GeorgeKonovalov/Daedalus-group---Maze-Solver---Team-Skynet/3D_Model/Downloaded files/switch/Renders/Render 1.jpg

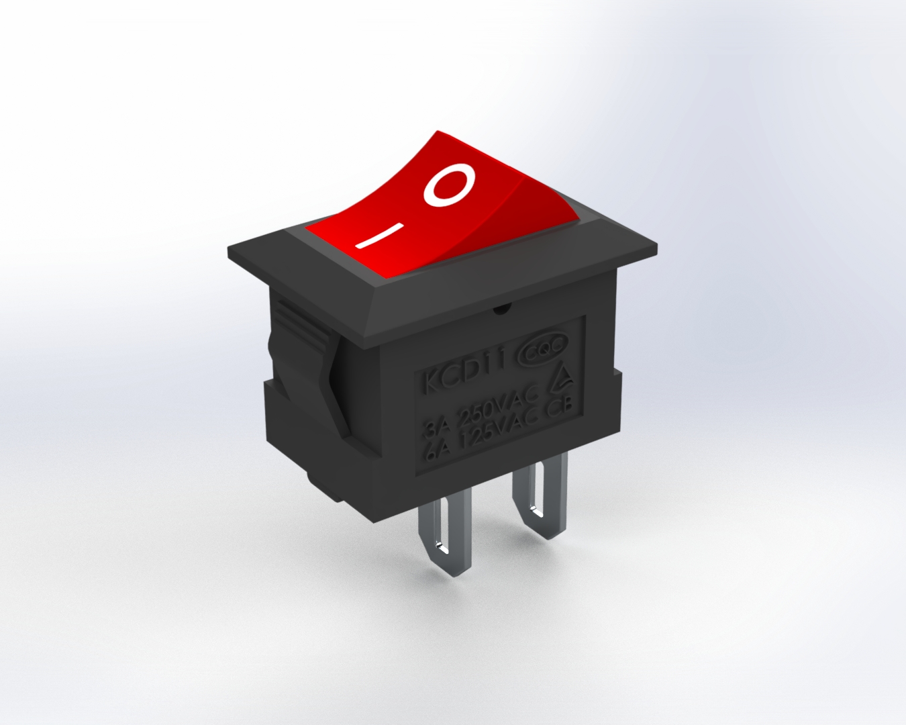
3D_Model/Downloaded files/switch/Renders/Render 1.jpg
