GeorgeKonovalov/Daedalus-group---Maze-Solver---Team-Skynet/3D_Model/Downloaded files/Servo/Renderings/Parallax Servo.PNG

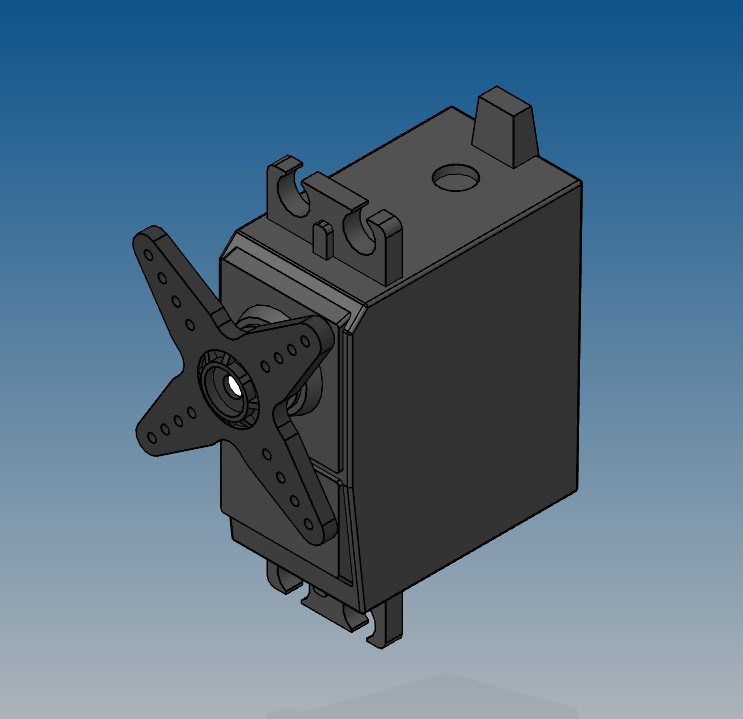
3D_Model/Downloaded files/Servo/Renderings/Parallax Servo.PNG
