GeorgeKonovalov/Daedalus-group---Maze-Solver---Team-Skynet/README.md

# Daedalus-group---Maze-Solver---Team-Skynet
2nd year project maze solver
