GeorgeKonovalov/Daedalus-group---Maze-Solver---Team-Skynet/3D_Model/Blueprint.png

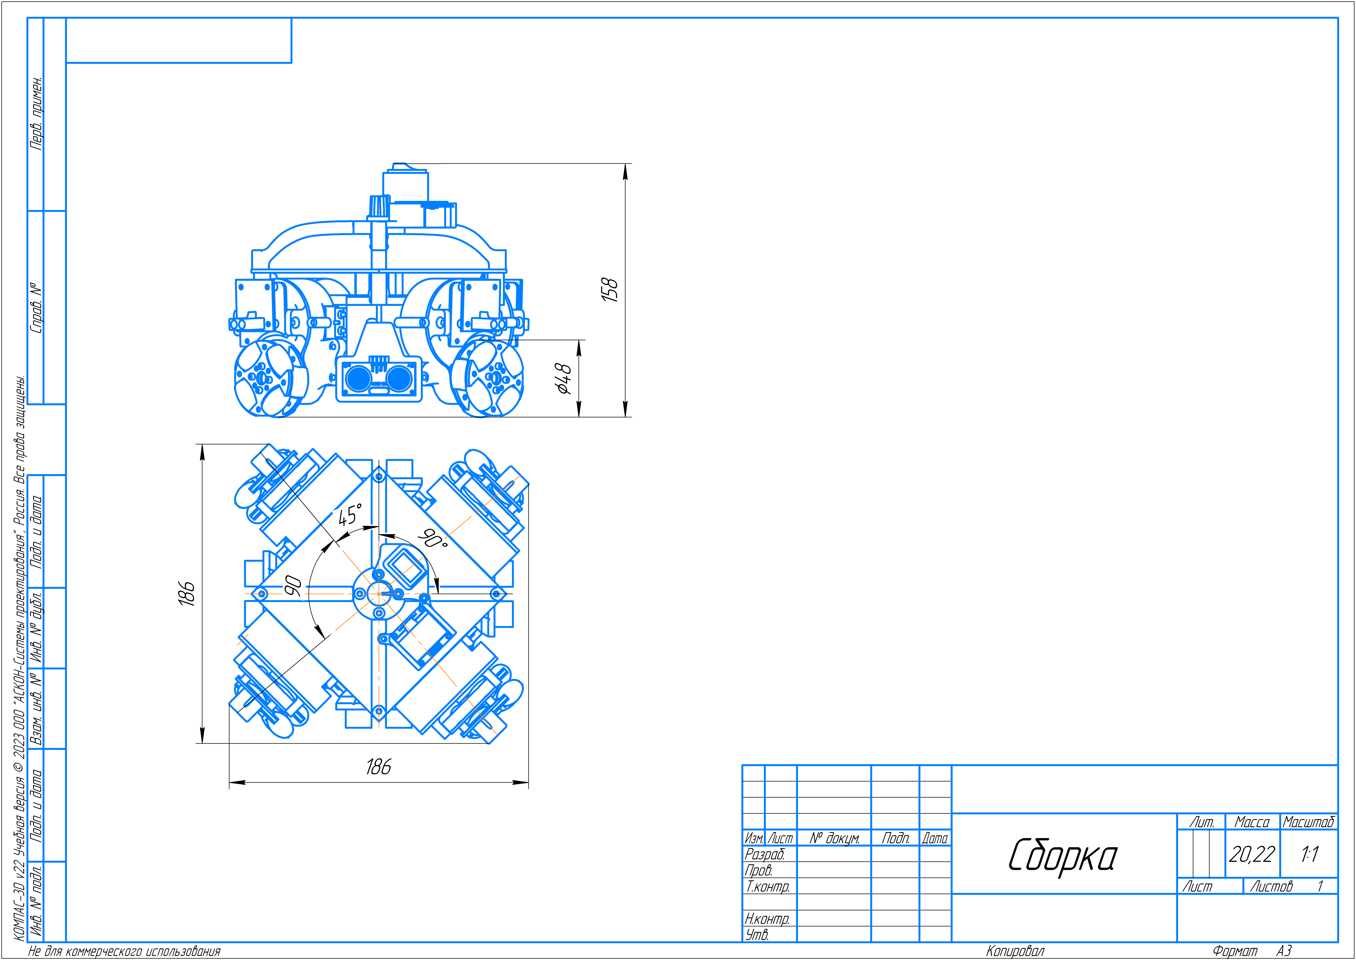
3D_Model/Blueprint.png
