GeorgeKonovalov/Daedalus-group---Maze-Solver---Team-Skynet/3D_Model/Downloaded files/knob/Потенциометр Ручка.JPG

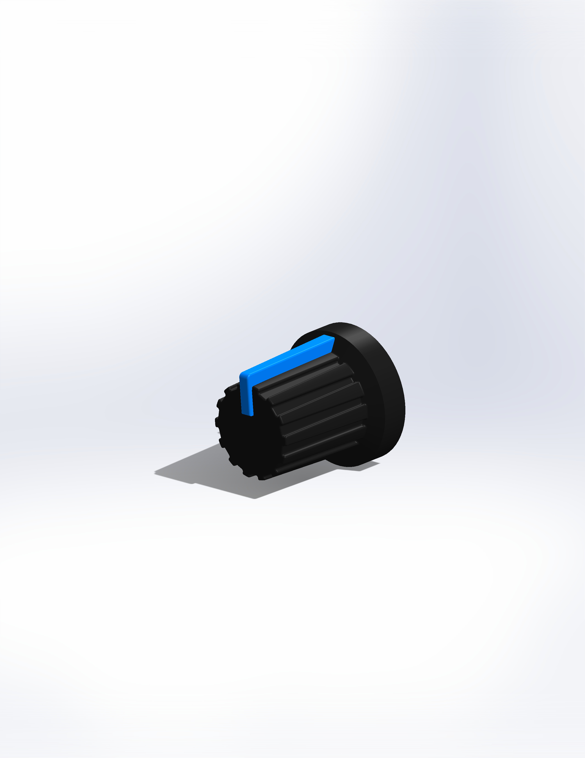
3D_Model/Downloaded files/knob/Потенциометр Ручка.JPG
