GeorgeKonovalov/Daedalus-group---Maze-Solver---Team-Skynet/3D_Model/Downloaded files/Omni/Untitled1.JPG

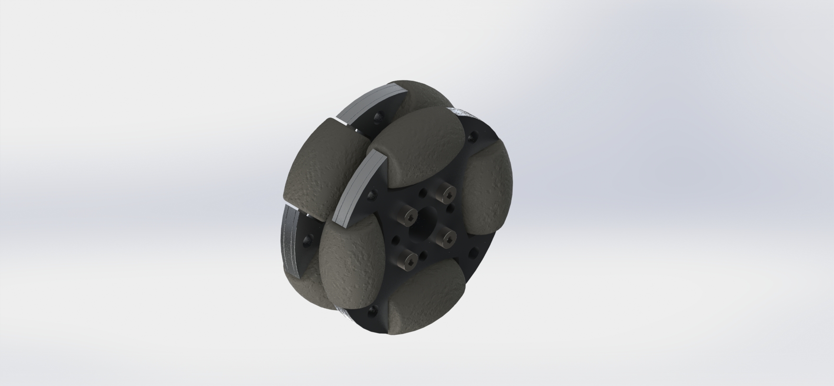
3D_Model/Downloaded files/Omni/Untitled1.JPG
