GeorgeKonovalov/Daedalus-group---Maze-Solver---Team-Skynet/3D_Model/Downloaded files/screws/M3.JPG

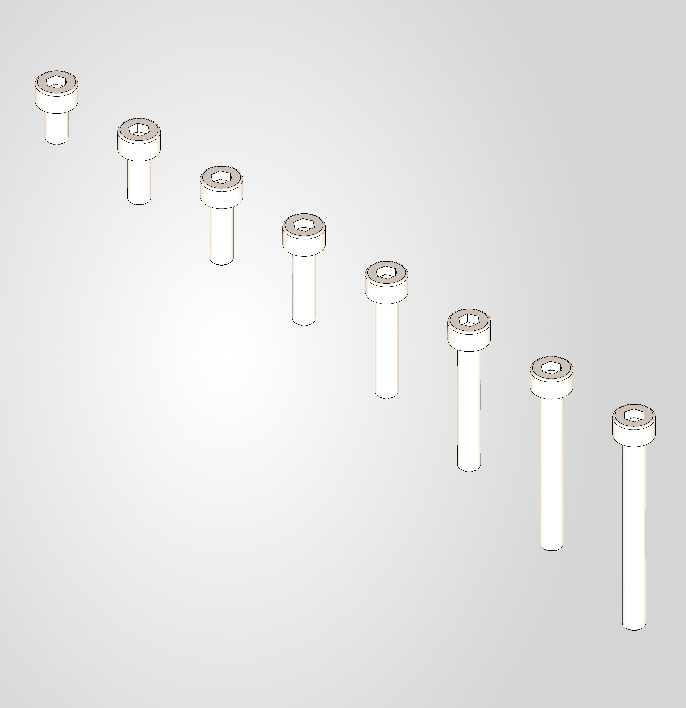
3D_Model/Downloaded files/screws/M3.JPG
