GeorgeKonovalov/Daedalus-group---Maze-Solver---Team-Skynet/3D_Model/Downloaded files/switch/Renders/Render 2.jpg

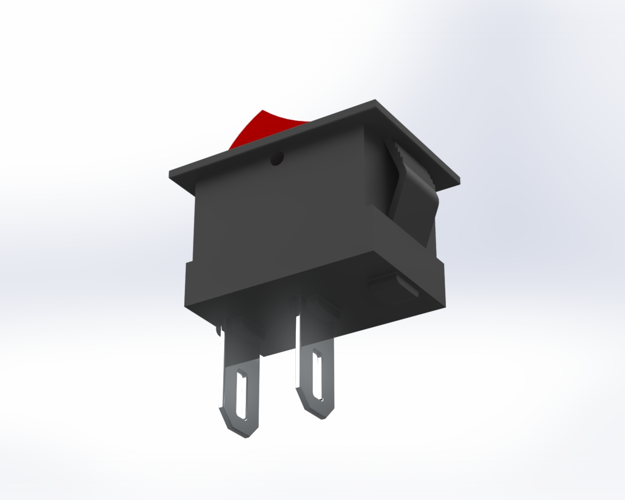
3D_Model/Downloaded files/switch/Renders/Render 2.jpg
