GeorgeKonovalov/Daedalus-group---Maze-Solver---Team-Skynet/Software/event_maze_solver.drawio.png

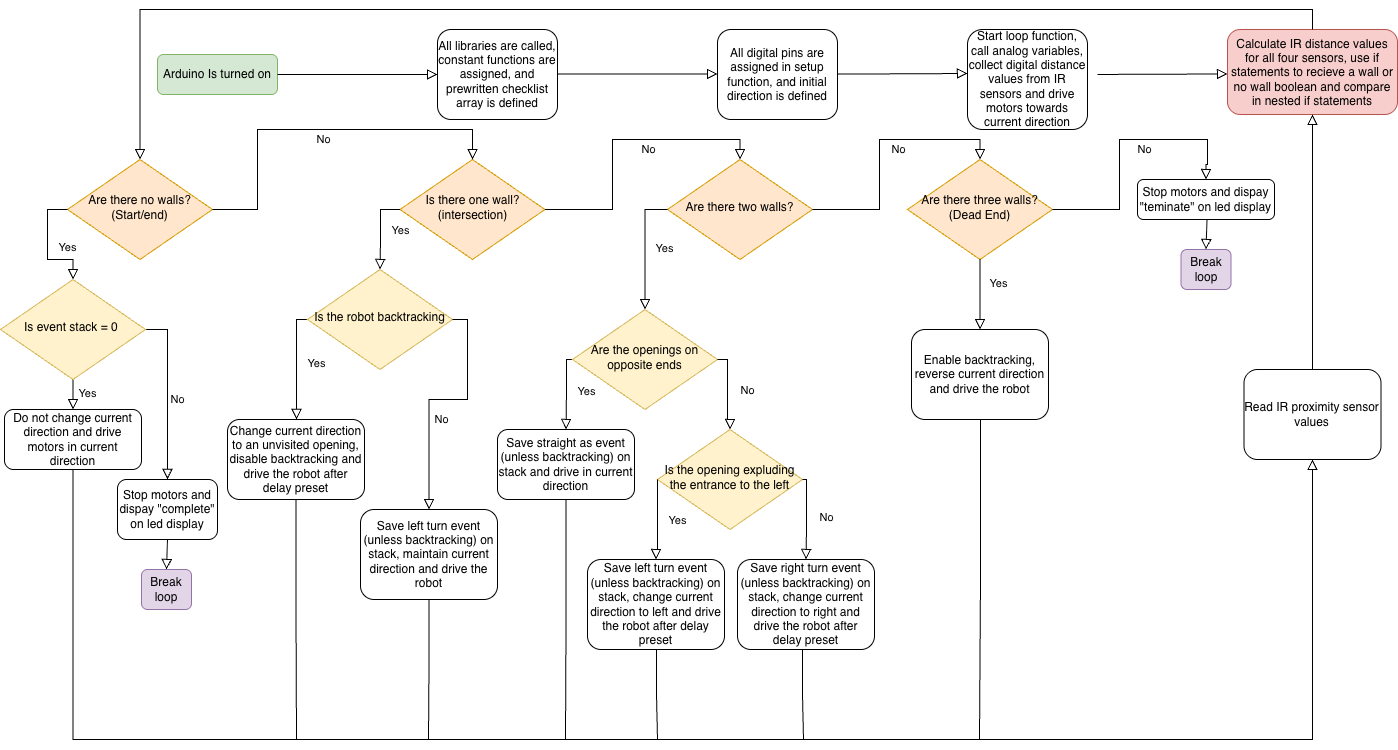
Software/event_maze_solver.drawio.png
