GeorgeKonovalov/Daedalus-group---Maze-Solver---Team-Skynet/Software/TEST Codes/RP2040/test_full/v_71/test_full_v67_deadend_ultra_start_2wall_zero_ramp/png/06_6_event_recognition_overview.png

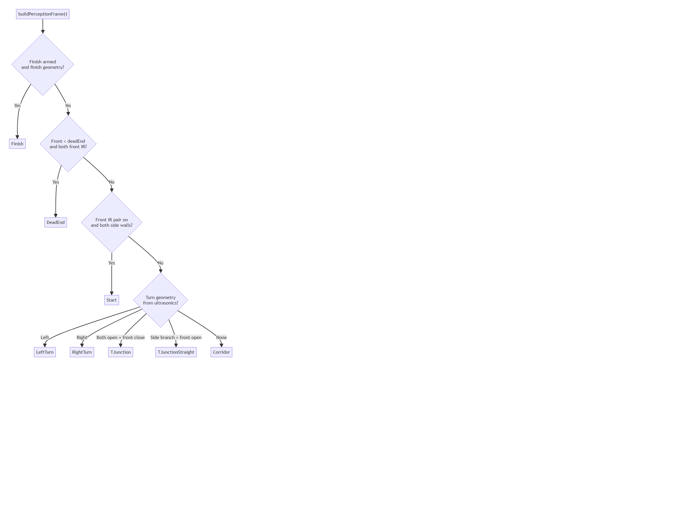
Software/TEST Codes/RP2040/test_full/v_71/test_full_v67_deadend_ultra_start_2wall_zero_ramp/png/06_6_event_recognition_overview.png
