GeorgeKonovalov/Daedalus-group---Maze-Solver---Team-Skynet/Software/TEST Codes/RP2040/test_full/v_71/test_full_v67_deadend_ultra_start_2wall_zero_ramp/png_logic_schemes/10_menu_architecture.png

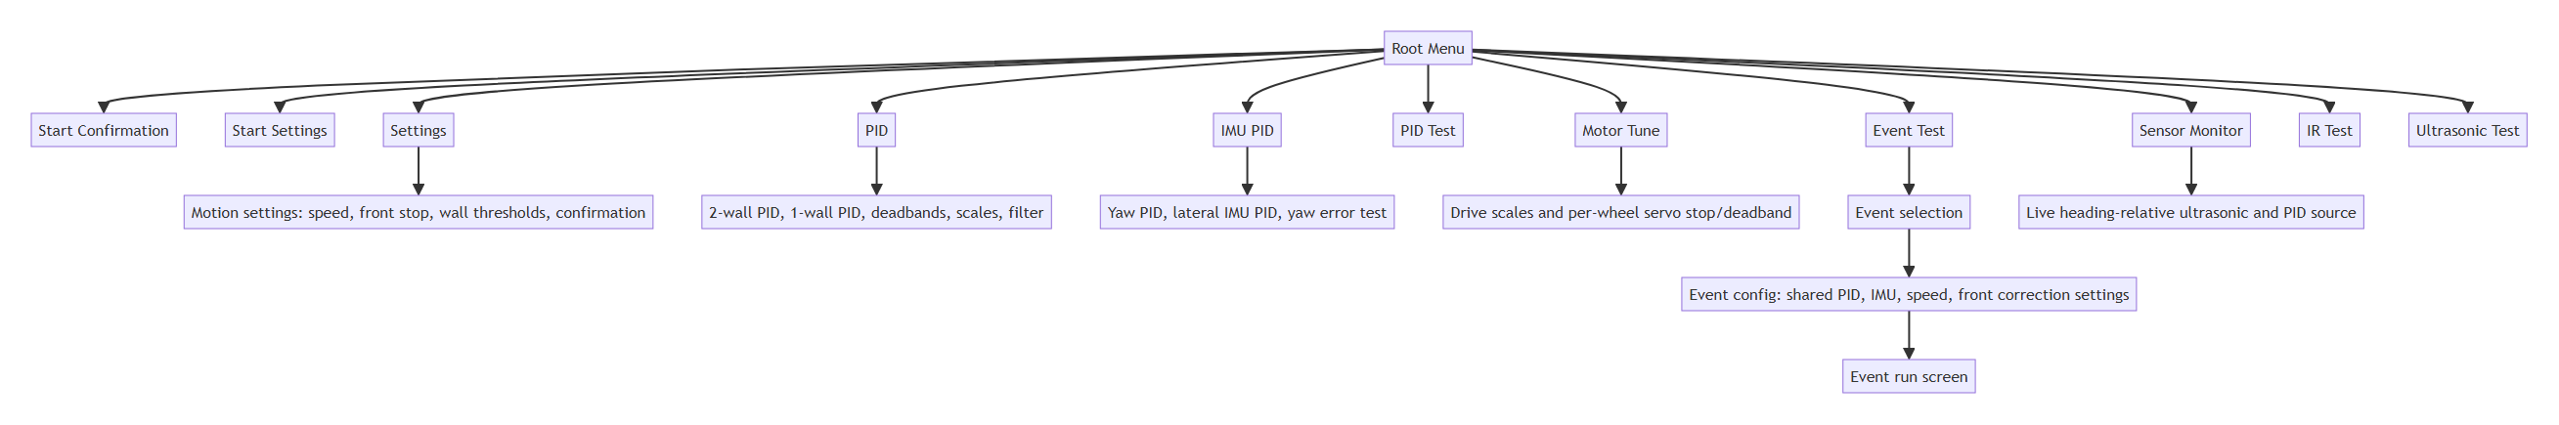
Software/TEST Codes/RP2040/test_full/v_71/test_full_v67_deadend_ultra_start_2wall_zero_ramp/png_logic_schemes/10_menu_architecture.png
