GeorgeKonovalov/Daedalus-group---Maze-Solver---Team-Skynet/3D_Model/Downloaded files/Omni/Roller_TPU_PLA/Assembled_roller_2_parts.stp

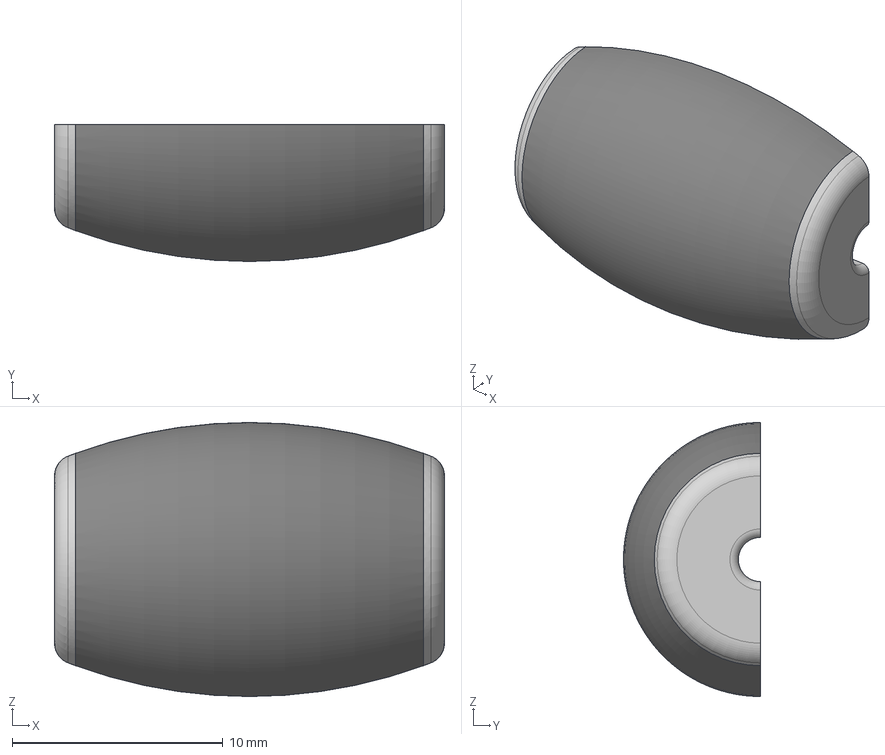
[picture p13: CAD file, 2026-04-03]
3D_Model/Downloaded files/Omni/Roller_TPU_PLA/Assembled_roller_2_parts.stp
18.5 x 6.50 x 13.0 mm
Roller
