GeorgeKonovalov/Daedalus-group---Maze-Solver---Team-Skynet/3D_Model/Downloaded files/Omni/Assembly48mm.STEP

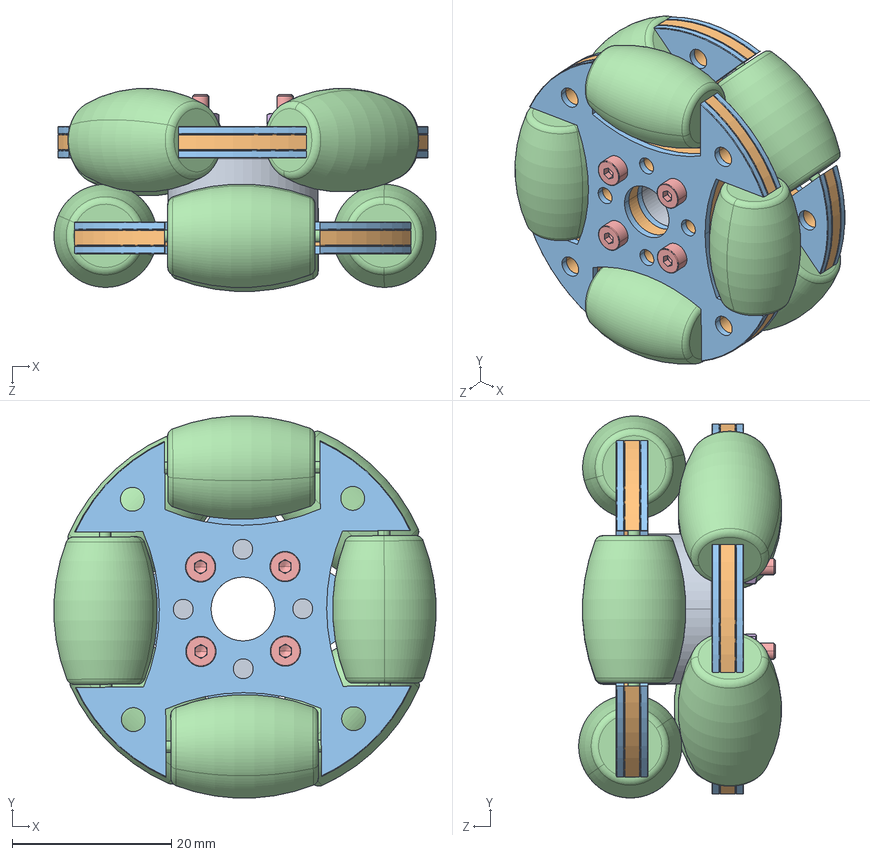
[picture p14: CAD file, 2026-02-12]
3D_Model/Downloaded files/Omni/Assembly48mm.STEP
47.9 x 47.9 x 25.4 mm
lock
Middle_2mm x 2
Middle_1mm x 4
Roller x 8
socket head cap screw_iso_ISO 4762 M2 x 20 - 16N x 4
hex nut style 1 gradeab_iso_ISO - 4032 - M2 - W - N x 4
