GeorgeKonovalov/Daedalus-group---Maze-Solver---Team-Skynet/3D_Model/Downloaded files/Omni/Roller_TPU_PLA/Assembled_roller_2_parts_renewed.stp

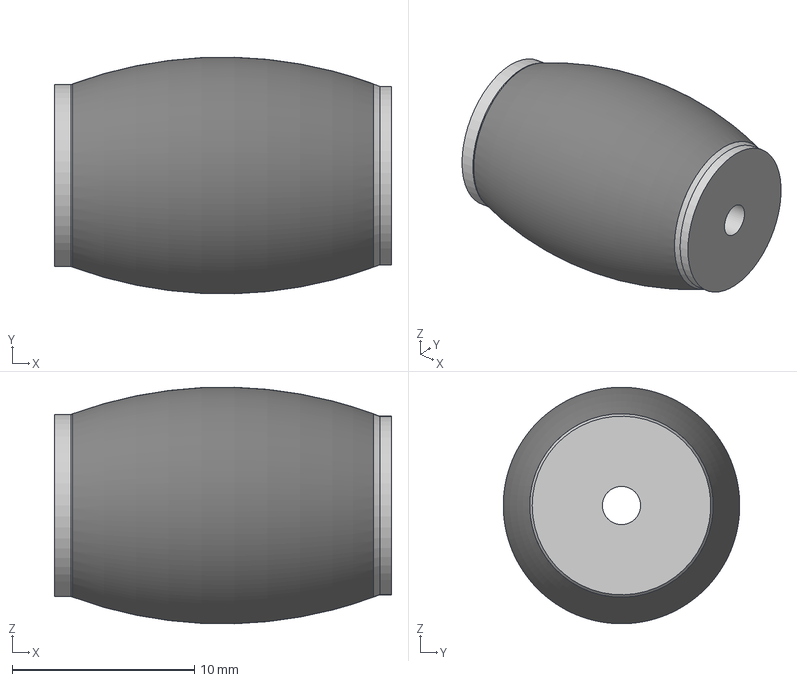
[picture p15: CAD file, 2026-04-03]
3D_Model/Downloaded files/Omni/Roller_TPU_PLA/Assembled_roller_2_parts_renewed.stp
18.5 x 13.0 x 13.0 mm
Roller
