GeorgeKonovalov/Daedalus-group---Maze-Solver---Team-Skynet/3D_Model/Battery/Battery_Cap.stl

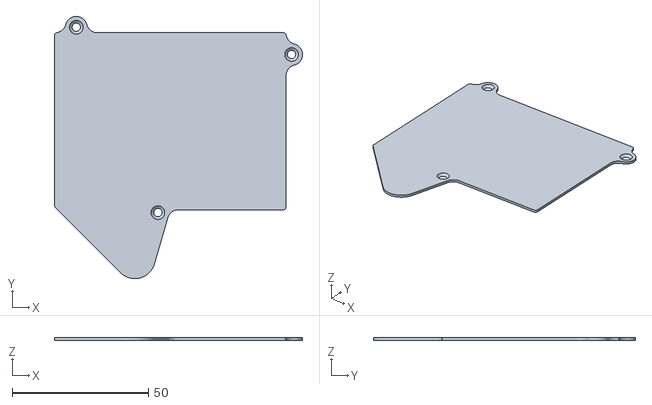
[picture p16: CAD file, 2026-02-12]
3D_Model/Battery/Battery_Cap.stl
91.0 x 96.2 x 1.00
