GeorgeKonovalov/Daedalus-group---Maze-Solver---Team-Skynet/3D_Model/Downloaded files/knob/Потенциометр Ручка.STEP

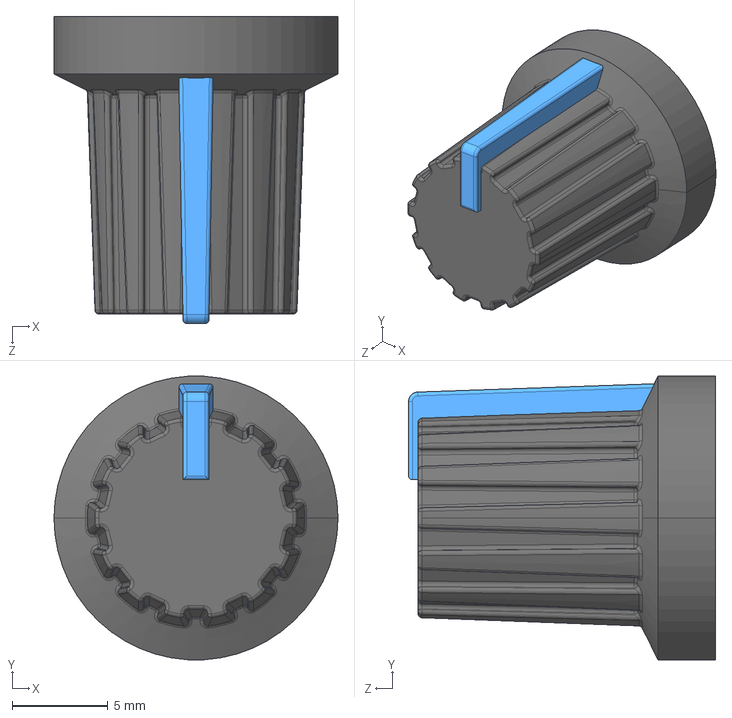
[picture p17: CAD file, 2026-04-20]
3D_Model/Downloaded files/knob/Потенциометр Ручка.STEP
14.8 x 14.8 x 16.0 mm
