GeorgeKonovalov/Daedalus-group---Maze-Solver---Team-Skynet/3D_Model/Downloaded files/Omni/lock.SLDPRT

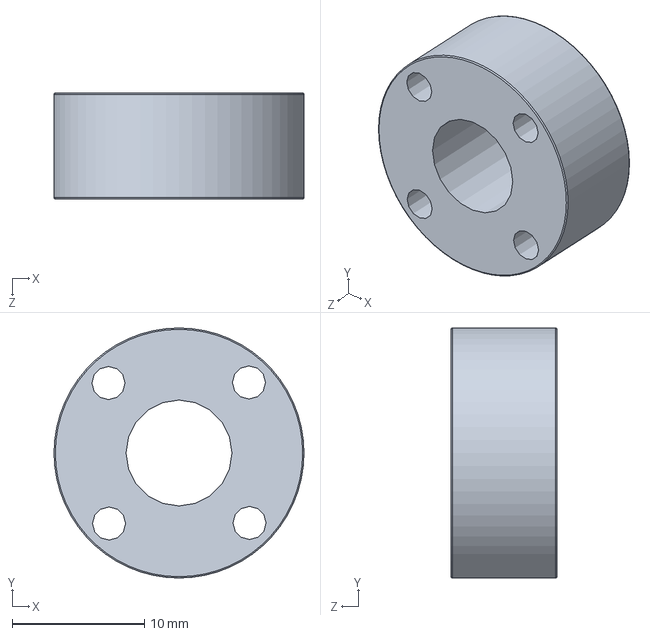
[picture p18: CAD file, 2026-02-12]
3D_Model/Downloaded files/Omni/lock.SLDPRT
18.9 x 18.9 x 8.00 mm
