GeorgeKonovalov/Daedalus-group---Maze-Solver---Team-Skynet/3D_Model/Downloaded files/switch/Power Switch.STEP

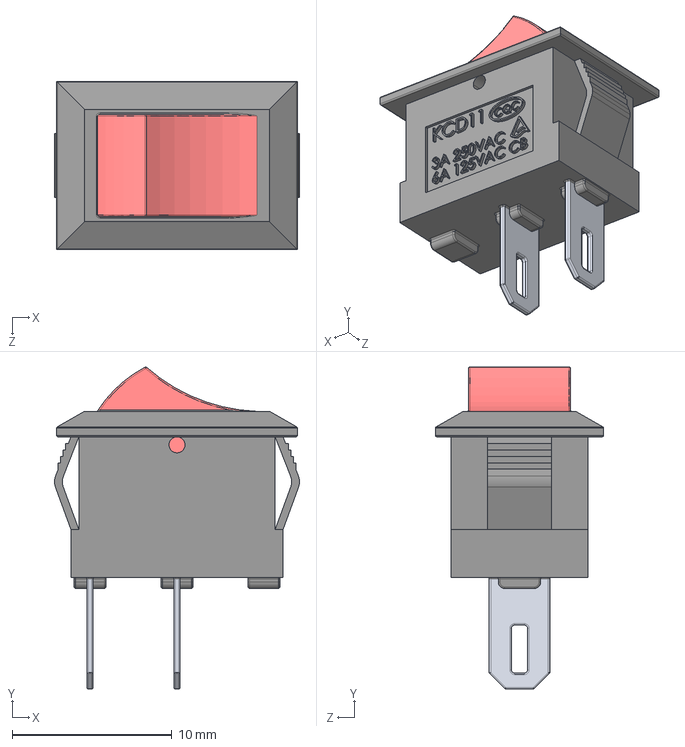
[picture p19: CAD file, 2026-04-20]
3D_Model/Downloaded files/switch/Power Switch.STEP
15.4 x 20.2 x 10.6 mm
