GeorgeKonovalov/Daedalus-group---Maze-Solver---Team-Skynet/3D_Model/Exp.print/H2D_5h11m_Rollers_PLA_TPU.3mf

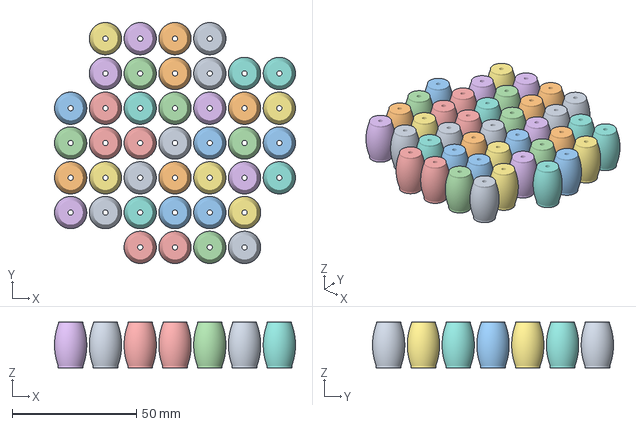
[picture p20: CAD file, 2026-04-03]
3D_Model/Exp.print/H2D_5h11m_Rollers_PLA_TPU.3mf
97.0 x 97.0 x 18.5 mm
Assembled_roller_2_parts_renewed.stp x 41
