GeorgeKonovalov/Daedalus-group---Maze-Solver---Team-Skynet/3D_Model/Shassis_Base/Mecanum_wheel_60mm_model_aprox.stl

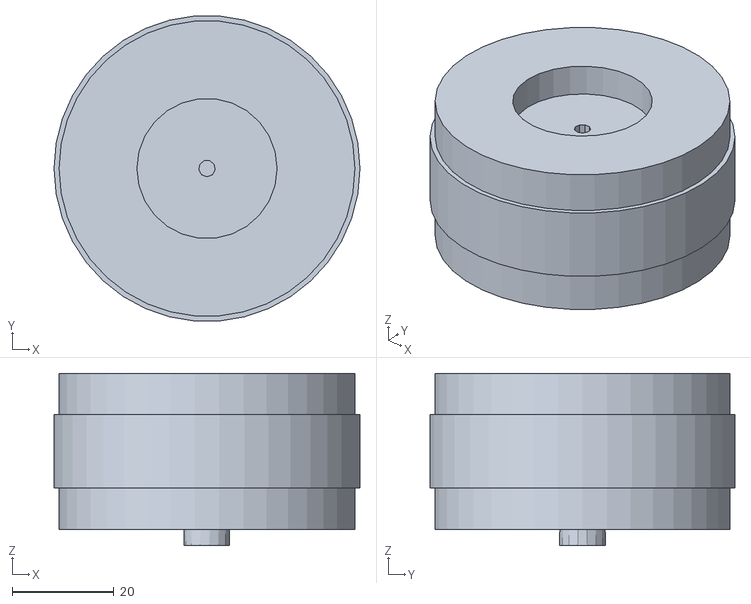
[picture p21: CAD file, 2025-11-28]
3D_Model/Shassis_Base/Mecanum_wheel_60mm_model_aprox.stl
60.0 x 59.8 x 33.8
