GeorgeKonovalov/Daedalus-group---Maze-Solver---Team-Skynet/3D_Model/STL_Prints/01.04.2026/Switch_toggle_Holder.stl

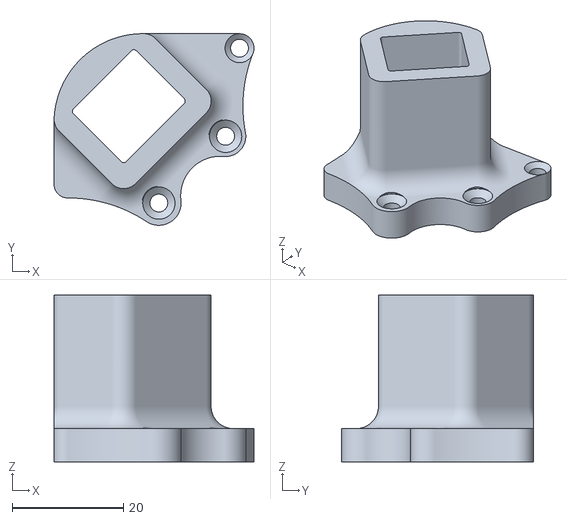
[picture p22: CAD file, 2026-04-06]
3D_Model/STL_Prints/01.04.2026/Switch_toggle_Holder.stl
35.9 x 34.4 x 30.0
