GeorgeKonovalov/Daedalus-group---Maze-Solver---Team-Skynet/3D_Model/STL_Prints/02.02.2026/Lead Gear.stl

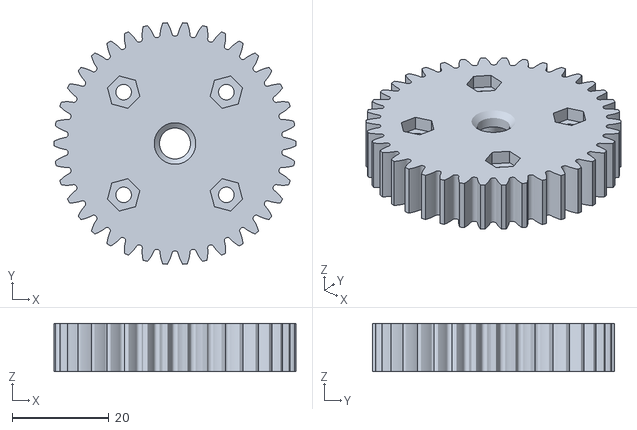
[picture p23: CAD file, 2026-02-12]
3D_Model/STL_Prints/02.02.2026/Lead Gear.stl
50.0 x 49.9 x 10.0
