GeorgeKonovalov/Daedalus-group---Maze-Solver---Team-Skynet/3D_Model/STL_Prints/02.03.2026/Middle_1.85mm.stl

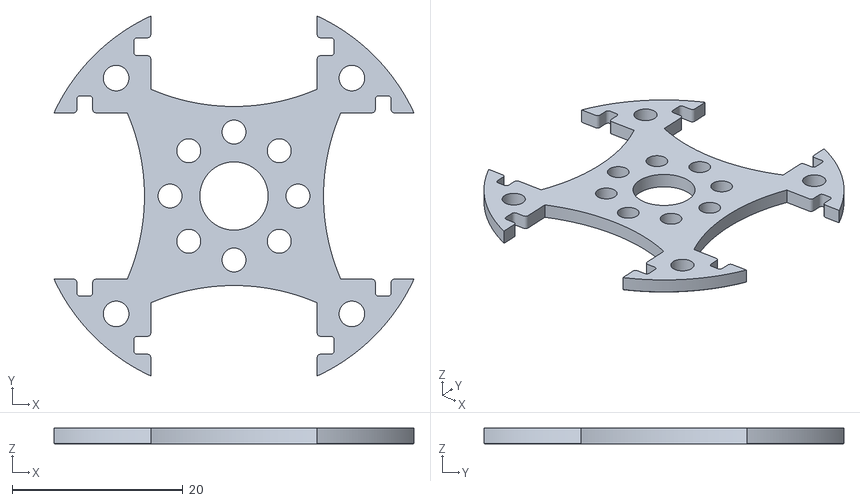
[picture p24: CAD file, 2026-04-03]
3D_Model/STL_Prints/02.03.2026/Middle_1.85mm.stl
42.2 x 42.2 x 1.85
