GeorgeKonovalov/Daedalus-group---Maze-Solver---Team-Skynet/3D_Model/STL_Prints/04.03.2026/49min_IR_PCB_holder.3mf

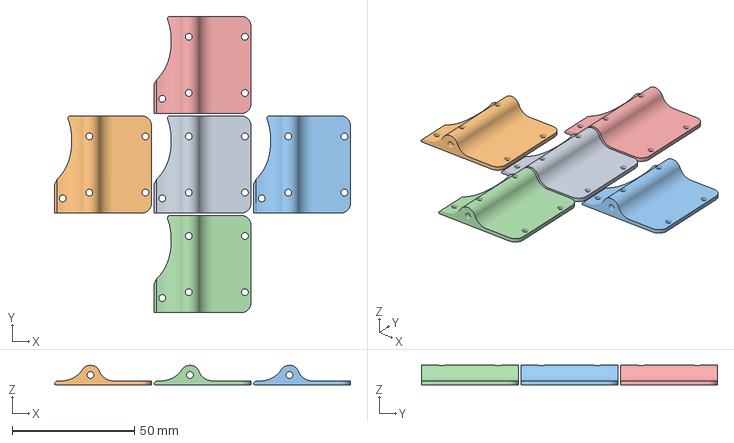
[picture p25: CAD file, 2026-04-03]
3D_Model/STL_Prints/04.03.2026/49min_IR_PCB_holder.3mf
121.2 x 121.4 x 8.00 mm
IR_PCB_holder.stl x 5
