GeorgeKonovalov/Daedalus-group---Maze-Solver---Team-Skynet/3D_Model/STL_Prints/07.02.2026/Middle_1mm.stl

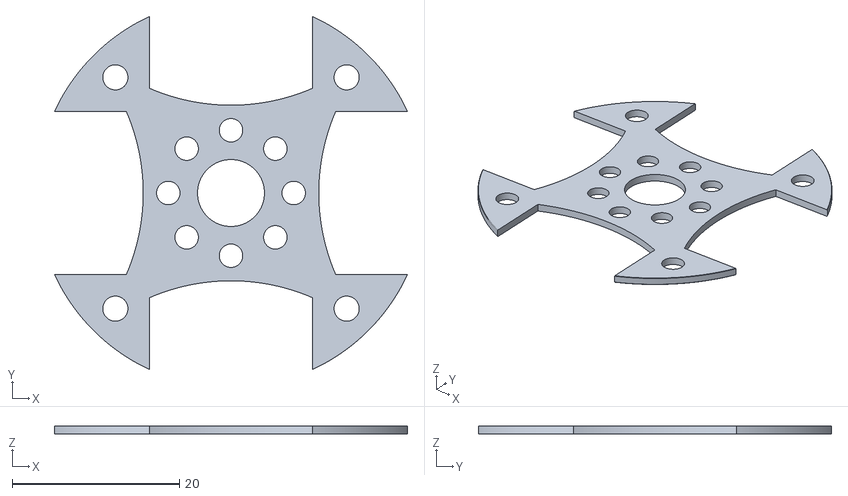
[picture p26: CAD file, 2026-02-12]
3D_Model/STL_Prints/07.02.2026/Middle_1mm.stl
42.2 x 42.2 x 1.00
