GeorgeKonovalov/Daedalus-group---Maze-Solver---Team-Skynet/3D_Model/STL_Prints/12.03.2026/Middle_1.85mm.stl

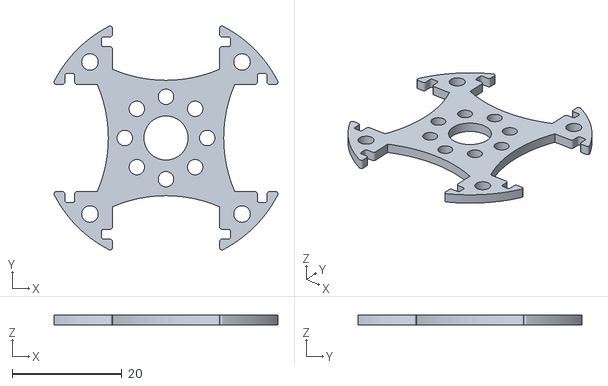
[picture p27: CAD file, 2026-04-03]
3D_Model/STL_Prints/12.03.2026/Middle_1.85mm.stl
40.7 x 40.7 x 1.80
