GeorgeKonovalov/Daedalus-group---Maze-Solver---Team-Skynet/3D_Model/STL_Prints/15.03.2026/Digipot_holder.stl

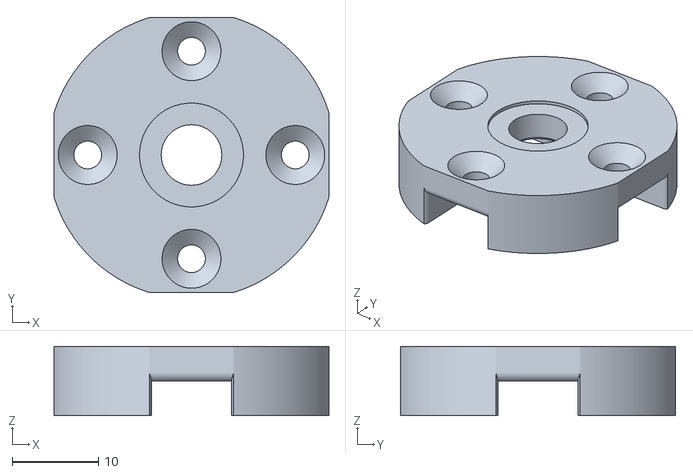
[picture p28: CAD file, 2026-04-03]
3D_Model/STL_Prints/15.03.2026/Digipot_holder.stl
31.8 x 31.8 x 8.00
