GeorgeKonovalov/Daedalus-group---Maze-Solver---Team-Skynet/3D_Model/STL_Prints/25.02.2026/Platform_PCB.stl

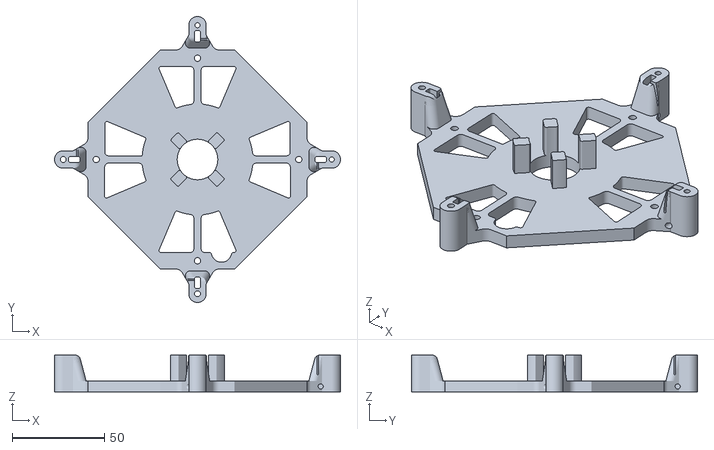
[picture p29: CAD file, 2026-04-03]
3D_Model/STL_Prints/25.02.2026/Platform_PCB.stl
155.2 x 155.2 x 20.0
