GeorgeKonovalov/Daedalus-group---Maze-Solver---Team-Skynet/3D_Model/Downloaded files/switch/elec switch.SLDPRT

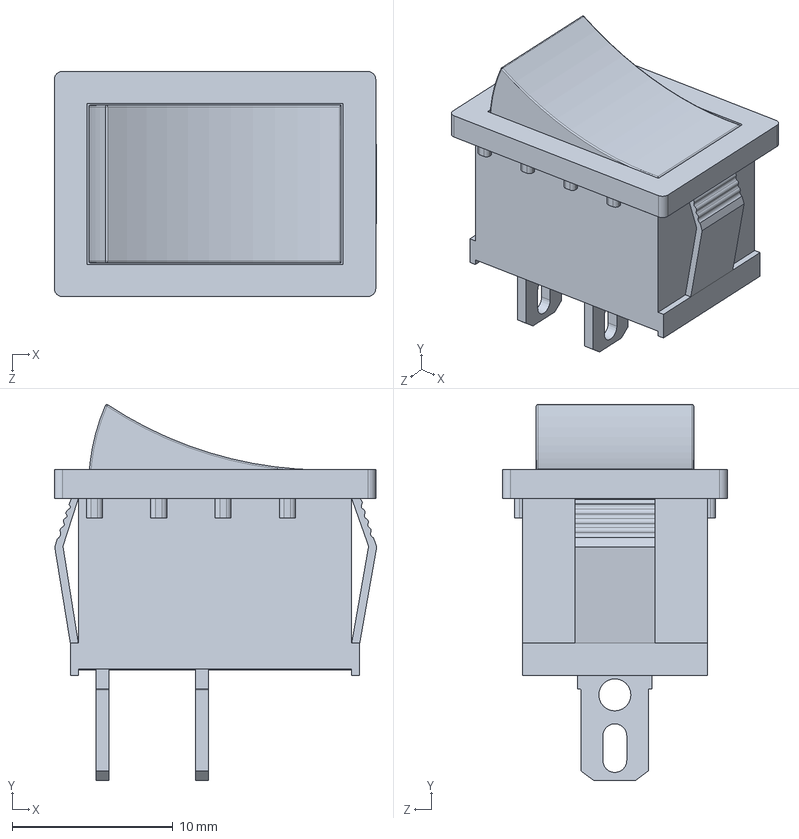
[picture p30: CAD file, 2026-04-20]
3D_Model/Downloaded files/switch/elec switch.SLDPRT
20.1 x 23.4 x 14.0 mm
