GeorgeKonovalov/Daedalus-group---Maze-Solver---Team-Skynet/3D_Model/STL_Prints/02.03.2026/53min_Middle_1.85mm_.3mf

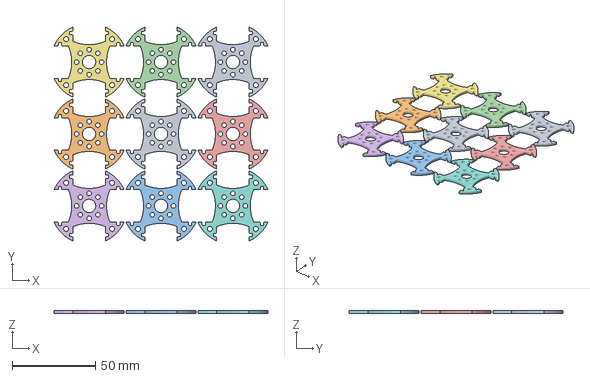
[picture p31: CAD file, 2026-04-03]
3D_Model/STL_Prints/02.03.2026/53min_Middle_1.85mm_.3mf
128.6 x 128.6 x 1.85 mm
Middle_1.85mm.stl x 9
