GeorgeKonovalov/Daedalus-group---Maze-Solver---Team-Skynet/3D_Model/STL_Prints/04.03.2026/IR_PCB_holder.stl

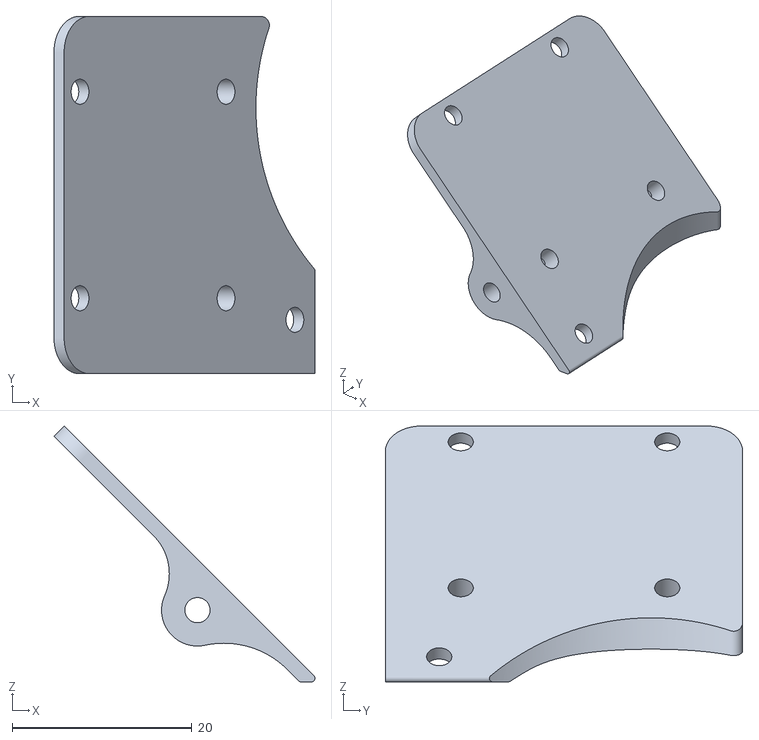
[picture p32: CAD file, 2026-04-03]
3D_Model/STL_Prints/04.03.2026/IR_PCB_holder.stl
29.1 x 39.8 x 28.5
