GeorgeKonovalov/Daedalus-group---Maze-Solver---Team-Skynet/3D_Model/STL_Prints/07.02.2026/Gearbox_Housing_Cap.stl

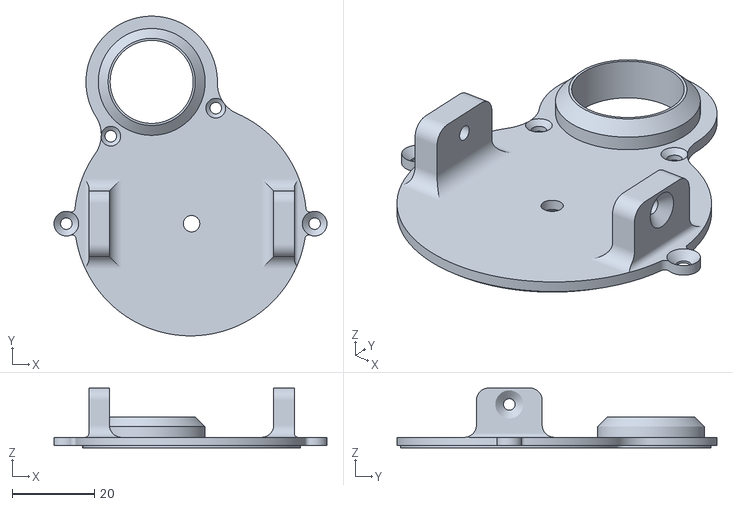
[picture p33: CAD file, 2026-02-12]
3D_Model/STL_Prints/07.02.2026/Gearbox_Housing_Cap.stl
66.5 x 77.8 x 14.6
