GeorgeKonovalov/Daedalus-group---Maze-Solver---Team-Skynet/3D_Model/STL_Prints/12.03.2026/1hour57minutes.3mf

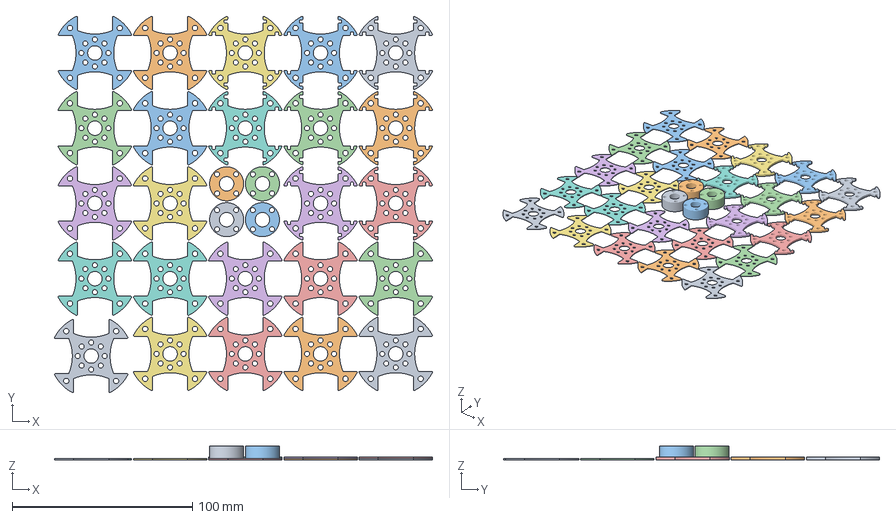
[picture p34: CAD file, 2026-04-03]
3D_Model/STL_Prints/12.03.2026/1hour57minutes.3mf
209.7 x 208.9 x 8.00 mm
Middle_1.80mm_cut.stl x 8
Middle_1mm_cut_45.6.stl x 16
lock.stl x 4
