GeorgeKonovalov/Daedalus-group---Maze-Solver---Team-Skynet/3D_Model/Downloaded files/Omni/Roller.SLDPRT

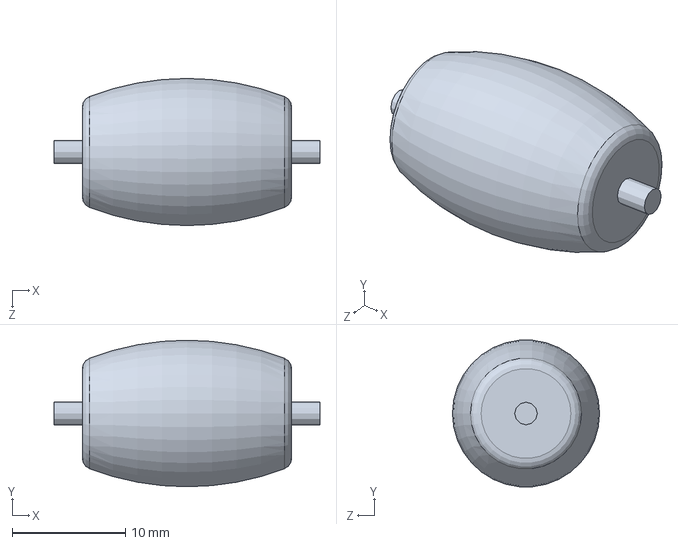
[picture p35: CAD file, 2026-02-12]
3D_Model/Downloaded files/Omni/Roller.SLDPRT
23.5 x 12.9 x 13.0 mm
