GeorgeKonovalov/Daedalus-group---Maze-Solver---Team-Skynet/3D_Model/STL_Prints/02.02.2026/Lead_Gear_Cap.stl

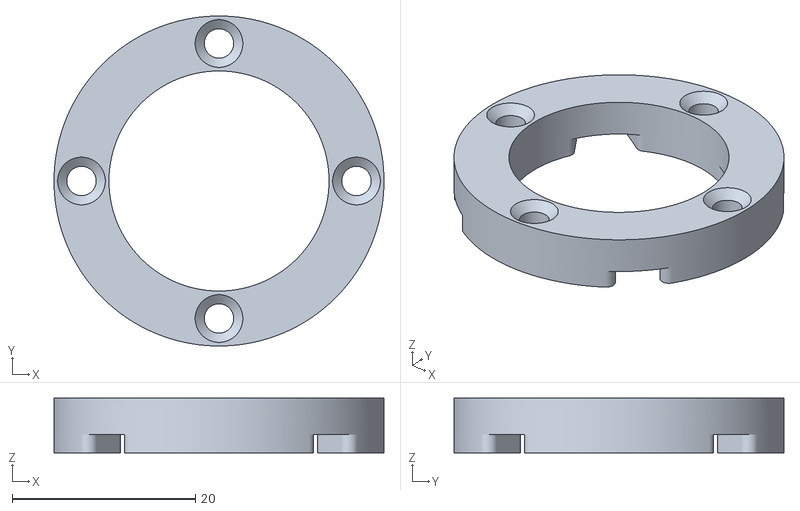
[picture p37: CAD file, 2026-02-12]
3D_Model/STL_Prints/02.02.2026/Lead_Gear_Cap.stl
36.0 x 36.0 x 6.00
