GeorgeKonovalov/Daedalus-group---Maze-Solver---Team-Skynet/3D_Model/STL_Prints/12.03.2026/Middle_1mm_cut_45.6.stl

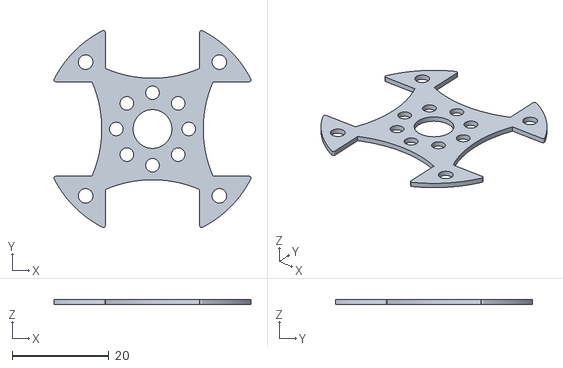
[picture p39: CAD file, 2026-04-03]
3D_Model/STL_Prints/12.03.2026/Middle_1mm_cut_45.6.stl
40.7 x 40.7 x 1.00
