GeorgeKonovalov/Daedalus-group---Maze-Solver---Team-Skynet/3D_Model/Downloaded files/Omni/Middle_2mm.SLDPRT

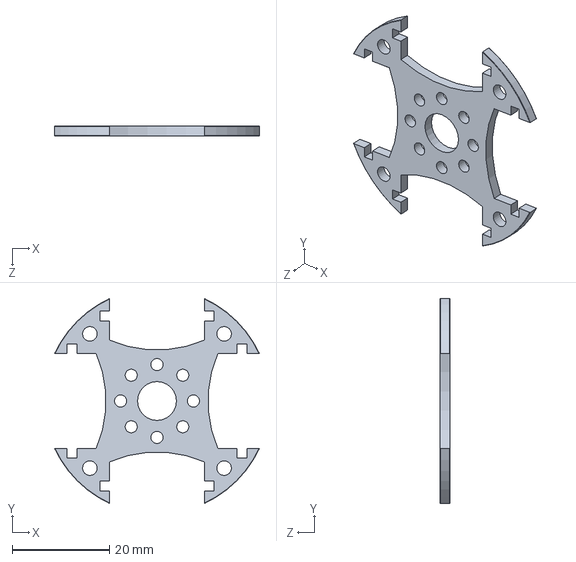
[picture p40: CAD file, 2026-02-12]
3D_Model/Downloaded files/Omni/Middle_2mm.SLDPRT
42.2 x 42.2 x 2.00 mm
