GeorgeKonovalov/Daedalus-group---Maze-Solver---Team-Skynet/3D_Model/STL_Prints/02.02.2026/Roller_2.4.stl

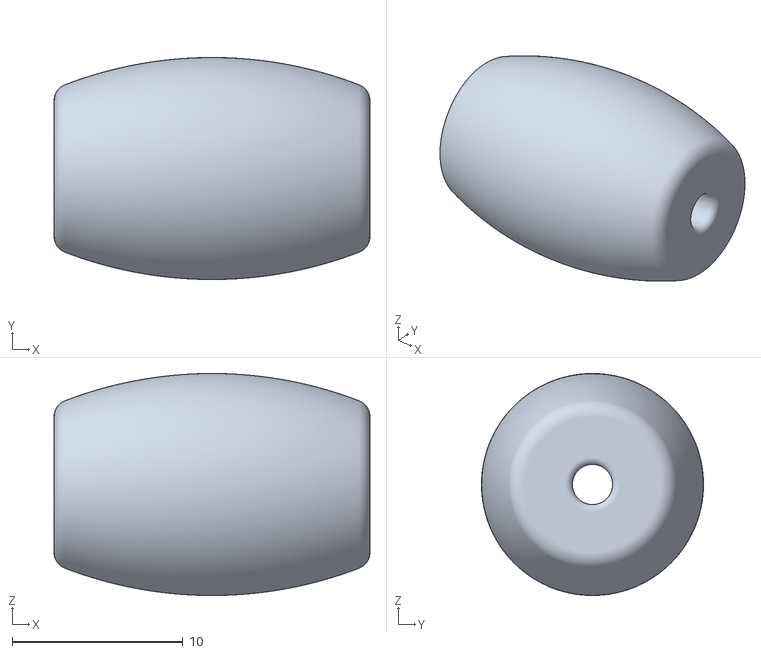
[picture p41: CAD file, 2026-02-12]
3D_Model/STL_Prints/02.02.2026/Roller_2.4.stl
18.5 x 13.0 x 13.0
