GeorgeKonovalov/Daedalus-group---Maze-Solver---Team-Skynet/(list of files, cad)

Other CAD files:
3D_Model/STL_Prints/01.04.2026/25m_PLA.3mf
3D_Model/STL_Prints/02.02.2026/Battery_Cap.stl
3D_Model/Downloaded files/Omni/Middle_1mm.SLDPRT
3D_Model/Battery/Battery.prt
3D_Model/Downloaded files/Omni/Assembly48mm.SLDASM
3D_Model/Downloaded files/Servo/Renderings/Lead_Gear.prt
3D_Model/Downloaded files/Servo/Renderings/Parallax-Servo-ASM_asm.prt
3D_Model/Downloaded files/screws/DIN-912-M3.STEP
3D_Model/Downloaded files/screws/M3-NUTS.STEP
3D_Model/Downloaded files/switch/Power Switch.SLDPRT
3D_Model/Downloaded files/switch/Power Switch.STL
3D_Model/Shassis_Base/Base Wheel.prt
