GeorgeKonovalov/Daedalus-group---Maze-Solver---Team-Skynet/Software/TEST Codes/RP2040/test_full/test_full_v64_execresume/test_full_v64_execresume_parameters.xlsx

Parameter | Current/Default Value | Description | Units | Menu Location | Code Location | Notes
FrontStop | 15 | Hard stop threshold. When front drops below this value, the robot enters the correction stage. | cm | Settings / Event Test Config | RuntimeSettings, RuntimeConfig, updateExecutive(), updateEventTestRun() | v64 keeps the strict front < FrontStop rule, then releases immediately after correction using the confirmed event.
Front Hold Ref | 3.5 | Target front distance used by the front PID while stopped in non-dead-end correction. | cm | Settings / Event Test Config | computeFrontNormalizedError(), computeFrontPidCorrection(), frontNormalizationComplete() | Used only during correction; dead-end normalization still excludes front hold.
WallThreshold | 16 | Side-wall threshold for wall presence and correction-stage ultrasonic dead-end confirmation. | cm | Settings / Event Test Config | classifyCandidateEvent(), choosePidSource(), correctionStageUltrasonicDeadEndDetected() | Correction-stage dead-end requires front, left, and right all below this threshold.
DeadEndThreshold | 20 | Legacy dead-end threshold used together with both front IR sensors. | cm | Settings / Event Test Config | classifyCandidateEvent(), legacyDeadEndStopTriggered() | Legacy dead-end trigger still blocks correction-stage event overrides.
Match N | 2 | Number of matching observations required to confirm a correction-stage event. | count | IR Sensor Test / Event Test Config | updateEventConfirmState() | Used for left, right, T-junction, and correction-stage dead-end confirmation.
Check gap | 0.01 | Delay between confirmation samples. | s | IR Sensor Test / Event Test Config | updateEventConfirmState(), updateCorridorConfirmState() | Lower values confirm faster but reduce noise immunity.
2-wall P | 0.25 | Two-wall PID proportional gain. | normalized | PID / Event Test Config | RuntimeSettings, RuntimeConfig, commitRuntimeConfig(), computePidWithRuntime() | Renewed default kept from the prior stop-confirm update.
2-wall D | 0.02 | Two-wall PID derivative gain. | normalized | PID / Event Test Config | RuntimeSettings, RuntimeConfig, commitRuntimeConfig(), computePidWithRuntime() | Renewed default kept from the prior stop-confirm update.
IMU P | 3.9 | Yaw-hold proportional gain. | normalized | IMU PID Menu / Event Test Config | RuntimeSettings, RuntimeConfig, commitRuntimeConfig(), currentImuRotationCompensation() | Current default preserved in v64.
IMU I | 1.7 | Yaw-hold integral gain. | normalized | IMU PID Menu / Event Test Config | RuntimeSettings, RuntimeConfig, commitRuntimeConfig(), currentImuRotationCompensation() | Current default preserved in v64.
Front PID P | 0.15 | Front-distance proportional gain used during stopped correction. | normalized | Settings / Event Test Config | commitRuntimeConfig(), computeFrontPidCorrection() | Renewed default preserved in v64.
Front PID D | 0.04 | Front-distance derivative gain used during stopped correction. | normalized | Settings / Event Test Config | commitRuntimeConfig(), computeFrontPidCorrection() | Renewed default preserved in v64.
correctionConfirmEnabled | Runtime flag | Allows stopped correction to confirm and override the pending event. | flag | Internal only | ExecutiveState / PreviewState / EventTestState, FrontNormalize flows | False for legacy dead-end stops, true for turn-triggered or plain FrontStop-triggered correction.
postCorrectionReleaseActive | Runtime flag | Short release guard after correction so the newly confirmed event actually takes over before the next stop gate can re-trigger. | flag | Internal only | holdPostCorrectionRelease(), AcquireCorridor in preview/runtime/event-test flows | Added in v64 to stop the correction-complete -> immediate-stop loop.
overallSpeedActual | 0 in FrontNormalize | Live execution speed used by the drive path. | runtime | Internal only | setOverallSpeedActual(), updateOverallSpeedActualForState(), driveBodyFrameLimited() | Correction runs with overallSpeedActual forced to zero.
