GeorgeKonovalov/Daedalus-group---Maze-Solver---Team-Skynet/Software/TEST Codes/RP2040/test_full/test_full_v66_startcorr/test_full_v66_startcorr_parameters.xlsx

Parameter | Current/Default Value | Description | Units | Menu Location | Code Location | Notes
Overall Start | 0.2 | Start-limited live speed used when execution begins and now again after Start correction completes. | normalized | Start Settings / Event Test Config | initializeRuntimeOverallSpeed(), updateExecutive(), updatePreviewExecution(), updateEventTestRun() | In v66 the start ramp does not begin until Start correction has finished; this value is reloaded immediately before ramped release.
Overall Ramp K | 2 | Linear ramp slope that raises overallSpeedActual toward the configured Overall speed. | speed units/s | Start Settings / Event Test Config | updateOverallSpeedActualForState() | v66 keeps the same ramp law but shifts its start point to after the new Start correction stage.
FrontStop | 15 | Hard stop threshold. When front drops below this value, the robot enters the correction stage. | cm | Settings / Event Test Config | RuntimeSettings, RuntimeConfig, updateExecutive(), updateEventTestRun() | Unchanged for normal event handling. The new v66 change is only that Start now corrects before the ramp resumes.
Front Hold Ref | 3.5 | Target front distance used by the front PID while stopped in non-dead-end correction. | cm | Settings / Event Test Config | computeFrontNormalizedError(), computeFrontPidCorrection(), frontNormalizationComplete() | Used by turn-style correction. In v66 Start is excluded from front hold and uses wall/yaw correction only.
WallThreshold | 16 | Side-wall threshold for wall presence and correction-stage ultrasonic dead-end confirmation. | cm | Settings / Event Test Config | classifyCandidateEvent(), choosePidSource(), correctionStageUltrasonicDeadEndDetected() | Still governs wall presence and the correction-stage all-ultrasonic dead-end rule.
DeadEndThreshold | 20 | Legacy dead-end threshold used together with both front IR sensors. | cm | Settings / Event Test Config | classifyCandidateEvent(), legacyDeadEndStopTriggered() | Legacy dead-end handling remains unchanged; v66 only blocks Start correction from being promoted into dead-end.
Match N | 2 | Number of matching observations required to confirm a correction-stage event. | count | IR Sensor Test / Event Test Config | updateEventConfirmState() | Still used for correction-stage confirmation of turn/dead-end events.
Check gap | 0.01 | Delay between confirmation samples. | s | IR Sensor Test / Event Test Config | updateEventConfirmState(), updateCorridorConfirmState() | Lower values confirm faster but reduce noise immunity.
1-wall P | 0.35 | One-wall PID proportional gain. | normalized | PID / Event Test Config | RuntimeSettings, RuntimeConfig, commitRuntimeConfig(), computePidWithRuntime() | Current renewed default preserved.
1-wall D | 0.04 | One-wall PID derivative gain. | normalized | PID / Event Test Config | RuntimeSettings, RuntimeConfig, commitRuntimeConfig(), computePidWithRuntime() | Current renewed default preserved.
2-wall P | 0.25 | Two-wall PID proportional gain. | normalized | PID / Event Test Config | RuntimeSettings, RuntimeConfig, commitRuntimeConfig(), computePidWithRuntime() | Renewed default kept from the prior runtime updates.
2-wall D | 0.02 | Two-wall PID derivative gain. | normalized | PID / Event Test Config | RuntimeSettings, RuntimeConfig, commitRuntimeConfig(), computePidWithRuntime() | Renewed default kept from the prior runtime updates.
IMU P | 3.9 | Yaw-hold proportional gain. | normalized | IMU PID Menu / Event Test Config | RuntimeSettings, RuntimeConfig, commitRuntimeConfig(), currentImuRotationCompensation() | Current default preserved.
IMU I | 1.7 | Yaw-hold integral gain. | normalized | IMU PID Menu / Event Test Config | RuntimeSettings, RuntimeConfig, commitRuntimeConfig(), currentImuRotationCompensation() | Current default preserved.
Front PID P | 0.15 | Front-distance proportional gain used during stopped correction. | normalized | Settings / Event Test Config | commitRuntimeConfig(), computeFrontPidCorrection() | Still used for turn-style correction. Start correction bypasses this in v66.
Front PID D | 0.04 | Front-distance derivative gain used during stopped correction. | normalized | Settings / Event Test Config | commitRuntimeConfig(), computeFrontPidCorrection() | Still used for turn-style correction. Start correction bypasses this in v66.
correctionConfirmEnabled | Runtime flag | Allows stopped correction to confirm and override the pending event. | flag | Internal only | ExecutiveState / PreviewState / EventTestState, FrontNormalize flows | False during Start correction in v66 because Start is already confirmed and only needs settling before release.
postCorrectionReleaseActive | Runtime flag | Release guard that lets the robot depart after correction without being trapped immediately back into FrontStop. | flag | Internal only | holdPostCorrectionRelease(), AcquireCorridor in preview/runtime/event-test flows | Reused in v66 after Start correction so the robot can depart cleanly before normal corridor flow resumes.
overallSpeedActual | 0 in FrontNormalize | Live execution speed used by the drive path. | runtime | Internal only | setOverallSpeedActual(), initializeRuntimeOverallSpeed(), updateOverallSpeedActualForState(), driveBodyFrameLimited() | Forced to 0 during correction. In v66 it is explicitly reset to Overall Start after Start correction, then ramped upward.
