GeorgeKonovalov/Daedalus-group---Maze-Solver---Team-Skynet/Software/TEST Codes/RP2040/test_full/test_full_v68_startrelease/test_full_v68_startrelease_parameters.xlsx

Parameter | Current/Default Value | Description | Units | Menu Location | Code Location | Notes
Overall Start | 0.2 | Start-limited live speed used when execution begins and again after Start correction completes. | normalized | Start Settings / Event Test Config | initializeRuntimeOverallSpeed(), updateExecutive(), updatePreviewExecution(), updateEventTestRun() | Unchanged from v66: the start ramp begins only after Start correction has finished.
Overall Ramp K | 2 | Linear ramp slope that raises overallSpeedActual toward the configured Overall speed. | speed units/s | Start Settings / Event Test Config | updateOverallSpeedActualForState() | Unchanged from v66.
FrontStop | 15 | Hard stop threshold. When front drops below this value, the robot enters the correction stage. | cm | Settings / Event Test Config | RuntimeSettings, RuntimeConfig, updateExecutive(), updateEventTestRun() | Still the stop gate for correction. v67 changes only how dead-end can override after that stop.
Front Hold Ref | 3.5 | Target front distance used by the front PID while stopped in non-dead-end correction. | cm | Settings / Event Test Config | computeFrontNormalizedError(), computeFrontPidCorrection(), frontNormalizationComplete() | Turn-style correction still uses this. Dead-end correction still excludes front hold.
WallThreshold | 16 | Side-wall threshold for wall presence and for the new post-correction ultrasonic-only dead-end override. | cm | Settings / Event Test Config | classifyCandidateEvent(), choosePidSource(), correctionStageUltrasonicDeadEndDetected(), postCorrectionDeadEndTriggered() | After correction, dead-end override now requires front, left, and right ultrasonics all below this threshold.
DeadEndThreshold | 20 | Legacy dead-end threshold used together with both front IR sensors while driving. | cm | Settings / Event Test Config | classifyCandidateEvent(), legacyDeadEndStopTriggered() | Still used only for the original dead-end trigger before correction begins; it no longer hijacks other events while already stopped.
Match N | 2 | Number of matching observations required to confirm correction-stage turn events. | count | IR Sensor Test / Event Test Config | updateEventConfirmState() | Still applies to left/right/T-junction confirmation. In v67 it no longer applies to dead-end takeover after correction.
Check gap | 0.01 | Delay between confirmation samples. | s | IR Sensor Test / Event Test Config | updateEventConfirmState(), updateCorridorConfirmState() | Still affects correction-stage turn confirmation timing.
1-wall P | 0.35 | One-wall PID proportional gain. | normalized | PID / Event Test Config | RuntimeSettings, RuntimeConfig, commitRuntimeConfig(), computePidWithRuntime() | Current renewed default preserved.
1-wall D | 0.04 | One-wall PID derivative gain. | normalized | PID / Event Test Config | RuntimeSettings, RuntimeConfig, commitRuntimeConfig(), computePidWithRuntime() | Current renewed default preserved.
2-wall P | 0.25 | Two-wall PID proportional gain. | normalized | PID / Event Test Config | RuntimeSettings, RuntimeConfig, commitRuntimeConfig(), computePidWithRuntime() | Renewed default preserved.
2-wall D | 0.02 | Two-wall PID derivative gain. | normalized | PID / Event Test Config | RuntimeSettings, RuntimeConfig, commitRuntimeConfig(), computePidWithRuntime() | Renewed default preserved.
IMU P | 3.9 | Yaw-hold proportional gain. | normalized | IMU PID Menu / Event Test Config | RuntimeSettings, RuntimeConfig, commitRuntimeConfig(), currentImuRotationCompensation() | Current default preserved.
IMU I | 1.7 | Yaw-hold integral gain. | normalized | IMU PID Menu / Event Test Config | RuntimeSettings, RuntimeConfig, commitRuntimeConfig(), currentImuRotationCompensation() | Current default preserved.
Front PID P | 0.15 | Front-distance proportional gain used during stopped correction. | normalized | Settings / Event Test Config | commitRuntimeConfig(), computeFrontPidCorrection() | Still used for turn-style correction.
Front PID D | 0.04 | Front-distance derivative gain used during stopped correction. | normalized | Settings / Event Test Config | commitRuntimeConfig(), computeFrontPidCorrection() | Still used for turn-style correction.
correctionConfirmEnabled | Runtime flag | Allows stopped correction to confirm and override pending turn events. | flag | Internal only | ExecutiveState / PreviewState / EventTestState, FrontNormalize flows | In v67 this flag still covers turn confirmation, but dead-end no longer passes through this correction-time confirmation path.
postCorrectionDeadEndTriggered | Internal helper | Post-correction dead-end override helper using only front, left, and right ultrasonics. | helper | Internal only | postCorrectionDeadEndTriggered(), updateExecutive(), updatePreviewExecution(), updateEventTestRun() | New in v67. Rear ultrasonic is ignored. Start and already-latched dead-end are excluded from this override path.
overallSpeedActual | 0 in FrontNormalize | Live execution speed used by the drive path. | runtime | Internal only | setOverallSpeedActual(), initializeRuntimeOverallSpeed(), updateOverallSpeedActualForState(), driveBodyFrameLimited() | Still forced to 0 during correction.
