GeorgeKonovalov/Daedalus-group---Maze-Solver---Team-Skynet/Software/TEST Codes/RP2040/test_full/v_71/test_full_v67_deadend_ultra_start_2wall_zero_ramp/test_full_v67_deadend_ultra_start_2wall_zero_ramp_menu_parameters.xlsx

Parameter | Default | Units | Type | PrimaryMenu | AlsoIn | BackingField | Description | UsedIn | Notes
Route mode | Sequence | - | cycle | Start Settings | Start Confirmation / planner displays | workingSettings.routeMode | Selects the global attempt strategy: Sequence, Right, Left, or Selection. | planNextAttempt(), currentRouteMode(), beginExecution() | Sequence mode uses stored attempt history to choose later runs.
Start heading | North | - | cycle | Start Settings | Preview/Start displays | workingSettings.startHeadingIndex | Initial logical heading used for runtime, preview, and PID test startup. | beginExecution(), startPreviewExecution(), PID test heading seed | Rotates the whole heading-relative sensor/control frame.
Overall start | 0.2 | normalized | numeric | Start Settings | Event Test Config (Start case) | workingSettings.overallStart_x100 | Initial overall speed used while Start is active or immediately after Start correction. | initializeRuntimeOverallSpeed(), updateOverallSpeedActualForState() | Works together with Overall ramp.
Overall ramp | 0.5 | x/s | numeric | Start Settings | Event Test Config (Start case) | workingSettings.overallRampK_x100 | Rate at which overallSpeedActual rises toward Overall speed. | updateOverallSpeedActualForState() | Stored in x100, so 50 means 0.50 units/s.
IMU enable | ON | - | toggle | Settings | IMU PID Menu / Event Test Config | workingSettings.imuEnabled | Global enable for all IMU-based compensation and tests. | imuUsageEnabled(), currentImuRotationCompensation(), currentImuLateralCompensation() | If OFF, yaw and lateral IMU outputs are explicitly forced to zero.
Overall speed | 0.8 | normalized | numeric | Settings | Motor Tune / Event Test Config | workingSettings.overallSpeedScale_x100 | Configured ceiling for base travel speed scaling. | driveBodyFrameLimited(), setOverallSpeedActual() | Corrections stay comparatively strong while base travel is scaled.
Left-turn ramp enable | ON | - | toggle | Settings | Event Test Config (LeftTurn/Random) | workingSettings.leftTurnRampEnabled | Enables ramped release after a left-turn stop event. | prepareOverallSpeedAfterStopEvent() | If OFF, overall speed snaps back to target after the stop.
Right-turn ramp enable | ON | - | toggle | Settings | Event Test Config (RightTurn/Random) | workingSettings.rightTurnRampEnabled | Enables ramped release after a right-turn stop event. | prepareOverallSpeedAfterStopEvent() | Same mechanism as left-turn ramp.
T-junction ramp enable | ON | - | toggle | Settings | Event Test Config (TJunction/Random) | workingSettings.tJunctionRampEnabled | Enables ramped release after a T-junction stop event. | prepareOverallSpeedAfterStopEvent() | Applies after heading choice and correction.
Dead-end ramp enable | ON | - | toggle | Settings | Event Test Config (DeadEnd/Random) | workingSettings.deadEndRampEnabled | Enables ramped release after a dead-end reverse/release event. | prepareOverallSpeedAfterStopEvent() | Dead-end uses a different handling path than turns.
Front stop | 15 | cm | numeric | Settings | Event Test Config | workingSettings.frontStopDistance_x100 | Front distance that triggers the stop/correction stage. | updateExecutive(), updatePreviewExecution(), updateEventTestRun() | One of the most important navigation thresholds.
Front hold reference | 3.5 | cm | numeric | Settings | Event Test Config | workingSettings.frontHoldReference_x100 | Desired front distance during stopped front-normalization before heading swap. | computeFrontNormalizedError(), frontNormalizationComplete() | Used for turn-style correction, not every event type.
Front PID P | 0.15 | normalized | numeric | Settings | Event Test Config | workingSettings.frontPidP_x1000 | Proportional gain of the front-distance hold controller. | computeFrontPidCorrection() | Higher values tighten the front hold but can oscillate.
Front PID I | 0 | normalized | numeric | Settings | Event Test Config | workingSettings.frontPidI_x1000 | Integral gain of the front-distance hold controller. | computeFrontPidCorrection() | Zero by default.
Front PID D | 0.04 | normalized | numeric | Settings | Event Test Config | workingSettings.frontPidD_x1000 | Derivative gain of the front-distance hold controller. | computeFrontPidCorrection() | Used to damp approach-to-wall settling.
Turn yaw tolerance | 3 | deg | numeric | Settings | Event Test Config | workingSettings.turnYawTolerance_x100 | Allowed yaw error before heading swap / stop correction is considered complete. | yawNormalizationComplete(), frontNormalizationComplete() | Works together with IMU deadband/tolerance logic.
Wall threshold | 16 | cm | numeric | Settings | Event Test Config | workingSettings.corridorWallThreshold_x100 | Threshold used to decide whether a side wall exists. | classifyCandidateEvent(), choosePidSource(), dead-end override helpers | Affects event recognition and PID source selection.
Turn detect distance | 26 | cm | numeric | Settings | Event Test Config | workingSettings.turnDetectDistance_x100 | Maximum front distance that still counts as a turn-type close-front condition. | classifyCandidateEvent() | Separates turn geometry from straight-open corridor.
Dead-end distance | 20 | cm | numeric | Settings | Event Test Config / IR Sensor Test | workingSettings.deadEndDistance_x100 | Legacy front-distance threshold for dead-end recognition while driving. | classifyCandidateEvent(), legacyDeadEndStopTriggered() | Works together with both front IR sensors in the legacy dead-end path.
Finish distance | 30 | cm | numeric | Settings | Event Test Config / IR Sensor Test | workingSettings.finishDistance_x100 | Minimum front distance required for finish recognition. | classifyCandidateEvent(), tryHandleRuntimeFinish() | Finish also depends on IR/open-side geometry.
Check gap | 0.01 | s | numeric | Settings | Event Test Config / IR Sensor Test | workingSettings.sensingInterval_x100 | Delay between repeated event-confirmation samples. | updateEventConfirmState(), updateCorridorConfirmState() | Smaller values confirm faster but reduce noise immunity.
Ultrasonic average k | 3 | samples | numeric | Settings | Displayed in sensor screens | workingSettings.ultrasonicAvgCount | Number of UART ultrasonic readings averaged into the perception frame. | commitRuntimeConfig(), buildPerceptionFrame() | Changing it resets the averaging buffers.
Match N | 2 | count | numeric | Settings | Event Test Config / IR Sensor Test | workingSettings.eventConfirmCount | How many matching detections are required to confirm an event. | updateEventConfirmState() | A key noise-vs-reactivity tuning knob.
Wall PID enable | ON | - | toggle | PID Menu | Event Test Config | workingSettings.wallPidEnabled | Global enable for wall-following correction. | wallPidUsageEnabled(), computeWallCorrection() | If OFF, wall PID output is zero even when walls are present.
1-wall symmetry | ON | - | toggle | PID Menu | Event Test Config | workingSettings.pid1WallSymmetryEnabled | Chooses whether left and right one-wall cases share one PID or use a separate right-wall PID. | computeWallCorrection(), PID menu layout | When OFF, extra 1WR fields appear.
2-wall P | 0.25 | normalized | numeric | PID Menu | Event Test Config | workingSettings.p_x1000 | Proportional gain for 2-wall centering control. | computePidWithRuntime() | This version uses a scaled 2-wall error, not a raw distance difference.
2-wall I | 0 | normalized | numeric | PID Menu | Event Test Config | workingSettings.i_x1000 | Integral gain for 2-wall control. | computePidWithRuntime() | Zero by default.
2-wall D | 0.02 | normalized | numeric | PID Menu | Event Test Config | workingSettings.d_x1000 | Derivative gain for 2-wall control. | computePidWithRuntime() | Filtered by D alpha.
Curve b | 1 | - | numeric | PID Menu | Event Test Config | workingSettings.curveB_x100 | Shapes small errors before they are fed into PID. | shapeSignedError(), shapedMagnitude() | Values above 1 soften small corrections.
1-wall target distance | 3.5 | cm | numeric | PID Menu | Event Test Config | workingSettings.pidWallDistance_x100 | Fallback target distance for one-wall following. | computeOneWallScaledError() | Can be superseded by remembered wall references during runtime.
1-wall P | 0.35 | normalized | numeric | PID Menu | Event Test Config | workingSettings.pid1WallP_x1000 | Proportional gain for symmetric 1-wall mode. | computeWallCorrection() | Applies to left and right when symmetry is ON.
1-wall I | 0 | normalized | numeric | PID Menu | Event Test Config | workingSettings.pid1WallI_x1000 | Integral gain for symmetric 1-wall mode. | computeWallCorrection() | Zero by default.
1-wall D | 0.04 | normalized | numeric | PID Menu | Event Test Config | workingSettings.pid1WallD_x1000 | Derivative gain for symmetric 1-wall mode. | computeWallCorrection() | Used for damping one-wall steering.
1-wall right P | 0.35 | normalized | numeric | PID Menu | Event Test Config | workingSettings.pid1WallRightP_x1000 | Proportional gain for right-wall-only mode when symmetry is OFF. | computeWallCorrection() | Hidden unless 1-wall symmetry is OFF.
1-wall right I | 0 | normalized | numeric | PID Menu | Event Test Config | workingSettings.pid1WallRightI_x1000 | Integral gain for right-wall-only mode when symmetry is OFF. | computeWallCorrection() | Hidden unless 1-wall symmetry is OFF.
1-wall right D | 0.04 | normalized | numeric | PID Menu | Event Test Config | workingSettings.pid1WallRightD_x1000 | Derivative gain for right-wall-only mode when symmetry is OFF. | computeWallCorrection() | Hidden unless 1-wall symmetry is OFF.
1-wall deadband | 0.6 | cm | numeric | PID Menu | Event Test Config | workingSettings.pidDeadband1W_x100 | Deadband for one-wall distance error. | computeWallCorrection() | Helps suppress noise when following a single wall.
2-wall full error | 8 | cm | numeric | PID Menu | Event Test Config | workingSettings.pidTwoWallFullError_x100 | Side-distance mismatch that maps to full 2-wall correction. | computeTwoWallScaledError() | Central to the scaled 2-wall PID design of this variant.
2-wall deadband | 0.05 | normalized | numeric | PID Menu | Event Test Config | workingSettings.pidDeadband2W_x1000 | Deadband on the scaled 2-wall error signal. | computeWallCorrection() | Stored in x1000.
D filter alpha | 0.2 | - | numeric | PID Menu | Event Test Config | workingSettings.pidDFilterAlpha_x1000 | Low-pass smoothing applied to PID derivative estimates. | computePidWithRuntime(), computeFrontPidCorrection() | Higher alpha follows raw derivative more strongly.
Left output scale | 1 | - | numeric | PID Menu | Event Test Config | workingSettings.pidLeftScale_x100 | Extra scale applied to negative correction output. | computePidWithRuntime() | Used for drivetrain asymmetry compensation.
Right output scale | 1 | - | numeric | PID Menu | Event Test Config | workingSettings.pidRightScale_x100 | Extra scale applied to positive correction output. | computePidWithRuntime() | Used for drivetrain asymmetry compensation.
IMU P | 3.9 | normalized | numeric | IMU PID Menu | Event Test Config | workingSettings.imuP_x10000 | Yaw-hold proportional gain. | applyImuCompensation() | Much larger numerically because yaw error is normalized internally.
IMU I | 1.7 | normalized | numeric | IMU PID Menu | Event Test Config | workingSettings.imuI_x10000 | Yaw-hold integral gain. | applyImuCompensation() | Provides drift rejection.
IMU D | 0 | normalized | numeric | IMU PID Menu | Event Test Config | workingSettings.imuD_x10000 | Yaw-hold derivative gain. | applyImuCompensation() | Zero in this variant.
IMU lateral P | 0.25 | normalized | numeric | IMU PID Menu | Event Test Config | workingSettings.imuLatP_x10000 | Proportional gain for no-wall lateral compensation. | currentImuLateralCompensation() | Only relevant when no side walls are present.
IMU lateral I | 0 | normalized | numeric | IMU PID Menu | Event Test Config | workingSettings.imuLatI_x10000 | Integral gain for no-wall lateral compensation. | currentImuLateralCompensation() | Zero by default.
IMU lateral D | 0.1 | normalized | numeric | IMU PID Menu | Event Test Config | workingSettings.imuLatD_x10000 | Derivative gain for no-wall lateral compensation. | currentImuLateralCompensation() | Damps sideways drift.
IMU lateral LPF alpha | 0.12 | - | numeric | IMU PID Menu | Event Test Config | workingSettings.imuLatFilterAlpha_x100 | Filter alpha for the lateral acceleration signal. | currentImuLateralCompensation() | Lower values smooth more strongly.
IMU threshold | 1 | deg | numeric | IMU PID Menu | Event Test Config | workingSettings.imuAngleThreshold_x100 | Extra yaw threshold added above sensor-derived deadband. | applyImuCompensation() | Controls when yaw-hold starts acting.
IMU yaw test error | 3 | deg | numeric | IMU PID Menu | Event Test Config | workingSettings.imuPidTestYawError_x100 | Acceptance window for the isolated IMU PID yaw test. | IMU PID test screen / logic | Used by the dedicated menu test, not by all runtime states.
IMU sign | -1 | - | toggle | IMU PID Menu | Event Test Config | workingSettings.imuSign_x100 | Flips the rotational correction direction. | commitRuntimeConfig(), applyImuCompensation() | Critical if IMU correction spins the wrong way.
Travel speed | 0.35 | normalized | numeric | Motor Tune | Displayed in run/test screens | workingSettings.baseSpeed_x100 | Nominal forward travel speed in corridor drive. | followSmart(), drawMotorTuneScreen() | Used in Corridor state.
Approach speed | 0.28 | normalized | numeric | Motor Tune | Displayed in run/test screens | workingSettings.approachSpeed_x100 | Reduced forward speed used near events and stop gates. | followSmart(), ApproachWall/Acquire states | Used during cautious approach and re-acquire.
Left drive scale | 1 | - | numeric | Motor Tune | Drive mixer | workingSettings.leftDriveScale_x100 | Calibration scale for FL/RR diagonal drive pair. | driveBodyFrameLimited() | Affects both translation and rotation on that diagonal.
Right drive scale | 1 | - | numeric | Motor Tune | Drive mixer | workingSettings.rightDriveScale_x100 | Calibration scale for FR/RL diagonal drive pair. | driveBodyFrameLimited() | Affects both translation and rotation on that diagonal.
FL stop | 90.629 | deg | numeric | Motor Tune | Servo output layer | workingSettings.servoStopFL_x1000 | Neutral center for front-left continuous-rotation servo. | servoStopAngleForWheel(), writeWheelCommand() | Used to suppress wheel creep.
FR stop | 90.9 | deg | numeric | Motor Tune | Servo output layer | workingSettings.servoStopFR_x1000 | Neutral center for front-right servo. | servoStopAngleForWheel(), writeWheelCommand() | Fine neutral tuning.
RR stop | 89.8 | deg | numeric | Motor Tune | Servo output layer | workingSettings.servoStopRR_x1000 | Neutral center for rear-right servo. | servoStopAngleForWheel(), writeWheelCommand() | Fine neutral tuning.
RL stop | 90 | deg | numeric | Motor Tune | Servo output layer | workingSettings.servoStopRL_x1000 | Neutral center for rear-left servo. | servoStopAngleForWheel(), writeWheelCommand() | Fine neutral tuning.
FL deadband | 0 | command | numeric | Motor Tune | Servo output layer | workingSettings.servoDeadbandFL_x100 | Near-zero command zone forced to front-left neutral. | servoDeadbandForWheel(), writeWheelCommand() | Stored as normalized command x100.
FR deadband | 0 | command | numeric | Motor Tune | Servo output layer | workingSettings.servoDeadbandFR_x100 | Near-zero command zone forced to front-right neutral. | servoDeadbandForWheel(), writeWheelCommand() | Prevents drift around zero.
RR deadband | 0 | command | numeric | Motor Tune | Servo output layer | workingSettings.servoDeadbandRR_x100 | Near-zero command zone forced to rear-right neutral. | servoDeadbandForWheel(), writeWheelCommand() | Prevents drift around zero.
RL deadband | 0 | command | numeric | Motor Tune | Servo output layer | workingSettings.servoDeadbandRL_x100 | Near-zero command zone forced to rear-left neutral. | servoDeadbandForWheel(), writeWheelCommand() | Prevents drift around zero.
Event-test heading | North | - | cycle | Event Test Config | Local to selected test case | currentEventTestConfig().headingIndex | Heading used by the selected event-test case. | currentEventTestHeading(), startEventTestRun() | This is not a global runtime setting.
Event-test T-junction turn choice | Left | - | cycle | Event Test Config (TJunction only) | Local to selected test case | currentEventTestConfig().turnChoice | Manual branch choice for the T-junction event test. | currentEventTestConfiguredTurn(), updateEventTestRun() | Only shown for the TJunction test case.
