GeorgeKonovalov/Daedalus-group---Maze-Solver---Team-Skynet/Software/TEST Codes/RP2040/test_full/test_full_v9/test_full_v9_notes.txt

test_full_v9

Base:
- Visual refinement branch derived from v8.

Updated INO:
- test_full_v9.ino

Main changes in this version:
- Restored the Ultrasonic Test screen to the older layout style with Front, Right, Back, Left, FB, and LR display rows.
- Kept the newer averaged ultrasonic processing and interpreted PID input from v8 under the hood.

Notes:
- v9 mainly changes the ultrasonic test presentation while preserving the newer sensor-processing path.

Files:
- test_full_v9.ino
- test_full_v9_notes.txt
