GeorgeKonovalov/Daedalus-group---Maze-Solver---Team-Skynet/Electronics/Schematic/Maze Solver Finalisation.kicad_pcb

## KiCad design Electronics/Schematic/Maze Solver Finalisation.kicad_pcb (2026-04-03)

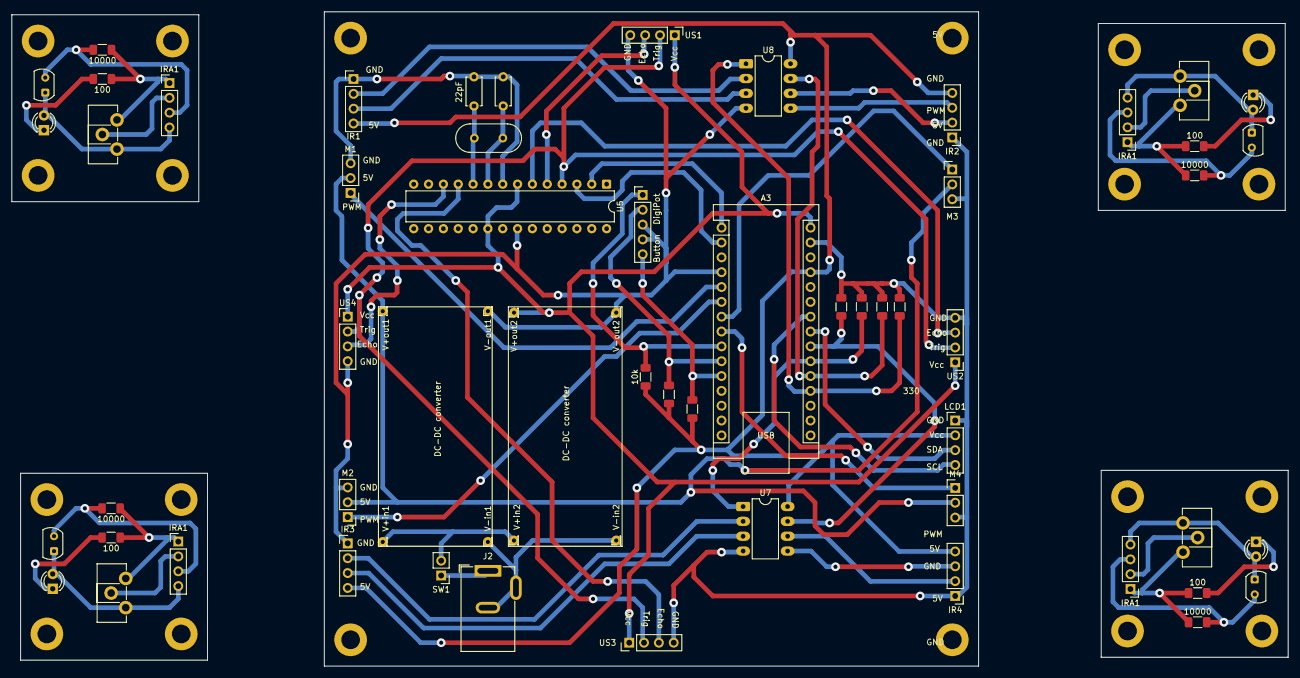
[picture p57: board Maze Solver Finalisation.kicad_pcb from above]

Board: 2 copper layers, 218.5 x 112.0 mm, 62 parts (0 on the bottom side), 42 nets.

Parts:
A3: Arduino_Nano_RP2040_Connect; Arduino_Nano
C1, C2: 22pF; C_Disc_D4.7mm_W2.5mm_P5.00mm
D1, D1#2, D1#3, D1#4: D_Photo; Osram_SFH225
D2, D2#2, D2#3, D2#4: IR204A; LED_D3.0mm_IRBlack
DigiPot: PinHeader_1x05_P2.54mm_Vertical
IR1, IR2, IR3, IR4: Conn_01x04_Pin; PinHeader_1x04_P2.54mm_Vertical
IRA1, IRA1#2, IRA1#3, IRA1#4: Conn_01x04_Pin; PinHeader_1x04_P2.54mm_Vertical
J2: Power Supply; BarrelJack_GCT_DCJ200-10-A_Horizontal
LCD1: Conn_01x04_Pin; PinHeader_1x04_P2.54mm_Vertical
M1, M2, M3, M4: Motor_Servo; PinHeader_1x03_P2.54mm_Vertical
R2, R2#2, R2#3, R2#4: 10000; R_1206_3216Metric_Pad1.30x1.75mm_HandSolder
R3, R3#2, R3#3, R3#4: 100; R_1206_3216Metric_Pad1.30x1.75mm_HandSolder
R7, R8, R9: 10k; R_1206_3216Metric_Pad1.30x1.75mm_HandSolder
R12, R13, R25, R26: 330; R_1206_3216Metric_Pad1.30x1.75mm_HandSolder
RV1, RV1#2, RV1#3, RV1#4: R_Potentiometer; Potentiometer_ACP_CA9-H2,5_Horizontal
SW1: SW_SPST; PinHeader_1x02_P2.54mm_Vertical
U5: ATmega328P-P; DIP-28_W7.62mm
U7, U8: LM358; DIP-8_W7.62mm_LongPads
US1, US2, US3, US4: Conn_01x04_Pin; PinHeader_1x04_P2.54mm_Vertical
V+in1, V+in2: Conn_01x01_Pin; PinHeader_1x01_P1.00mm_Vertical
V+out1, V+out2: Conn_01x01_Pin; PinHeader_1x01_P1.00mm_Vertical
V-in1, V-in2: Conn_01x01_Pin; PinHeader_1x01_P1.00mm_Vertical
V-out1, V-out2: Conn_01x01_Pin; PinHeader_1x01_P1.00mm_Vertical
Y1: Crystal; Crystal_HC49-4H_Vertical

Connections:
+5V: A3.30 (VIN), U5.7 (VCC), U5.20 (AVCC), US1.1, US2.1, US3.1, US4.1, V+out2.1
GND: A3.4 (GND), A3.29 (GND), C1.2, C2.1, DigiPot.3, DigiPot.4, IR1.1, IR2.1, IR3.1, IR4.1, LCD1.1, M1.3 (-), M2.3 (-), M3.3 (-), M4.3 (-), R12.2, R13.2, R25.2, R26.2, U5.8 (GND), U5.22 (GND), U7.4 (V-), U8.4 (V-), US1.4, US2.4, US3.4, US4.4, V-out1.1, V-out2.1
unnamed: A3.19 (A0), R26.1, U8.1
unnamed: A3.20 (A1), R25.1, U8.7
unnamed: A3.21 (A2), R12.1, U7.1
unnamed: A3.22 (A3), R13.1, U7.7
unnamed: A3.2 (D0/RX), U5.3 (PD1)
unnamed: A3.1 (D1/TX), U5.2 (PD0)
unnamed: A3.5 (D2), M1.1 (PWM)
unnamed: A3.6 (D3), M2.1 (PWM)
unnamed: A3.7 (D4), M3.1 (PWM)
unnamed: A3.8 (D5), M4.1 (PWM)
unnamed: A3.9 (D6), DigiPot.1, R9.1
unnamed: A3.10 (D7), DigiPot.2, R8.1
unnamed: A3.11 (D8), DigiPot.5, R7.1
unnamed: A3.24 (SCL/A5), LCD1.4
unnamed: A3.23 (SDA/A4), LCD1.3
unnamed: A3.27 (VUSB/5V), IR1.4, IR2.4, IR3.4, IR4.4, LCD1.2, R7.2, R8.2, R9.2, U7.8 (V+), U8.8 (V+)
unnamed: D1.2 (A), D1#2.2 (A), D1#3.2 (A), D1#4.2 (A), IRA1.3, IRA1#2.3, IRA1#3.3, IRA1#4.3, R2.1, R2#2.1, R2#3.1, R2#4.1
unnamed: D1.1 (K), D1#2.1 (K), D1#3.1 (K), D1#4.1 (K), D2.2 (A), D2#2.2 (A), D2#3.2 (A), D2#4.2 (A), IRA1.4, IRA1#2.4, IRA1#3.4, IRA1#4.4, RV1.1, RV1#2.1, RV1#3.1, RV1#4.1
unnamed: D2.1 (K), D2#2.1 (K), D2#3.1 (K), D2#4.1 (K), R3.1, R3#2.1, R3#3.1, R3#4.1
unnamed: IR1.2, U8.2 (-)
unnamed: IR1.3, U8.3 (+)
unnamed: IR2.2, U8.6 (-)
unnamed: IR2.3, U8.5 (+)
unnamed: IR3.2, U7.2 (-)
unnamed: IR3.3, U7.3 (+)
unnamed: IR4.2, U7.6 (-)
unnamed: IR4.3, U7.5 (+)
unnamed: IRA1.1, IRA1#2.1, IRA1#3.1, IRA1#4.1, R2.2, R2#2.2, R2#3.2, R2#4.2, R3.2, R3#2.2, R3#3.2, R3#4.2, RV1.3, RV1#2.3, RV1#3.3, RV1#4.3
unnamed: IRA1.2, IRA1#2.2, IRA1#3.2, IRA1#4.2, RV1.2, RV1#2.2, RV1#3.2, RV1#4.2
unnamed: M1.2 (+), M2.2 (+), M3.2 (+), M4.2 (+), V+out1.1
unnamed: J2.1, SW1.1 (A)
unnamed: SW1.2 (B), V+in1.1, V+in2.1
unnamed: U5.4 (PD2), US1.2, US2.2, US3.2, US4.2
unnamed: U5.5 (PD3), US1.3
unnamed: U5.6 (PD4), US2.3
unnamed: U5.11 (PD5), US3.3
unnamed: U5.12 (PD6), US4.3
unnamed: C1.1, U5.9 (XTAL1/PB6), Y1.2
unnamed: C2.2, U5.10 (XTAL2/PB7), Y1.1
unnamed: J2.2, J2.3, V-in1.1, V-in2.1
