GeorgeKonovalov/Daedalus-group---Maze-Solver---Team-Skynet/Electronics/Schematic/Maze solver.kicad_pcb

## KiCad design Electronics/Schematic/Maze solver.kicad_pcb (2025-12-08)

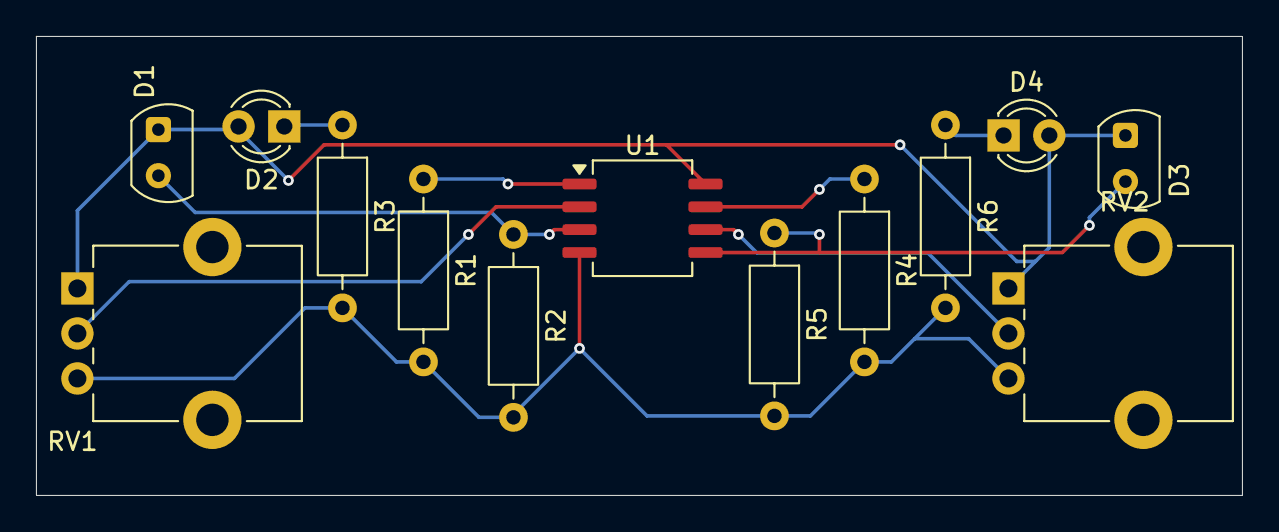
[picture p58: board Electronics/Schematic/Maze solver.kicad_pcb from above]

Board: 2 copper layers, 67.0 x 25.5 mm, 13 parts (0 on the bottom side), 10 nets.

Parts:
D1, D3: D_Photo; Osram_SFH225
D2, D4: IR204A; LED_D3.0mm_IRBlack
R1, R4: 330; R_Axial_DIN0207_L6.3mm_D2.5mm_P10.16mm_Horizontal
R2, R5: 10000; R_Axial_DIN0207_L6.3mm_D2.5mm_P10.16mm_Horizontal
R3, R6: 100; R_Axial_DIN0207_L6.3mm_D2.5mm_P10.16mm_Horizontal
RV1, RV2: R_Potentiometer; Potentiometer_Alpha_RD901F-40-00D_Single_Vertical_CircularH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
U1: LM358; SOIC-8_5.3x6.2mm_P1.27mm

Connections:
+5V: D1.1 (K), D2.2 (A), D3.1 (K), D4.2 (A), RV1.1, RV2.1, U1.8 (V+)
GND: R1.2, R2.2, R3.2, R4.2, R5.2, R6.2, RV1.3, RV2.3, U1.4 (V-)
unnamed: D1.2 (A), R2.1, U1.3 (+)
unnamed: D2.1 (K), R3.1
unnamed: D3.2 (A), R5.1, U1.5 (+)
unnamed: D4.1 (K), R6.1
unnamed: RV1.2, U1.2 (-)
unnamed: RV2.2, U1.6 (-)
Vout 1: R1.1, U1.1
Vout 2: R4.1, U1.7
