GeorgeKonovalov/Daedalus-group---Maze-Solver---Team-Skynet/Electronics/PCB/Maze solver.kicad_pcb

## KiCad design Electronics/PCB/Maze solver.kicad_pcb (2026-02-12)

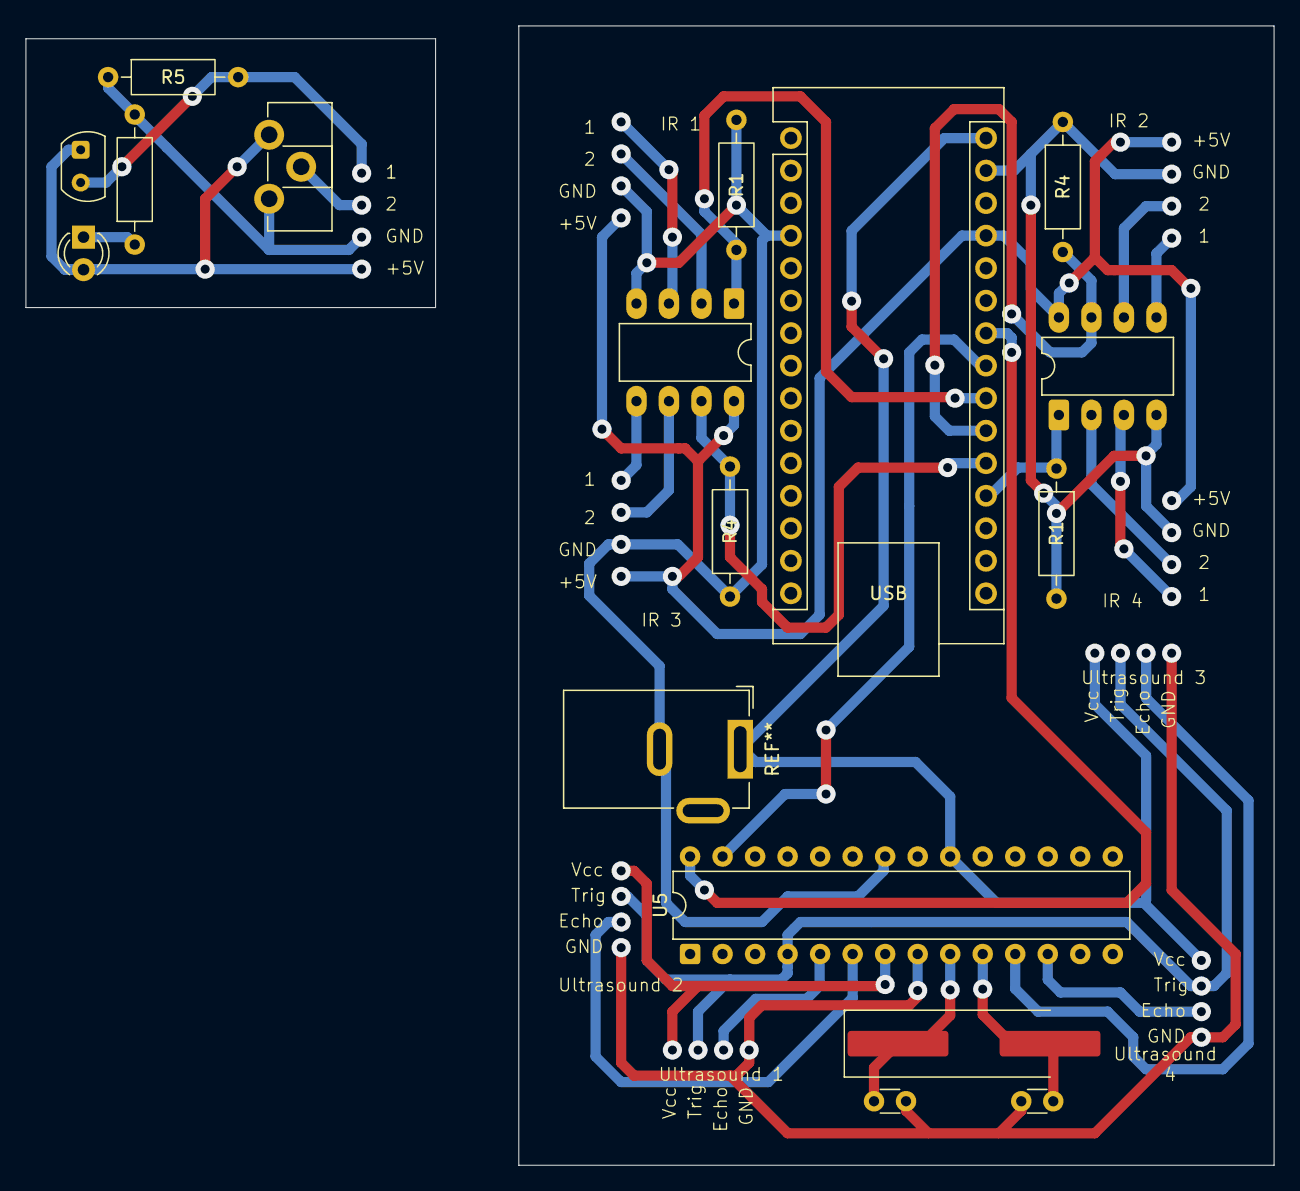
[picture p59: board Electronics/PCB/Maze solver.kicad_pcb from above]

Board: 2 copper layers, 97.5 x 89.0 mm, 12 parts (0 on the bottom side), 8 nets.

Parts:
A1: Arduino_Nano_RP2040_Connect; Arduino_Nano
D3: D_Photo; Osram_SFH225
D4: IR204A; LED_D3.0mm_IRBlack
R1, R1#2, R4, R4#2: 330; R_Axial_DIN0207_L6.3mm_D2.5mm_P10.16mm_Horizontal
R5: 10000; R_Axial_DIN0207_L6.3mm_D2.5mm_P10.16mm_Horizontal
R6: 100; R_Axial_DIN0207_L6.3mm_D2.5mm_P10.16mm_Horizontal
U1, U1#2: LM358; DIP-8_W7.62mm_LongPads
U5: ATmega328P-P; DIP-28_W7.62mm

Connections:
GND: R1.2, R4.2, U1.4 (V-)
IR 1: A1.22 (A3), R1#2.1, U1#2.1
IR 2: A1.20 (A1), R4.1, R4#2.1, U1.7, U1#2.7
IR 4: A1.21 (A2), R1.1, U1.1
Ultrasound 1 GND: A1.4 (GND), A1.29 (GND), R1#2.2, R4#2.2, U1#2.4 (V-), U5.8 (GND), U5.22 (GND)
Ultrasound 1 Vcc: A1.27 (VUSB/5V), U1#2.8 (V+), U5.7 (VCC), U5.20 (AVCC)
i2C Clock: A1.24 (SCL/A5), U5.28 (PC5)
i2C Data: A1.23 (SDA/A4), U5.27 (PC4)
