GeorgeKonovalov/Daedalus-group---Maze-Solver---Team-Skynet/Software/TEST Codes/RP2040/test_full/v_71/test_full_v67_deadend_ultra_start_2wall_zero_ramp/test_full_v67_deadend_ultra_start_2wall_zero_ramp.ino

#include <Arduino.h>
#include <Wire.h>
#include <U8g2lib.h>
#include <Servo.h>
#include <Arduino_LSM6DSOX.h>
#include <math.h>
#include <stdio.h>
#include <string.h>

// ======================================================
// Hardware
// ======================================================
constexpr uint8_t ENC_A_PIN   = 7;
constexpr uint8_t ENC_B_PIN   = 6;
constexpr uint8_t ENC_BTN_PIN = 8;

constexpr uint8_t PIN_FL = 5;
constexpr uint8_t PIN_FR = 3;
constexpr uint8_t PIN_RR = 9;
constexpr uint8_t PIN_RL = 4;

constexpr uint8_t PIN_IR_FL = 16;
constexpr uint8_t PIN_IR_FR = 17;
constexpr uint8_t PIN_IR_RL = 14;
constexpr uint8_t PIN_IR_RR = 15;

constexpr int STOP_FL = 90;
constexpr int STOP_FR = 90;
constexpr int STOP_RR = 90;
constexpr int STOP_RL = 90;

constexpr int RANGE_FL = 90;
constexpr int RANGE_FR = 90;
constexpr int RANGE_RR = 90;
constexpr int RANGE_RL = 90;

constexpr int INV_FL =  1;
constexpr int INV_FR = -1;
constexpr int INV_RR = -1;
constexpr int INV_RL =  1;

constexpr uint8_t OLED_ADDR = 0x3C; //i2c address of the oled display
U8G2_SSD1306_128X64_NONAME_F_HW_I2C u8g2(U8G2_R0, U8X8_PIN_NONE); // OLED structure

// ======================================================
// Timing and limits
// ======================================================
constexpr uint32_t BUTTON_DEBOUNCE_MS = 15;
constexpr uint32_t BUTTON_LONGPRESS_MS = 700;
constexpr uint32_t ULTRASONIC_STALE_MS = 200;
constexpr uint8_t ULTRASONIC_AVG_COUNT_MAX = 5;
constexpr uint8_t EVENT_CONFIRM_SAMPLES = 3;
constexpr uint8_t CORRIDOR_CONFIRM_SAMPLES = 3;
constexpr uint32_t UI_REFRESH_INTERVAL_MS = 40;
constexpr int32_t ENCODER_EDGES_PER_MENU_STEP = 2;
constexpr float SENSOR_MAX_VALID_CM = 60.0f;
constexpr float PID_INTERPRET_LIMIT_CM = 0.6f;
constexpr float PID_INTEGRAL_LIMIT = 40.0f;
constexpr float PID_SOURCE_HYSTERESIS_CM = 0.75f;
constexpr float IMU_PID_INTEGRAL_LIMIT = 120.0f;
constexpr uint16_t IMU_REFERENCE_SAMPLES = 64;
constexpr uint16_t IMU_REFERENCE_SAMPLE_DELAY_MS = 5;
constexpr float IMU_GYRO_ZERO_RATE_LEVEL_DPS = 1.0f;   // LSM6DSOX G_TyOff
constexpr float IMU_GYRO_RMS_NOISE_DPS = 0.075f;       // LSM6DSOX RnRMS
constexpr float IMU_GYRO_SENS_TOL = 0.01f;             // LSM6DSOX G_So%
constexpr float IMU_ACCEL_ZERO_G_OFFSET_G = 0.020f;    // LSM6DSOX LA_TyOff
constexpr float IMU_ACCEL_RMS_NOISE_G = 0.0018f;       // LSM6DSOX RMS @ +/-2 g
constexpr float IMU_REFERENCE_MIN_Z_G = 0.25f;
constexpr float IMU_CAPTURE_MAX_GYRO_DPS = 2.5f;       // Reject reference capture while the robot is still rotating.
constexpr float IMU_CAPTURE_MAX_NORM_ERR_G = 0.15f;    // Reject reference capture if the board is being shaken.
constexpr float IMU_GYRO_SOFT_ZONE_DPS = 0.35f;        // Low-rate smoothing zone to avoid stick-slip yaw integration.
constexpr float IMU_ERROR_FULL_SCALE_DEG = 45.0f;      // IMU PID works on normalized yaw error instead of raw degrees.
constexpr float IMU_OUTPUT_SLEW_PER_S = 3.0f;          // Limit yaw-hold output steps so the chassis does not snap.
constexpr float IMU_REANCHOR_HOLD_S = 0.35f;           // Briefly pause compensation after a fresh reference capture.
constexpr uint32_t IMU_SAMPLE_TIMEOUT_MS = 80;
constexpr uint8_t IMU_SAMPLE_POLL_DELAY_MS = 1;
constexpr float IMU_BODY_AXIS_C45 = 0.70710678f;       // IMU board is mounted at 45 deg to the robot body axes.

// ======================================================
// Settings storage (fixed-point menu values)
// ======================================================
struct RuntimeSettings {
  uint8_t wallPidEnabled = 1;
  uint8_t pid1WallSymmetryEnabled = 1;
  int pidDeadband1W_x100 = 60;
  int p_x1000 = 250;
  int i_x1000 = 00;     //   
  int d_x1000 = 20;     //   
  int pid1WallP_x1000 = 450;
  int pid1WallI_x1000 = 0;
  int pid1WallD_x1000 = 40;
  int pid1WallRightP_x1000 = 450;
  int pid1WallRightI_x1000 = 0;
  int pid1WallRightD_x1000 = 40;
  // Global IMU usage switch. 1 = allowed everywhere, 0 = disabled everywhere.
  uint8_t imuEnabled = 1;
  int imuSign_x100 = -100;
  int imuP_x10000 = 39000;
  int imuI_x10000 = 17000;
  int imuD_x10000 = 0;
  int imuLatP_x10000 = 2500;
  int imuLatI_x10000 = 0;
  int imuLatD_x10000 = 1000;
  int imuLatFilterAlpha_x100 = 12;
  int imuAngleThreshold_x100 = 100;
  int imuPidTestYawError_x100 = 300;
  int curveB_x100 = 100;
  int pidTwoWallFullError_x100 = 800;
  int pidDeadband2W_x1000 = 37;
  int pidDFilterAlpha_x1000 = 200;
  int pidWallDistance_x100 = 350;
  int pidLeftScale_x100 = 100;
  int pidRightScale_x100 = 100;
  int overallSpeedScale_x100 = 80;
  int overallStart_x100 = 30;
  int overallRampK_x100 = 30;
  uint8_t leftTurnRampEnabled = 1;
  uint8_t rightTurnRampEnabled = 1;
  uint8_t tJunctionRampEnabled = 1;
  uint8_t deadEndRampEnabled = 1;
  int baseSpeed_x100 = 35;
  int approachSpeed_x100 = 28;
  int leftDriveScale_x100 = 100;
  int rightDriveScale_x100 = 100;
  int servoStopFL_x1000 = 90045;
  int servoStopFR_x1000 = 89530;
  int servoStopRR_x1000 = 89800;
  int servoStopRL_x1000 = 90000;
  int servoDeadbandFL_x100 = 0;
  int servoDeadbandFR_x100 = 0;
  int servoDeadbandRR_x100 = 0;
  int servoDeadbandRL_x100 = 0;

  int frontStopDistance_x100 = 1500;
  int frontHoldReference_x100 = 350;
  int frontPidP_x1000 = 100;
  int frontPidI_x1000 = 0;
  int frontPidD_x1000 = 40;
  int turnYawTolerance_x100 = 300;
  int corridorWallThreshold_x100 = 1600;
  int turnDetectDistance_x100 = 2600;
  int deadEndDistance_x100 = 2000;
  int finishDistance_x100 = 3000;
  int sensingInterval_x100 = 1;
  int eventConfirmCount = 1;
  int ultrasonicAvgCount = 2;
  int waitBeforeTurn_x100 = 500;

  uint8_t routeMode = 1;
  uint8_t startHeadingIndex = 0;
};

struct RuntimeConfig {
  bool wallPidEnabled = true;
  bool pid1WallSymmetric = true;
  float pidDeadband1WCm = 0.6f;
  float p = 0.25f;
  float i = 0.0f;
  float d = 0.02f;
  float pid1WallP = 0.35f;
  float pid1WallI = 0.0f;
  float pid1WallD = 0.04f;
  float pid1WallRightP = 0.35f;
  float pid1WallRightI = 0.0f;
  float pid1WallRightD = 0.04f;
  bool imuEnabled = false;
  float imuSign = 1.0f;
  float imuP = 3.9f;
  float imuI = 1.7f;
  float imuD = 0.0f;
  float imuLatP = 0.18f;
  float imuLatI = 0.0f;
  float imuLatD = 0.03f;
  float imuLatFilterAlpha = 0.12f;
  float imuAngleThresholdDeg = 1.0f;
  float imuPidTestYawErrorDeg = 3.0f;
  float curveB = 1.0f;
  float pidTwoWallFullErrorCm = 8.0f;
  float pidDeadband2W = 0.05f;
  float pidDFilterAlpha = 0.2f;
  float pidWallDistanceCm = 6.0f;
  float pidLeftScale = 1.0f;
  float pidRightScale = 1.0f;
  float overallSpeedScale = 1.0f;
  float overallStart = 0.20f;
  float overallRampK = 2.0f;
  bool leftTurnRampEnabled = true;
  bool rightTurnRampEnabled = true;
  bool tJunctionRampEnabled = true;
  bool deadEndRampEnabled = true;
  float baseSpeed = 0.35f;
  float approachSpeed = 0.28f;
  float leftDriveScale = 1.0f;
  float rightDriveScale = 1.0f;
  float servoStopFL = 90.050f;
  float servoStopFR = 89.800f;
  float servoStopRR = 89.800f;
  float servoStopRL = 90.000f;
  float servoDeadbandFL = 0.0f;
  float servoDeadbandFR = 0.0f;
  float servoDeadbandRR = 0.0f;
  float servoDeadbandRL = 0.0f;

  float frontStopDistanceCm = 15.0f;
  float frontHoldReferenceCm = 3.5f;
  float frontPidP = 0.15f;
  float frontPidI = 0.0f;
  float frontPidD = 0.04f;
  float turnYawToleranceDeg = 3.0f;
  float corridorWallThresholdCm = 6.0f;
  float turnDetectDistanceCm = 26.0f;
  float deadEndDistanceCm = 16.0f;
  float finishDistanceCm = 30.0f;
  float sensingIntervalS = 0.10f;
  uint8_t eventConfirmCount = 3;
  uint8_t ultrasonicAvgCount = 5;
  float waitBeforeTurnS = 5.0f;
};

RuntimeSettings activeSettings;
RuntimeSettings workingSettings;
RuntimeConfig gCfg;

// ======================================================
// High-level architecture types
// ======================================================
enum class Heading : uint8_t {
  North,
  East,
  South,
  West
};

enum class RouteMode : uint8_t {
  Sequence = 1,
  Right = 2,
  Left = 3,
  Selection = 4
};

enum class EventType : uint8_t {
  Idle,
  Start,
  Corridor,
  LeftTurn,
  RightTurn,
  TJunction,
  TJunctionStraight,
  DeadEnd,
  Finish,
  SensorWait,
  SafetyStop
};

enum class NavState : uint8_t {
  Idle,
  StartSeek,
  Corridor,
  ApproachWall,
  FrontNormalize,
  AcquireCorridor,
  SafetyStop,
  Finished
};

enum class PidSource : uint8_t {
  None,
  LeftWall,
  RightWall,
  TwoWall
};

enum class Screen : uint8_t {
  Root,
  StartSettings,
  Settings,
  PID,
  IMUPIDMenu,
  PIDTest,
  IMUPIDTest,
  MotorTune,
  EventTestMenu,
  EventTestConfig,
  EventTestRun,
  IMUTest,
  IMUYawTest,
  MazeTestRun,
  IRSensorTest,
  UltrasonicSensorTest,
  MotionSettings,
  DetectionSettings,
  SensorMonitor,
  TwinMonitor,
  DigitEditor,
  StartConfirm,
  RunScreen
};

enum class PidTestMode : uint8_t {
  TwoWall,
  OneWallLeft,
  OneWallRight,
  NoWall
};

enum class ButtonEvent : uint8_t {
  None,
  ShortPress,
  LongPress
};

struct ButtonState {
  bool stableLevel = HIGH;
  bool lastRawLevel = HIGH;
  uint32_t lastDebounceMs = 0;
  uint32_t pressedAtMs = 0;
  bool longPressReported = false;
};

struct RelativeIrState {
  bool frontLeft = false;
  bool frontRight = false;
  bool rearLeft = false;
  bool rearRight = false;
};

struct PerceptionFrame {
  bool ultrasonicValid = false;
  uint32_t ultrasonicSampleId = 0;
  uint8_t stableIrMask = 0;
  RelativeIrState ir;
  float north = 0.0f;
  float east = 0.0f;
  float south = 0.0f;
  float west = 0.0f;
  float northRaw = 0.0f;
  float eastRaw = 0.0f;
  float southRaw = 0.0f;
  float westRaw = 0.0f;
  float front = 0.0f;
  float left = 0.0f;
  float right = 0.0f;
  float back = 0.0f;
  float frontRaw = 0.0f;
  float leftRaw = 0.0f;
  float rightRaw = 0.0f;
  float backRaw = 0.0f;
  EventType candidate = EventType::SensorWait;
  bool corridorSignature = false;
  PidSource pidSource = PidSource::None;
};

struct EventConfirmState {
  bool active = false;
  EventType candidate = EventType::Idle;
  uint8_t matches = 0;
  uint32_t nextCheckMs = 0;
  uint32_t lastSampleId = 0;
};

struct CorridorConfirmState {
  bool active = false;
  uint8_t matches = 0;
  uint32_t nextCheckMs = 0;
  uint32_t lastSampleId = 0;
};

enum class TurnChoice : uint8_t {
  Left,
  Right
};

enum class EventTestCase : uint8_t {
  Corridor,
  TJunction,
  DeadEnd,
  Start,
  Finish,
  LeftTurn,
  RightTurn,
  TJunctionStraight,
  Random,
  Back
};

enum class EventConfigField : uint8_t {
  Heading,
  TurnChoice,
  OverallSpeed,
  OverallStart,
  OverallRampK,
  LeftTurnRamp,
  RightTurnRamp,
  TJunctionRamp,
  DeadEndRamp,
  FrontStop,
  FrontHoldRef,
  FrontPidP,
  FrontPidI,
  FrontPidD,
  TurnYawTol,
  WallThreshold,
  TurnDetect,
  DeadEnd,
  Finish,
  TurnWait,
  CheckGap,
  MatchCount,
  WallToggle,
  OneWallSymmetry,
  WallP,
  WallI,
  WallD,
  CurveB,
  OneWallTarget,
  OneWallP,
  OneWallI,
  OneWallD,
  OneWallRightP,
  OneWallRightI,
  OneWallRightD,
  OneWallDeadband,
  TwoWallFullScale,
  TwoWallDeadband,
  DFilterAlpha,
  LeftOutput,
  RightOutput,
  ImuToggle,
  ImuP,
  ImuI,
  ImuD,
  ImuLatP,
  ImuLatI,
  ImuLatD,
  ImuLatFilterAlpha,
  ImuThreshold,
  ImuTestYawError,
  ImuSign,
  Run,
  Back
};

constexpr int EVENT_CONFIG_FIELD_COUNT = (int)EventConfigField::Back + 1;
constexpr size_t EVENT_CONFIG_TEXT_SIZE = 32;

struct EventTestConfig {
  uint8_t headingIndex = 0;
  TurnChoice turnChoice = TurnChoice::Left;
};

struct PidRuntime {
  float previousError = 0.0f;
  float integral = 0.0f;
  float derivativeFiltered = 0.0f;
  uint32_t previousMs = 0;
};

struct WallReferenceState {
  // These remembered side-wall distances make the 1-wall PID inherit the
  // last real corridor geometry instead of snapping back to a fixed menu target.
  bool leftValid = false;
  bool rightValid = false;
  float leftCm = 0.0f;
  float rightCm = 0.0f;
};

struct ImuLateralRuntime {
  float filteredLateralBodyG = 0.0f;
  float previousError = 0.0f;
  float integral = 0.0f;
  uint32_t previousMs = 0;
};

struct ImuReference {
  bool valid = false;
  float yawDeg = 0.0f;
  float xAxisX = 1.0f;
  float xAxisY = 0.0f;
  float yAxisX = 0.0f;
  float yAxisY = 1.0f;
  float avgAx = 0.0f;
  float avgAy = 0.0f;
  float avgAz = 1.0f;
  float planarTolG = 0.0f;
  float angleTolDeg = 0.0f;
  uint32_t capturedMs = 0;
};

struct ImuState {
  bool available = false;
  bool referenceValid = false;
  float ax = 0.0f;
  float ay = 0.0f;
  float az = 0.0f;
  float gx = 0.0f;
  float gy = 0.0f;
  float gz = 0.0f;
  float gyroBiasZDps = 0.0f;
  float yawDeg = 0.0f;
  float yawRateDps = 0.0f;
  float sampleDtS = 0.01f;
  float currentXAxisX = 1.0f;
  float currentXAxisY = 0.0f;
  float yawErrorDeg = 0.0f;
  float measurementAngleTolDeg = 0.0f;
  float combinedDeadbandDeg = 0.0f;
  float lastCompensationCmd = 0.0f;
  uint32_t lastSampleMs = 0;
  uint32_t compensationHoldUntilMs = 0;
  ImuReference reference;
};

using ImuPidRuntime = PidRuntime;

struct AttemptRecord {
  bool valid = false;
  bool hadDeadEnd = false;
  uint32_t durationMs = 0;
  RouteMode chosenMode = RouteMode::Selection;
};

struct PlannerState {
  uint32_t attemptCounter = 0;
  uint32_t lastAttemptDurationMs = 0;
  uint32_t totalDurationMs = 0;
  uint8_t sequenceSlot = 0;
  bool sequenceCycleComplete = false;
  RouteMode currentAttemptRecordMode = RouteMode::Right;
  RouteMode currentAttemptExecutionMode = RouteMode::Right;
  bool currentAttemptHadDeadEnd = false;
  AttemptRecord rightAttempt;
  AttemptRecord leftAttempt;
  AttemptRecord selectionAttempt;
};

struct ExecutiveState {
  bool running = false;
  NavState state = NavState::Idle;
  Heading heading = Heading::North;
  Heading pendingHeading = Heading::North;
  // True only when the post-stop compensation phase is allowed to re-confirm
  // and override the pending event. Legacy dead-end stops keep this false so
  // they only align and then reverse direction.
  bool correctionConfirmEnabled = true;
  bool postCorrectionReleaseActive = false;
  bool finishArmed = false;
  bool tJunctionRaised = false;
  bool deadEndRaised = false;
  EventType displayEvent = EventType::Idle;
  EventType latchedEvent = EventType::Idle;
  uint32_t runStartedMs = 0;
  uint32_t phaseStartedMs = 0;
  EventConfirmState eventConfirm;
  CorridorConfirmState corridorConfirm;
};

struct EventTestState {
  bool active = false;
  NavState state = NavState::Idle;
  Heading heading = Heading::North;
  Heading pendingHeading = Heading::North;
  bool correctionConfirmEnabled = true;
  bool postCorrectionReleaseActive = false;
  bool finishArmed = false;
  bool tJunctionRaised = false;
  bool deadEndRaised = false;
  EventType displayEvent = EventType::Idle;
  EventType latchedEvent = EventType::Idle;
  EventConfirmState eventConfirm;
  CorridorConfirmState corridorConfirm;
  uint32_t startedMs = 0;
  uint32_t phaseStartedMs = 0;
};

struct PreviewState {
  bool active = false;
  NavState state = NavState::Idle;
  Heading heading = Heading::North;
  Heading pendingHeading = Heading::North;
  bool correctionConfirmEnabled = true;
  bool postCorrectionReleaseActive = false;
  bool finishArmed = false;
  bool tJunctionRaised = false;
  bool deadEndRaised = false;
  EventType displayEvent = EventType::Idle;
  EventType latchedEvent = EventType::Idle;
  uint32_t startedMs = 0;
  uint32_t phaseStartedMs = 0;
  EventConfirmState eventConfirm;
  CorridorConfirmState corridorConfirm;
};

struct FinishInterruptState {
  bool pending = false;
  uint32_t stopMs = 0;
};

enum class TuneMotion : uint8_t {
  Stop,
  North,
  East,
  South,
  West
};

enum class WheelId : uint8_t {
  FL,
  FR,
  RR,
  RL
};

struct DigitEditor {
  bool active = false;
  bool digitUnlocked = false;
  uint8_t selectedDigit = 0;
  uint8_t integerDigits = 2;
  uint8_t decimals = 2;
  uint8_t digitCount = 4;
  int tempValue = 0;
  int* targetValue = nullptr;
  int minValue = 0;
  int maxValue = 9999;
  const char* label = "";
  const char* unit = "";
  const char* description1 = "";
  const char* description2 = "";
  Screen returnScreen = Screen::Root;
};

// ======================================================
// Global runtime state
// ======================================================
Servo servoFL;
Servo servoFR;
Servo servoRR;
Servo servoRL;

volatile int32_t gEncoderRawDelta = 0;

ButtonState gButton;
DigitEditor gDigitEditor;
PlannerState gPlanner;
ExecutiveState gExecutive;
EventTestState gEventTestRun;
PreviewState gPreviewRun;
FinishInterruptState gFinishInterrupt;
PidRuntime gPid;
PidRuntime gPid1WallSym;
PidRuntime gPid1WallLeft;
PidRuntime gPid1WallRight;
PidRuntime gFrontPid;
WallReferenceState gWallRef;
ImuPidRuntime gImuPid;
ImuLateralRuntime gImuLatPid;
ImuState gImu;
PidSource gActivePidSource = PidSource::None;
bool gImuPidTestArmed = false;
float gOverallSpeedActual = 1.0f;
uint32_t gOverallSpeedUpdateMs = 0;

Screen gCurrentScreen = Screen::Root;
Screen gPreviousScreen = Screen::Root;

int gRootIndex = 0;
int gStartSettingsIndex = 0;
int gSettingsIndex = 0;
int gPidIndex = 0;
int gImuPidMenuIndex = 0;
int gMotorTuneIndex = 0;
int gMotionSettingsIndex = 0;
int gDetectionSettingsIndex = 0;
int gEventTestIndex = 0;
int gEventTestConfigIndex = 0;
int gIrSensorIndex = 0;
int32_t gEncoderStepCarry = 0;

Heading gPreviewHeading = Heading::North;

EventTestCase gSelectedEventTest = EventTestCase::Corridor;
EventTestConfig gEventTestConfigs[10];
Heading gPidTestHeading = Heading::North;
PidTestMode gPidTestMode = PidTestMode::TwoWall;
TuneMotion gTuneMotion = TuneMotion::Stop;

int gIrFL = LOW;
int gIrFR = LOW;
int gIrRL = LOW;
int gIrRR = LOW;
uint8_t gRawIrMask = 0;
uint8_t gStableIrMask = 0;

float gDistN = 0.0f;
float gDistE = 0.0f;
float gDistS = 0.0f;
float gDistW = 0.0f;
float gAvgN = 0.0f;
float gAvgE = 0.0f;
float gAvgS = 0.0f;
float gAvgW = 0.0f;
float gBufN[ULTRASONIC_AVG_COUNT_MAX] = {0};
float gBufE[ULTRASONIC_AVG_COUNT_MAX] = {0};
float gBufS[ULTRASONIC_AVG_COUNT_MAX] = {0};
float gBufW[ULTRASONIC_AVG_COUNT_MAX] = {0};
uint8_t gBufIndex = 0;
uint8_t gBufCount = 0;
uint32_t gLastUltrasonicMs = 0;
uint32_t gUltrasonicSampleId = 0;
bool gUltrasonicValid = false;

char gUartLine[96];
uint8_t gUartPos = 0;
uint32_t gLastUiDrawMs = 0;
Screen gLastDrawnScreen = Screen::RunScreen;

// ======================================================
// Forward declarations
// ======================================================
void onEncoderEdge();

void commitRuntimeConfig();
void resetPid();
void resetDrivePidControl();
void resetImuPid();
void resetImuLateralPid();
void resetFrontPid();
bool imuHardwareReady();
bool imuUsageEnabled();
void clearImuReference();
void holdImuCompensation(float seconds);
bool imuCaptureSampleLooksStill(float ax, float ay, float az, float gx, float gy, float gz);

float fixedToFloat2(int value);
float fixedToFloat3(int value);
float fixedToFloat4(int value);
int clampInt(int value, int minValue, int maxValue);
float clampFloat(float value, float minValue, float maxValue);
float clampUnit(float value);
uint32_t secondsToMs(float seconds);
uint8_t wrap4(int value);
uint8_t buildIrMaskFromPins();
bool isIrTriggered(int value);
bool ultrasonicFresh();
bool parseDistancesLine(const char* line, float& d1, float& d2, float& d3, float& d4);
void pushUltrasonicAverages(float north, float east, float south, float west);
void readIRSensors();
void initImu();
void updateImu();
bool captureImuReference();
void updateImuDerivedState();
float imuReferenceAngleToleranceDeg(float captureDurationS);
float imuPlanarAngleToleranceDeg(uint16_t sampleCount, float avgAz);
float imuMeasurementAngleToleranceDeg(float angleErrorDeg, float dt);
float imuGyroRateFloorDps();
float signedAngleBetweenDeg(float ax, float ay, float bx, float by);
void yawAxisForAngle(float yawDeg, float& xOut, float& yOut);
float applyImuCompensation(ImuPidRuntime& runtime);
float currentImuLateralCompensation(float forwardSpeed);
float currentImuRotationCompensation(ImuPidRuntime& runtime);
void refreshSensors();

Heading headingFromIndex(uint8_t index);
uint8_t headingToIndex(Heading heading);
Heading turnLeftOf(Heading heading);
Heading turnRightOf(Heading heading);
Heading oppositeOf(Heading heading);
float distanceForHeading(Heading heading);

RelativeIrState relativeIrForHeading(uint8_t mask, Heading heading);
PerceptionFrame buildPerceptionFrame(Heading heading);
PerceptionFrame buildPerceptionFrame(Heading heading, bool finishArmed);
PerceptionFrame buildPerceptionFrame(Heading heading, bool finishArmed, bool tJunctionStraightArmed);
EventType classifyCandidateEvent(const PerceptionFrame& frame, bool finishArmed);
EventType classifyCandidateEvent(const PerceptionFrame& frame, bool finishArmed, bool tJunctionStraightArmed);
bool corridorSignatureForFrame(const PerceptionFrame& frame);
bool startSignatureForFrame(const PerceptionFrame& frame);
PidSource choosePidSource(const PerceptionFrame& frame);

RouteMode currentRouteMode();
RouteMode effectiveRouteMode();
Heading chooseHeadingForEvent(const PerceptionFrame& frame, EventType eventType, Heading currentHeading);
static bool planNextAttempt(RouteMode& executionMode, RouteMode& recordMode, const char*& errorText);
static const char* routeModeShortString(RouteMode mode);

bool updateEventConfirmation(const PerceptionFrame& frame, EventType& confirmedEvent);
bool updateCorridorConfirmation(const PerceptionFrame& frame);
void resetEventConfirmation();
void resetCorridorConfirmation();
static bool updateEventConfirmState(EventConfirmState& state, EventType candidate, EventType& confirmedEvent);
static bool applyCompensationEventOverride(const PerceptionFrame& frame,
                                           EventType confirmedEvent,
                                           Heading currentHeading,
                                           EventType& latchedEvent,
                                           Heading& pendingHeading,
                                           bool& finishArmed,
                                           bool& tJunctionRaised,
                                           bool& deadEndRaised,
                                           bool preferConfiguredTJunction,
                                           TurnChoice configuredTurn,
                                           bool& leaveNormalize,
                                           bool& finishNow);
static bool legacyDeadEndStopTriggered(const PerceptionFrame& frame);
static bool correctionStageUltrasonicDeadEndDetected(const PerceptionFrame& frame);
static bool postCorrectionDeadEndTriggered(const PerceptionFrame& frame, EventType currentEvent);
static EventType correctionStageCandidate(const PerceptionFrame& frame, bool allowDeadEndConfirm);
static EventType postCorrectionTurnCandidate(const PerceptionFrame& frame);

bool wallPidUsageEnabled();
float shapedMagnitude(float magnitude, float interpretLimit);
float shapeSignedError(float error, float interpretLimit);
float shapeSignedError(float error);
void resetPidRuntime(PidRuntime& runtime);
float computePid(float error, PidSource source);
float computePidWithRuntime(PidRuntime& runtime, float error, PidSource source,
                            float pGain, float iGain, float dGain);
float computeWallError(const PerceptionFrame& frame, PidSource source);
float computeWallCorrection(const PerceptionFrame& frame, PidSource source);
void resetWallReference();
void updateWallReference(const PerceptionFrame& frame);
PidSource stabilizedPidSource(const PerceptionFrame& frame, PidSource previousSource);
float servoStopAngleForWheel(WheelId wheel);
float servoDeadbandForWheel(WheelId wheel);
int servoRangeForWheel(WheelId wheel);
int servoInvertForWheel(WheelId wheel);
void writeServoCommand(Servo& servo, float stopAngle, int rangeAngle, int invert, float cmd);
void writeWheelCommand(WheelId wheel, Servo& servo, float cmd);
void stopAll();
void driveRobotFrame(float lateralCmd, float forwardCmd, float rotationCmd, Heading heading);
void driveRobotFrameAdvanced(float lateralCmd, float baseForwardCmd, float forwardCompCmd, float rotationCmd, Heading heading);
void followSmart(Heading heading, float forwardSpeed);
void followSmartForced(Heading heading, float forwardSpeed, PidSource forcedSource);
static void setOverallSpeedActual(float speed);
static void syncOverallSpeedActualToTarget();
static void initializeRuntimeOverallSpeed(bool startLimited);
static void updateOverallSpeedActualForState(NavState state);
static bool holdPostCorrectionRelease(bool& releaseActive, const PerceptionFrame& frame);
static bool frontNormalizationComplete(const PerceptionFrame& frame, EventType eventType);
static void runFrontNormalization(Heading heading, const PerceptionFrame& frame, EventType eventType);

void beginExecution();
void finishExecution();
void updateExecutive();
static void requestFinishInterrupt();
static bool serviceFinishInterrupt();
static void finishExecutionAt(uint32_t stopMs);
static bool eventTestStartsWithFinishArmed(EventTestCase testCase);
static bool eventTestStartsWithTJunctionStraightArmed(EventTestCase testCase);

ButtonEvent readButtonEvent(bool allowInput);
void openDigitEditor(const char* label, const char* unit, int* target, int minValue, int maxValue,
                     const char* desc1, const char* desc2, Screen returnScreen,
                     uint8_t integerDigits = 2, uint8_t decimals = 2);
void closeDigitEditor(bool commitValue);
void handleDigitEditorInput(int encoderDelta, ButtonEvent buttonEvent);
void handleIdleUiInput(int encoderDelta, ButtonEvent buttonEvent);
void handleRootInput(int encoderDelta, ButtonEvent buttonEvent);
void handleStartSettingsInput(int encoderDelta, ButtonEvent buttonEvent);
void handleSettingsInput(int encoderDelta, ButtonEvent buttonEvent);
void handlePidInput(int encoderDelta, ButtonEvent buttonEvent);
void handleImuPidMenuInput(int encoderDelta, ButtonEvent buttonEvent);
void handlePidTestInput(int encoderDelta, ButtonEvent buttonEvent);
void handleImuPidTestInput(ButtonEvent buttonEvent);
void handleMotorTuneInput(int encoderDelta, ButtonEvent buttonEvent);
void handleEventTestMenuInput(int encoderDelta, ButtonEvent buttonEvent);
void handleEventTestConfigInput(int encoderDelta, ButtonEvent buttonEvent);
void handleEventTestRunInput(ButtonEvent buttonEvent);
void handleImuTestInput(ButtonEvent buttonEvent);
void handleImuYawTestInput(ButtonEvent buttonEvent);
void handleIRSensorTestInput(int encoderDelta, ButtonEvent buttonEvent);
void handleUltrasonicSensorTestInput(ButtonEvent buttonEvent);
void handleMazeTestRunInput(int encoderDelta, ButtonEvent buttonEvent);
void handleStartConfirmInput(ButtonEvent buttonEvent);

void startEventTestRun();
void stopEventTestRun();
void updateEventTestRun();
EventTestConfig& currentEventTestConfig();
Heading currentEventTestHeading();
Heading currentEventTestConfiguredTurn();
const char* eventTestCaseToString(EventTestCase testCase);
EventType selectedEventTestTarget();
PidSource pidSourceForTestMode(PidTestMode mode);
const char* pidTestModeToString(PidTestMode mode);
void updatePidTestDrive();

const char* headingToString(Heading heading);
const char* routeModeToString(RouteMode mode);
const char* eventToString(EventType eventType);
const char* navStateToString(NavState state);
const char* pidSourceToString(PidSource source);
const char* sequenceStepToString();
const char* turnChoiceToString(TurnChoice choice);
void formatCompactValue(char* buffer, size_t size, int value, uint8_t decimals);
void formatPaddedValue(char* buffer, size_t size, int value, uint8_t integerDigits, uint8_t decimals);
void formatDuration(char* buffer, size_t size, uint32_t durationMs);
void formatShortDuration(char* buffer, size_t size, uint32_t durationMs);
void formatPlannerAttemptLine(char* buffer, size_t size, const char* label, const AttemptRecord& record);
static bool eventConfigFieldRelevant(EventTestCase testCase, EventConfigField field);
static int currentEventConfigItemCount();
static EventConfigField currentEventConfigFieldAt(int selectedIndex);
static int normalizeEventTestConfigIndex(int requestedIndex);
static const char* eventConfigDesc1(EventConfigField field);
static const char* eventConfigDesc2(EventConfigField field);
static void eventConfigFieldText(EventConfigField field, char* buffer, size_t size);

void drawHeader(const char* title);
void drawMenuItem(int y, bool selected, const char* text);
void drawScrollableItemList(const char* const* items, int itemCount, int selectedIndex, int startY);
void drawRootScreen();
void drawStartSettingsScreen();
void drawSettingsScreen();
void drawPIDScreen();
void drawImuPidMenuScreen();
void drawPIDTestScreen();
void drawIMUPIDTestScreen();
void drawMotorTuneScreen();
void drawEventTestMenuScreen();
void drawEventTestConfigScreen();
void drawEventTestRunScreen();
void drawIMUTestScreen();
void drawIMUYawTestScreen();
void drawIRSensorTestScreen();
void drawUltrasonicSensorTestScreen();
void drawMazeTestRunScreen();
void drawDigitEditorScreen();
void drawStartConfirmScreen();
void drawRunScreen();
void drawUI();
void startPreviewExecution();
void updatePreviewExecution();

// ======================================================
// Implementation sections
// ======================================================
// Helpers
constexpr float PID_WALL_ERROR_DEADBAND_CM = 0.6f;
constexpr float PID_1WALL_FULL_ERROR_CM = 8.0f;
constexpr float FRONT_HOLD_FULL_ERROR_CM = 4.0f;
constexpr float FRONT_HOLD_ACCEPTANCE_CM = 0.3f;

float applyErrorDeadband(float error, float deadband) {
  if (fabsf(error) <= deadband) return 0.0f;
  if (error > 0.0f) return error - deadband;
  return error + deadband;
}

float computeTwoWallScaledError(float leftCm, float rightCm) {
  float fullErrorCm = max(gCfg.pidTwoWallFullErrorCm, 0.01f);
  float scaled = (rightCm - leftCm) / fullErrorCm;
  return clampFloat(scaled, -1.0f, 1.0f);
}

/*
  One-wall sign convention
  ------------------------
  Positive lateral correction always means "move to the robot's right".

  Therefore:
  - Left wall  too close  -> positive error  -> shift right
  - Left wall  too far    -> negative error  -> shift left
  - Right wall too close  -> negative error  -> shift left
  - Right wall too far    -> positive error  -> shift right

  This keeps the left-wall and right-wall controllers explicitly mirrored.
*/
float computeOneWallScaledError(float distanceCm, bool leftWall) {
  float targetCm = gCfg.pidWallDistanceCm;
  float errorCm = 0.0f;
  if (leftWall) {
    errorCm = targetCm - distanceCm;
  } else {
    errorCm = distanceCm - targetCm;
  }
  return clampFloat(errorCm / PID_1WALL_FULL_ERROR_CM, -1.0f, 1.0f);
}

float fixedToFloat2(int value) {
  return value / 100.0f;
}

float fixedToFloat3(int value) {
  return value / 1000.0f;
}

float fixedToFloat4(int value) {
  return value / 10000.0f;
}

int clampInt(int value, int minValue, int maxValue) {
  if (value < minValue) return minValue;
  if (value > maxValue) return maxValue;
  return value;
}

float clampFloat(float value, float minValue, float maxValue) {
  if (value < minValue) return minValue;
  if (value > maxValue) return maxValue;
  return value;
}

float clampUnit(float value) {
  return clampFloat(value, -1.0f, 1.0f);
}

uint32_t secondsToMs(float seconds) {
  if (seconds <= 0.0f) return 0;
  return (uint32_t)lroundf(seconds * 1000.0f);
}

uint8_t wrap4(int value) {
  while (value < 0) value += 4;
  while (value > 3) value -= 4;
  return (uint8_t)value;
}

static float wrapAngleDeg(float angleDeg) {
  while (angleDeg > 180.0f) angleDeg -= 360.0f;
  while (angleDeg < -180.0f) angleDeg += 360.0f;
  return angleDeg;
}

float signedAngleBetweenDeg(float ax, float ay, float bx, float by) {
  float dot = clampFloat(ax * bx + ay * by, -1.0f, 1.0f);
  float det = ax * by - ay * bx;
  return atan2f(det, dot) * 180.0f / PI;
}

void yawAxisForAngle(float yawDeg, float& xOut, float& yOut) {
  float yawRad = yawDeg * DEG_TO_RAD;
  xOut = cosf(yawRad);
  yOut = sinf(yawRad);
}

float imuGyroRateFloorDps() {
  return sqrtf(IMU_GYRO_ZERO_RATE_LEVEL_DPS * IMU_GYRO_ZERO_RATE_LEVEL_DPS +
               IMU_GYRO_RMS_NOISE_DPS * IMU_GYRO_RMS_NOISE_DPS);
}

float imuReferenceAngleToleranceDeg(float captureDurationS) {
  float noiseTerm = IMU_GYRO_RMS_NOISE_DPS / sqrtf((float)max((int)IMU_REFERENCE_SAMPLES, 1));
  float rateTolDps = sqrtf(IMU_GYRO_ZERO_RATE_LEVEL_DPS * IMU_GYRO_ZERO_RATE_LEVEL_DPS +
                           noiseTerm * noiseTerm);
  return rateTolDps * max(captureDurationS, 0.0f);
}

float imuPlanarAngleToleranceDeg(uint16_t sampleCount, float avgAz) {
  float samples = max((int)sampleCount, 1);
  float noiseTerm = IMU_ACCEL_RMS_NOISE_G / sqrtf((float)samples);
  float planarTolG = sqrtf(2.0f * (IMU_ACCEL_ZERO_G_OFFSET_G * IMU_ACCEL_ZERO_G_OFFSET_G +
                                   noiseTerm * noiseTerm));
  float zReference = max(fabsf(avgAz), IMU_REFERENCE_MIN_Z_G);
  return atan2f(planarTolG, zReference) * 180.0f / PI;
}

float imuMeasurementAngleToleranceDeg(float angleErrorDeg, float dt) {
  float rateAngleTolDeg = imuGyroRateFloorDps() * max(dt, 0.0f);
  float scaleAngleTolDeg = fabsf(angleErrorDeg) * IMU_GYRO_SENS_TOL;
  return sqrtf(rateAngleTolDeg * rateAngleTolDeg +
               scaleAngleTolDeg * scaleAngleTolDeg);
}

void commitRuntimeConfig() {
  uint8_t previousAvgCount = gCfg.ultrasonicAvgCount;
  activeSettings = workingSettings;

  gCfg.wallPidEnabled = (activeSettings.wallPidEnabled != 0);
  gCfg.pid1WallSymmetric = (activeSettings.pid1WallSymmetryEnabled != 0);
  gCfg.p = fixedToFloat3(activeSettings.p_x1000);
  gCfg.i = fixedToFloat3(activeSettings.i_x1000);
  gCfg.d = fixedToFloat3(activeSettings.d_x1000);
  gCfg.pid1WallP = fixedToFloat3(activeSettings.pid1WallP_x1000);
  gCfg.pid1WallI = fixedToFloat3(activeSettings.pid1WallI_x1000);
  gCfg.pid1WallD = fixedToFloat3(activeSettings.pid1WallD_x1000);
  gCfg.pid1WallRightP = fixedToFloat3(activeSettings.pid1WallRightP_x1000);
  gCfg.pid1WallRightI = fixedToFloat3(activeSettings.pid1WallRightI_x1000);
  gCfg.pid1WallRightD = fixedToFloat3(activeSettings.pid1WallRightD_x1000);
  gCfg.imuEnabled = (activeSettings.imuEnabled != 0);
  gCfg.imuSign = (activeSettings.imuSign_x100 < 0) ? -1.0f : 1.0f;
  gCfg.imuP = fixedToFloat4(activeSettings.imuP_x10000);
  gCfg.imuI = fixedToFloat4(activeSettings.imuI_x10000);
  gCfg.imuD = fixedToFloat4(activeSettings.imuD_x10000);
  gCfg.imuLatP = fixedToFloat4(activeSettings.imuLatP_x10000);
  gCfg.imuLatI = fixedToFloat4(activeSettings.imuLatI_x10000);
  gCfg.imuLatD = fixedToFloat4(activeSettings.imuLatD_x10000);
  gCfg.imuLatFilterAlpha = clampFloat(fixedToFloat2(activeSettings.imuLatFilterAlpha_x100), 0.01f, 1.0f);
  gCfg.imuAngleThresholdDeg = fixedToFloat2(activeSettings.imuAngleThreshold_x100);
  gCfg.imuPidTestYawErrorDeg = fixedToFloat2(activeSettings.imuPidTestYawError_x100);
  gCfg.curveB = clampFloat(fixedToFloat2(activeSettings.curveB_x100), 0.10f, 20.0f);
  gCfg.pidTwoWallFullErrorCm = max(fixedToFloat2(activeSettings.pidTwoWallFullError_x100), 0.01f);
  gCfg.pidDeadband2W = clampFloat(fixedToFloat3(activeSettings.pidDeadband2W_x1000), 0.0f, 1.0f);
  gCfg.pidDFilterAlpha = clampFloat(fixedToFloat3(activeSettings.pidDFilterAlpha_x1000), 0.01f, 1.0f);
  gCfg.pidWallDistanceCm = fixedToFloat2(activeSettings.pidWallDistance_x100);
  gCfg.pidLeftScale = fixedToFloat2(activeSettings.pidLeftScale_x100);
  gCfg.pidRightScale = fixedToFloat2(activeSettings.pidRightScale_x100);
  gCfg.overallSpeedScale = clampFloat(fixedToFloat2(activeSettings.overallSpeedScale_x100), 0.0f, 1.0f);
  gCfg.overallStart = clampFloat(fixedToFloat2(activeSettings.overallStart_x100), 0.0f, 1.0f);
  gCfg.overallRampK = clampFloat(fixedToFloat2(activeSettings.overallRampK_x100), 0.0f, 20.0f);
  gCfg.leftTurnRampEnabled = (activeSettings.leftTurnRampEnabled != 0);
  gCfg.rightTurnRampEnabled = (activeSettings.rightTurnRampEnabled != 0);
  gCfg.tJunctionRampEnabled = (activeSettings.tJunctionRampEnabled != 0);
  gCfg.deadEndRampEnabled = (activeSettings.deadEndRampEnabled != 0);
  gCfg.baseSpeed = clampFloat(fixedToFloat2(activeSettings.baseSpeed_x100), 0.0f, 1.0f);
  gCfg.approachSpeed = clampFloat(fixedToFloat2(activeSettings.approachSpeed_x100), 0.0f, 1.0f);
  gCfg.leftDriveScale = clampFloat(fixedToFloat2(activeSettings.leftDriveScale_x100), 0.10f, 3.0f);
  gCfg.rightDriveScale = clampFloat(fixedToFloat2(activeSettings.rightDriveScale_x100), 0.10f, 3.0f);
  gCfg.servoStopFL = clampFloat(fixedToFloat3(activeSettings.servoStopFL_x1000), 0.0f, 180.0f);
  gCfg.servoStopFR = clampFloat(fixedToFloat3(activeSettings.servoStopFR_x1000), 0.0f, 180.0f);
  gCfg.servoStopRR = clampFloat(fixedToFloat3(activeSettings.servoStopRR_x1000), 0.0f, 180.0f);
  gCfg.servoStopRL = clampFloat(fixedToFloat3(activeSettings.servoStopRL_x1000), 0.0f, 180.0f);
  gCfg.servoDeadbandFL = clampFloat(fixedToFloat2(activeSettings.servoDeadbandFL_x100), 0.0f, 1.0f);
  gCfg.servoDeadbandFR = clampFloat(fixedToFloat2(activeSettings.servoDeadbandFR_x100), 0.0f, 1.0f);
  gCfg.servoDeadbandRR = clampFloat(fixedToFloat2(activeSettings.servoDeadbandRR_x100), 0.0f, 1.0f);
  gCfg.servoDeadbandRL = clampFloat(fixedToFloat2(activeSettings.servoDeadbandRL_x100), 0.0f, 1.0f);
  gCfg.pidDeadband1WCm = fixedToFloat2(activeSettings.pidDeadband1W_x100);

  gCfg.frontStopDistanceCm = fixedToFloat2(activeSettings.frontStopDistance_x100);
  gCfg.frontHoldReferenceCm = fixedToFloat2(activeSettings.frontHoldReference_x100);
  gCfg.frontPidP = fixedToFloat3(activeSettings.frontPidP_x1000);
  gCfg.frontPidI = fixedToFloat3(activeSettings.frontPidI_x1000);
  gCfg.frontPidD = fixedToFloat3(activeSettings.frontPidD_x1000);
  gCfg.turnYawToleranceDeg = fixedToFloat2(activeSettings.turnYawTolerance_x100);
  gCfg.corridorWallThresholdCm = fixedToFloat2(activeSettings.corridorWallThreshold_x100);
  gCfg.turnDetectDistanceCm = fixedToFloat2(activeSettings.turnDetectDistance_x100);
  gCfg.deadEndDistanceCm = fixedToFloat2(activeSettings.deadEndDistance_x100);
  gCfg.finishDistanceCm = fixedToFloat2(activeSettings.finishDistance_x100);
  gCfg.sensingIntervalS = clampFloat(fixedToFloat2(activeSettings.sensingInterval_x100), 0.01f, 10.0f);
  gCfg.eventConfirmCount = (uint8_t)clampInt(activeSettings.eventConfirmCount, 1, 9);
  gCfg.ultrasonicAvgCount = (uint8_t)clampInt(activeSettings.ultrasonicAvgCount, 1, ULTRASONIC_AVG_COUNT_MAX);
  gCfg.waitBeforeTurnS = clampFloat(fixedToFloat2(activeSettings.waitBeforeTurn_x100), 0.0f, 30.0f);

  if (gCfg.ultrasonicAvgCount != previousAvgCount) {
    gBufCount = 0;
    gBufIndex = 0;
    gAvgN = 0.0f;
    gAvgE = 0.0f;
    gAvgS = 0.0f;
    gAvgW = 0.0f;
  }

  // Turning IMU usage off must immediately remove its influence everywhere.
  if (!gCfg.imuEnabled) {
    clearImuReference();
    resetImuPid();
    resetImuLateralPid();
    gImuPidTestArmed = false;
  }

  if (!gExecutive.running && !gEventTestRun.active && !gPreviewRun.active) {
    gOverallSpeedActual = gCfg.overallSpeedScale;
    gOverallSpeedUpdateMs = millis();
  }
}

void resetPidRuntime(PidRuntime& runtime) {
  runtime.previousError = 0.0f;
  runtime.integral = 0.0f;
  runtime.derivativeFiltered = 0.0f;
  runtime.previousMs = millis();
}

void resetPid() {
  resetPidRuntime(gPid);
}

void resetAllWallPidRuntimes() {
  resetPidRuntime(gPid);
  resetPidRuntime(gPid1WallSym);
  resetPidRuntime(gPid1WallLeft);
  resetPidRuntime(gPid1WallRight);
}

void resetDrivePidControl() {
  // A wall-source change means the PID error now has a different physical meaning,
  // so both controller memory and the held source selection need a clean reset.
  resetAllWallPidRuntimes();
  resetImuLateralPid();
  gActivePidSource = PidSource::None;
}

void resetWallReference() {
  gWallRef.leftValid = false;
  gWallRef.rightValid = false;
  gWallRef.leftCm = 0.0f;
  gWallRef.rightCm = 0.0f;
}

void updateWallReference(const PerceptionFrame& frame) {
  // Smoothly remember the last reliable side-wall distance so a 2-wall -> 1-wall
  // transition does not suddenly jump to a fixed target from the menu.
  constexpr float memoryBlend = 0.25f;

  if (!frame.ultrasonicValid) return;

  if (frame.left <= gCfg.corridorWallThresholdCm) {
    if (!gWallRef.leftValid) {
      gWallRef.leftCm = frame.left;
      gWallRef.leftValid = true;
    } else {
      gWallRef.leftCm = (1.0f - memoryBlend) * gWallRef.leftCm + memoryBlend * frame.left;
    }
  }

  if (frame.right <= gCfg.corridorWallThresholdCm) {
    if (!gWallRef.rightValid) {
      gWallRef.rightCm = frame.right;
      gWallRef.rightValid = true;
    } else {
      gWallRef.rightCm = (1.0f - memoryBlend) * gWallRef.rightCm + memoryBlend * frame.right;
    }
  }
}

static bool wallStillPresent(float distanceCm, bool wasPresent) {
  float thresholdCm = wasPresent
                        ? (gCfg.corridorWallThresholdCm + PID_SOURCE_HYSTERESIS_CM)
                        : gCfg.corridorWallThresholdCm;
  return distanceCm <= thresholdCm;
}

PidSource stabilizedPidSource(const PerceptionFrame& frame, PidSource previousSource) {
  if (!frame.ultrasonicValid) {
    return PidSource::None;
  }

  bool previousLeftWall =
    previousSource == PidSource::LeftWall || previousSource == PidSource::TwoWall;
  bool previousRightWall =
    previousSource == PidSource::RightWall || previousSource == PidSource::TwoWall;

  bool leftWall = wallStillPresent(frame.left, previousLeftWall);
  bool rightWall = wallStillPresent(frame.right, previousRightWall);

  if (leftWall && rightWall) return PidSource::TwoWall;
  if (leftWall) return PidSource::LeftWall;
  if (rightWall) return PidSource::RightWall;
  return PidSource::None;
}

bool wallPidUsageEnabled() {
  return gCfg.wallPidEnabled;
}

void resetImuPid() {
  gImuPid.previousError = 0.0f;
  gImuPid.integral = 0.0f;
  gImuPid.previousMs = millis();
  gImu.lastCompensationCmd = 0.0f;
}

void resetImuLateralPid() {
  gImuLatPid.filteredLateralBodyG = 0.0f;
  gImuLatPid.previousError = 0.0f;
  gImuLatPid.integral = 0.0f;
  gImuLatPid.previousMs = millis();
}

void resetFrontPid() {
  resetPidRuntime(gFrontPid);
}

bool imuHardwareReady() {
  return gImu.available;
}

bool imuUsageEnabled() {
  return gCfg.imuEnabled && imuHardwareReady();
}

void clearImuReference() {
  gImu.reference.valid = false;
  gImu.referenceValid = false;
  gImu.yawErrorDeg = 0.0f;
  gImu.measurementAngleTolDeg = 0.0f;
  gImu.combinedDeadbandDeg = 0.0f;
  gImu.lastCompensationCmd = 0.0f;
  gImu.compensationHoldUntilMs = 0;
}

void holdImuCompensation(float seconds) {
  // A short hold keeps the controller from fighting a heading that we just changed on purpose.
  uint32_t holdUntilMs = millis() + secondsToMs(seconds);
  if (holdUntilMs > gImu.compensationHoldUntilMs) {
    gImu.compensationHoldUntilMs = holdUntilMs;
  }
  resetImuPid();
}

bool imuCaptureSampleLooksStill(float ax, float ay, float az, float gx, float gy, float gz) {
  // Reference capture is only trusted while the rover is stationary enough that gyro bias is meaningful.
  float accelNormG = sqrtf(ax * ax + ay * ay + az * az);
  float gyroNormDps = sqrtf(gx * gx + gy * gy + gz * gz);
  return fabsf(accelNormG - 1.0f) <= IMU_CAPTURE_MAX_NORM_ERR_G &&
         gyroNormDps <= IMU_CAPTURE_MAX_GYRO_DPS;
}

Heading headingFromIndex(uint8_t index) {
  static const Heading headings[4] = {
    Heading::North, Heading::East, Heading::South, Heading::West
  };
  return headings[index & 0x03];
}

uint8_t headingToIndex(Heading heading) {
  switch (heading) {
    case Heading::North: return 0;
    case Heading::East:  return 1;
    case Heading::South: return 2;
    case Heading::West:  return 3;
    default:             return 0;
  }
}

Heading turnLeftOf(Heading heading) {
  return headingFromIndex(wrap4((int)headingToIndex(heading) - 1));
}

Heading turnRightOf(Heading heading) {
  return headingFromIndex(wrap4((int)headingToIndex(heading) + 1));
}

Heading oppositeOf(Heading heading) {
  return headingFromIndex(wrap4((int)headingToIndex(heading) + 2));
}

float distanceForHeading(Heading heading) {
  float ultrasonicByIndex[4] = {
    (gBufCount > 0) ? gAvgN : gDistN,
    (gBufCount > 0) ? gAvgE : gDistE,
    (gBufCount > 0) ? gAvgS : gDistS,
    (gBufCount > 0) ? gAvgW : gDistW
  };
  return ultrasonicByIndex[headingToIndex(heading)];
}

const char* headingToString(Heading heading) {
  switch (heading) {
    case Heading::North: return "N";
    case Heading::East:  return "E";
    case Heading::South: return "S";
    case Heading::West:  return "W";
    default:             return "?";
  }
}

const char* routeModeToString(RouteMode mode) {
  switch (mode) {
    case RouteMode::Sequence:  return "Sequence";
    case RouteMode::Right:     return "Right";
    case RouteMode::Left:      return "Left";
    case RouteMode::Selection: return "Selection";
    default:                   return "?";
  }
}

const char* eventToString(EventType eventType) {
  switch (eventType) {
    case EventType::Idle:             return "Idle";
    case EventType::Start:            return "Start";
    case EventType::Corridor:         return "Corridor";
    case EventType::LeftTurn:         return "Left Turn";
    case EventType::RightTurn:        return "Right Turn";
    case EventType::TJunction:        return "T-Junction";
    case EventType::TJunctionStraight: return "T-Straight";
    case EventType::DeadEnd:          return "Dead-End";
    case EventType::Finish:           return "Finish";
    case EventType::SensorWait:       return "Sensor Wait";
    case EventType::SafetyStop:       return "Safety Stop";
    default:                          return "?";
  }
}

const char* navStateToString(NavState state) {
  switch (state) {
    case NavState::Idle:            return "Idle";
    case NavState::StartSeek:       return "Start";
    case NavState::Corridor:        return "Corridor";
    case NavState::ApproachWall:    return "Approach";
    case NavState::FrontNormalize:  return "FrontHold";
    case NavState::AcquireCorridor: return "Acquire";
    case NavState::SafetyStop:      return "Stop";
    case NavState::Finished:        return "Finish";
    default:                        return "?";
  }
}

const char* pidSourceToString(PidSource source) {
  switch (source) {
    case PidSource::None:      return "None";
    case PidSource::LeftWall:  return "1W Left";
    case PidSource::RightWall: return "1W Right";
    case PidSource::TwoWall:   return "2W";
    default:                   return "?";
  }
}

static AttemptRecord& plannerRecordForMode(RouteMode mode) {
  switch (mode) {
    case RouteMode::Right:     return gPlanner.rightAttempt;
    case RouteMode::Left:      return gPlanner.leftAttempt;
    case RouteMode::Selection: return gPlanner.selectionAttempt;
    default:                   return gPlanner.selectionAttempt;
  }
}

static void clearAttemptRecord(AttemptRecord& record) {
  record.valid = false;
  record.hadDeadEnd = false;
  record.durationMs = 0;
  record.chosenMode = RouteMode::Selection;
}

static void resetPlannerAttemptHistory() {
  clearAttemptRecord(gPlanner.rightAttempt);
  clearAttemptRecord(gPlanner.leftAttempt);
  clearAttemptRecord(gPlanner.selectionAttempt);
  gPlanner.lastAttemptDurationMs = 0;
  gPlanner.currentAttemptRecordMode = RouteMode::Right;
  gPlanner.currentAttemptExecutionMode = RouteMode::Right;
  gPlanner.currentAttemptHadDeadEnd = false;
}

static const char* routeModeShortString(RouteMode mode) {
  switch (mode) {
    case RouteMode::Right:     return "R";
    case RouteMode::Left:      return "L";
    case RouteMode::Selection: return "S";
    default:                   return "-";
  }
}

static bool planNextAttempt(RouteMode& executionMode, RouteMode& recordMode, const char*& errorText) {
  errorText = nullptr;
  RouteMode configuredMode = currentRouteMode();
  if (configuredMode != RouteMode::Sequence) {
    executionMode = configuredMode;
    recordMode = configuredMode;
    return true;
  }

  switch (gPlanner.sequenceSlot % 3) {
    case 0:
      executionMode = RouteMode::Right;
      recordMode = RouteMode::Right;
      return true;
    case 1:
      executionMode = RouteMode::Left;
      recordMode = RouteMode::Left;
      return true;
    default:
      recordMode = RouteMode::Selection;
      if (!gPlanner.rightAttempt.valid || !gPlanner.leftAttempt.valid) {
        executionMode = RouteMode::Selection;
        errorText = "Need R+L first";
        return false;
      }
      if (gPlanner.rightAttempt.hadDeadEnd && gPlanner.leftAttempt.hadDeadEnd) {
        executionMode = RouteMode::Selection;
        errorText = "Err: both dead-end";
        return false;
      }
      if (gPlanner.rightAttempt.hadDeadEnd) {
        executionMode = RouteMode::Left;
        return true;
      }
      if (gPlanner.leftAttempt.hadDeadEnd) {
        executionMode = RouteMode::Right;
        return true;
      }
      executionMode = (gPlanner.rightAttempt.durationMs <= gPlanner.leftAttempt.durationMs)
                        ? RouteMode::Right
                        : RouteMode::Left;
      return true;
  }
}

const char* nextTrialModeToString() {
  RouteMode executionMode = RouteMode::Selection;
  RouteMode recordMode = RouteMode::Selection;
  const char* errorText = nullptr;
  if (!planNextAttempt(executionMode, recordMode, errorText)) {
    return "Sel ERR";
  }
  if (recordMode == RouteMode::Selection && currentRouteMode() == RouteMode::Sequence) {
    return (executionMode == RouteMode::Right) ? "Sel->Right" : "Sel->Left";
  }
  return routeModeToString(executionMode);
}

const char* sequenceStepToString() {
  if (currentRouteMode() != RouteMode::Sequence) return "-";
  switch (gPlanner.sequenceSlot % 3) {
    case 0: return "Right";
    case 1: return "Left";
    default: return "Selection";
  }
}

const char* turnChoiceToString(TurnChoice choice) {
  return (choice == TurnChoice::Left) ? "Left" : "Right";
}

const char* eventTestCaseToString(EventTestCase testCase) {
  switch (testCase) {
    case EventTestCase::Corridor:          return "Corridor";
    case EventTestCase::TJunction:         return "T-Junction";
    case EventTestCase::DeadEnd:           return "Dead-end";
    case EventTestCase::Start:             return "Auto Start";
    case EventTestCase::Finish:            return "Finish";
    case EventTestCase::LeftTurn:          return "Left Turn";
    case EventTestCase::RightTurn:         return "Right Turn";
    case EventTestCase::TJunctionStraight: return "T-Jct Straight";
    case EventTestCase::Random:            return "Random";
    case EventTestCase::Back:              return "Back";
    default:                               return "?";
  }
}

EventTestConfig& currentEventTestConfig() {
  return gEventTestConfigs[(int)gSelectedEventTest];
}

Heading currentEventTestHeading() {
  return headingFromIndex(currentEventTestConfig().headingIndex);
}

Heading currentEventTestConfiguredTurn() {
  return (currentEventTestConfig().turnChoice == TurnChoice::Left)
           ? turnLeftOf(gEventTestRun.heading)
           : turnRightOf(gEventTestRun.heading);
}

EventType selectedEventTestTarget() {
  switch (gSelectedEventTest) {
    case EventTestCase::Corridor:          return EventType::Corridor;
    case EventTestCase::TJunction:         return EventType::TJunction;
    case EventTestCase::DeadEnd:           return EventType::DeadEnd;
    case EventTestCase::Start:             return EventType::Start;
    case EventTestCase::Finish:            return EventType::Finish;
    case EventTestCase::LeftTurn:          return EventType::LeftTurn;
    case EventTestCase::RightTurn:         return EventType::RightTurn;
    case EventTestCase::TJunctionStraight: return EventType::TJunctionStraight;
    case EventTestCase::Random:            return EventType::Idle;
    case EventTestCase::Back:
    default:                               return EventType::Idle;
  }
}

static bool eventTestStartsWithFinishArmed(EventTestCase testCase) {
  return testCase != EventTestCase::TJunction;
}

static bool eventTestStartsWithTJunctionStraightArmed(EventTestCase testCase) {
  return testCase == EventTestCase::TJunctionStraight;
}

PidSource pidSourceForTestMode(PidTestMode mode) {
  switch (mode) {
    case PidTestMode::TwoWall:      return PidSource::TwoWall;
    case PidTestMode::OneWallLeft:  return PidSource::LeftWall;
    case PidTestMode::OneWallRight: return PidSource::RightWall;
    case PidTestMode::NoWall:
    default:                        return PidSource::None;
  }
}

const char* pidTestModeToString(PidTestMode mode) {
  switch (mode) {
    case PidTestMode::TwoWall:      return "2Wall";
    case PidTestMode::OneWallLeft:  return "1Wall L";
    case PidTestMode::OneWallRight: return "1Wall R";
    case PidTestMode::NoWall:       return "NoWall";
    default:                        return "-";
  }
}

static int pow10i(uint8_t exponent) {
  int value = 1;
  for (uint8_t i = 0; i < exponent; ++i) {
    value *= 10;
  }
  return value;
}

void formatCompactValue(char* buffer, size_t size, int value, uint8_t decimals) {
  int scale = pow10i(decimals);
  int safeValue = max(value, 0);
  int whole = (scale > 0) ? (safeValue / scale) : safeValue;
  int fraction = (scale > 0) ? abs(safeValue % scale) : 0;

  if (decimals == 0) {
    snprintf(buffer, size, "%d", safeValue);
  } else {
    snprintf(buffer, size, "%d.%0*d", whole, decimals, fraction);
  }
}

void formatPaddedValue(char* buffer, size_t size, int value, uint8_t integerDigits, uint8_t decimals) {
  int scale = pow10i(decimals);
  int safeValue = max(value, 0);
  int whole = (scale > 0) ? (safeValue / scale) : safeValue;
  int fraction = (scale > 0) ? abs(safeValue % scale) : 0;

  if (decimals == 0) {
    snprintf(buffer, size, "%0*d", integerDigits, whole);
  } else {
    snprintf(buffer, size, "%0*d.%0*d", integerDigits, whole, decimals, fraction);
  }
}

void formatDuration(char* buffer, size_t size, uint32_t durationMs) {
  uint32_t totalSeconds = durationMs / 1000UL;
  uint32_t minutes = totalSeconds / 60UL;
  uint32_t seconds = totalSeconds % 60UL;
  uint32_t centiseconds = (durationMs % 1000UL) / 10UL;
  snprintf(buffer, size, "%lu:%02lu.%02lu",
           (unsigned long)minutes,
          (unsigned long)seconds,
          (unsigned long)centiseconds);
}

void formatShortDuration(char* buffer, size_t size, uint32_t durationMs) {
  uint32_t totalSeconds = durationMs / 1000UL;
  uint32_t minutes = totalSeconds / 60UL;
  uint32_t seconds = totalSeconds % 60UL;
  snprintf(buffer, size, "%lu:%02lu",
           (unsigned long)minutes,
           (unsigned long)seconds);
}

void formatPlannerAttemptLine(char* buffer, size_t size, const char* label, const AttemptRecord& record) {
  if (!record.valid) {
    snprintf(buffer, size, "%s: --", label);
    return;
  }

  char duration[12];
  formatShortDuration(duration, sizeof(duration), record.durationMs);
  if (record.chosenMode == RouteMode::Selection) {
    snprintf(buffer, size, "%s:%s %s", label, duration, record.hadDeadEnd ? "DE" : "OK");
  } else {
    snprintf(buffer, size, "%s:%s %s %s", label, duration,
             routeModeShortString(record.chosenMode),
             record.hadDeadEnd ? "DE" : "OK");
  }
}

// Input
void onEncoderEdge() {
  uint8_t a = (uint8_t)digitalRead(ENC_A_PIN);
  uint8_t b = (uint8_t)digitalRead(ENC_B_PIN);
  // Use only channel A interrupts and sample channel B for direction.
  // This keeps the menu sensitivity at two edges per UI step while reducing
  // ISR load and making the encoder less likely to miss a detent under timing load.
  if (a == b) {
    gEncoderRawDelta++;
  } else {
    gEncoderRawDelta--;
  }
}

ButtonEvent readButtonEvent(bool allowInput) {
  bool rawLevel = digitalRead(ENC_BTN_PIN);
  uint32_t now = millis();

  if (!allowInput) {
    gButton.lastRawLevel = rawLevel;
    gButton.stableLevel = rawLevel;
    gButton.longPressReported = false;
    if (rawLevel == LOW) {
      gButton.pressedAtMs = now;
    }
    return ButtonEvent::None;
  }

  ButtonEvent result = ButtonEvent::None;

  if (rawLevel != gButton.lastRawLevel) {
    gButton.lastRawLevel = rawLevel;
    gButton.lastDebounceMs = now;
  }

  if ((now - gButton.lastDebounceMs) >= BUTTON_DEBOUNCE_MS) {
    if (gButton.stableLevel != rawLevel) {
      gButton.stableLevel = rawLevel;
      if (rawLevel == LOW) {
        gButton.pressedAtMs = now;
        gButton.longPressReported = false;
      } else {
        if (!gButton.longPressReported) {
          result = ButtonEvent::ShortPress;
        }
      }
    }
  }

  if (gButton.stableLevel == LOW && !gButton.longPressReported) {
    if ((now - gButton.pressedAtMs) >= BUTTON_LONGPRESS_MS) {
      gButton.longPressReported = true;
      result = ButtonEvent::LongPress;
    }
  }

  return result;
}

void openDigitEditor(const char* label, const char* unit, int* target, int minValue, int maxValue,
                     const char* desc1, const char* desc2, Screen returnScreen,
                     uint8_t integerDigits, uint8_t decimals) {
  gDigitEditor.active = true;
  gDigitEditor.digitUnlocked = false;
  gDigitEditor.selectedDigit = 0;
  gDigitEditor.integerDigits = integerDigits;
  gDigitEditor.decimals = decimals;
  gDigitEditor.digitCount = integerDigits + decimals;
  gDigitEditor.targetValue = target;
  gDigitEditor.tempValue = (target != nullptr) ? *target : 0;
  gDigitEditor.minValue = minValue;
  gDigitEditor.maxValue = maxValue;
  gDigitEditor.label = label;
  gDigitEditor.unit = unit;
  gDigitEditor.description1 = desc1;
  gDigitEditor.description2 = desc2;
  gDigitEditor.returnScreen = returnScreen;
  gPreviousScreen = returnScreen;
  gCurrentScreen = Screen::DigitEditor;
}

void closeDigitEditor(bool commitValue) {
  if (commitValue && gDigitEditor.targetValue != nullptr) {
    *gDigitEditor.targetValue = clampInt(gDigitEditor.tempValue,
                                         gDigitEditor.minValue,
                                         gDigitEditor.maxValue);
    commitRuntimeConfig();
  }
  gDigitEditor.active = false;
  gDigitEditor.digitUnlocked = false;
  gCurrentScreen = gDigitEditor.returnScreen;
}

static int placeValueForDigit(uint8_t selectedDigit) {
  int exponent = (int)gDigitEditor.digitCount - 1 - (int)selectedDigit;
  return pow10i((uint8_t)max(exponent, 0));
}

static int getDigitAt(int value, uint8_t selectedDigit) {
  int place = placeValueForDigit(selectedDigit);
  return (value / place) % 10;
}

static int setDigitAt(int value, uint8_t selectedDigit, int newDigit) {
  int place = placeValueForDigit(selectedDigit);
  int currentDigit = getDigitAt(value, selectedDigit);
  return value + (newDigit - currentDigit) * place;
}

void handleDigitEditorInput(int encoderDelta, ButtonEvent buttonEvent) {
  if (encoderDelta != 0) {
    if (!gDigitEditor.digitUnlocked) {
      int nextDigit = (int)gDigitEditor.selectedDigit + encoderDelta;
      while (nextDigit < 0) nextDigit += gDigitEditor.digitCount;
      while (nextDigit >= gDigitEditor.digitCount) nextDigit -= gDigitEditor.digitCount;
      gDigitEditor.selectedDigit = (uint8_t)nextDigit;
    } else {
      int digit = getDigitAt(gDigitEditor.tempValue, gDigitEditor.selectedDigit);
      digit += encoderDelta;
      while (digit < 0) digit += 10;
      while (digit > 9) digit -= 10;
      gDigitEditor.tempValue = setDigitAt(gDigitEditor.tempValue, gDigitEditor.selectedDigit, digit);
      gDigitEditor.tempValue = clampInt(gDigitEditor.tempValue,
                                        gDigitEditor.minValue,
                                        gDigitEditor.maxValue);
    }
  }

  if (buttonEvent == ButtonEvent::ShortPress) {
    gDigitEditor.digitUnlocked = !gDigitEditor.digitUnlocked;
  } else if (buttonEvent == ButtonEvent::LongPress) {
    closeDigitEditor(true);
  }
}

// Sensors and perception
bool isIrTriggered(int value) {
  return value == HIGH;
}

uint8_t buildIrMaskFromPins() {
  uint8_t mask = 0;
  // Restore the direct front/rear interpretation of the IR pin names while
  // keeping left/right unchanged:
  //   FL -> NW, FR -> NE, RR -> SE, RL -> SW
  if (isIrTriggered(gIrFL)) mask |= 0x04; // NW / FL
  if (isIrTriggered(gIrFR)) mask |= 0x08; // NE / FR
  if (isIrTriggered(gIrRL)) mask |= 0x01; // SW / RL
  if (isIrTriggered(gIrRR)) mask |= 0x02; // SE / RR
  return mask;
}

void readIRSensors() {
  // Swap EAST <-> WEST while keeping FRONT/REAR the same.
  // Logical mapping wanted:
  //   FL <- physical FR
  //   FR <- physical FL
  //   RL <- physical RR
  //   RR <- physical RL
  gIrFL = digitalRead(PIN_IR_RL); //RL
  gIrFR = digitalRead(PIN_IR_RR); //RR
  gIrRL = digitalRead(PIN_IR_FL); //FL
  gIrRR = digitalRead(PIN_IR_FR); //FR

  gRawIrMask = buildIrMaskFromPins();
  gStableIrMask = gRawIrMask;
}

bool ultrasonicFresh() {
  return gUltrasonicValid && (millis() - gLastUltrasonicMs) <= ULTRASONIC_STALE_MS;
}

bool parseDistancesLine(const char* line, float& d1, float& d2, float& d3, float& d4) {
  if (line == nullptr) return false;

  float v1 = 0.0f;
  float v2 = 0.0f;
  float v3 = 0.0f;
  float v4 = 0.0f;

  int matched = sscanf(line, "D1:%f,D2:%f,D3:%f,D4:%f", &v1, &v2, &v3, &v4);
  if (matched != 4) return false;

  if (v1 < 0.0f || v1 > SENSOR_MAX_VALID_CM) return false;
  if (v2 < 0.0f || v2 > SENSOR_MAX_VALID_CM) return false;
  if (v3 < 0.0f || v3 > SENSOR_MAX_VALID_CM) return false;
  if (v4 < 0.0f || v4 > SENSOR_MAX_VALID_CM) return false;

  d1 = v1;
  d2 = v2;
  d3 = v3;
  d4 = v4;
  return true;
}

void pushUltrasonicAverages(float north, float east, float south, float west) {
  uint8_t avgCount = max((int)gCfg.ultrasonicAvgCount, 1);
  gBufN[gBufIndex] = north;
  gBufE[gBufIndex] = east;
  gBufS[gBufIndex] = south;
  gBufW[gBufIndex] = west;

  gBufIndex = (uint8_t)((gBufIndex + 1) % avgCount);
  if (gBufCount < avgCount) {
    gBufCount++;
  }

  float sumN = 0.0f;
  float sumE = 0.0f;
  float sumS = 0.0f;
  float sumW = 0.0f;
  for (uint8_t i = 0; i < gBufCount; ++i) {
    sumN += gBufN[i];
    sumE += gBufE[i];
    sumS += gBufS[i];
    sumW += gBufW[i];
  }

  if (gBufCount > 0) {
    float scale = 1.0f / gBufCount;
    gAvgN = sumN * scale;
    gAvgE = sumE * scale;
    gAvgS = sumS * scale;
    gAvgW = sumW * scale;
  }
}

static void serviceUartSensorStream() {
  while (Serial1.available()) {
    char c = (char)Serial1.read();
    if (c == '\r') continue;

    if (c == '\n') {
      gUartLine[gUartPos] = '\0';

      float d1 = 0.0f;
      float d2 = 0.0f;
      float d3 = 0.0f;
      float d4 = 0.0f;
      if (parseDistancesLine(gUartLine, d1, d2, d3, d4)) {
        // Match the newer Uno sender contract used by uno_sensor_sender_v3:
        // D1=N, D2=E, D3=S, D4=W.
        gDistN = d3;
        gDistE = d4;
        gDistS = d1;
        gDistW = d2;
        pushUltrasonicAverages(gDistN, gDistE, gDistS, gDistW);
        gUltrasonicSampleId++;
        gUltrasonicValid = true;
        gLastUltrasonicMs = millis();
      }
      gUartPos = 0;
      continue;
    }

    if (gUartPos < sizeof(gUartLine) - 1) {
      gUartLine[gUartPos++] = c;
    } else {
      gUartPos = 0;
    }
  }
}

void initImu() {
  // Hardware probing is runtime-only now. Menu toggle decides whether
  // the IMU is used, but we still try to initialize the onboard device once.
  gImu.available = IMU.begin();
  if (!gImu.available) {
    //Serial.println("IMU init failed. LSM6DSOX yaw hold disabled.");
    return;
  }
  //Serial.println("IMU ready. LSM6DSOX runtime control enabled.");
}

static bool sampleImuBlocking(float& ax, float& ay, float& az, float& gx, float& gy, float& gz) {
  uint32_t startMs = millis();
  while ((millis() - startMs) < IMU_SAMPLE_TIMEOUT_MS) {
    if (IMU.accelerationAvailable() && IMU.gyroscopeAvailable()) {
      IMU.readAcceleration(ax, ay, az);
      IMU.readGyroscope(gx, gy, gz);
      return true;
    }
    delay(IMU_SAMPLE_POLL_DELAY_MS);
  }
  ax = ay = 0.0f;
  az = 1.0f;
  gx = gy = gz = 0.0f;
  return false;
}

void updateImuDerivedState() {
  yawAxisForAngle(gImu.yawDeg, gImu.currentXAxisX, gImu.currentXAxisY);

  if (!gImu.referenceValid) {
    gImu.yawErrorDeg = 0.0f;
    gImu.measurementAngleTolDeg = 0.0f;
    gImu.combinedDeadbandDeg = 0.0f;
    return;
  }

  gImu.yawErrorDeg = signedAngleBetweenDeg(gImu.reference.xAxisX, gImu.reference.xAxisY,
                                           gImu.currentXAxisX, gImu.currentXAxisY);
  gImu.measurementAngleTolDeg = imuMeasurementAngleToleranceDeg(gImu.yawErrorDeg, gImu.sampleDtS);
  gImu.combinedDeadbandDeg =
    sqrtf(gImu.reference.angleTolDeg * gImu.reference.angleTolDeg +
          gImu.measurementAngleTolDeg * gImu.measurementAngleTolDeg) +
    gCfg.imuAngleThresholdDeg;
}

void updateImu() {
  if (!imuHardwareReady()) return;

  // When IMU usage is switched off from the menu, we stop updating
  // the control state so no event handler or drive path can use it.
  if (!gCfg.imuEnabled) {
    gImu.yawRateDps = 0.0f;
    gImu.yawErrorDeg = 0.0f;
    gImu.measurementAngleTolDeg = 0.0f;
    gImu.combinedDeadbandDeg = 0.0f;
    gImu.lastCompensationCmd = 0.0f;
    return;
  }

  if (IMU.accelerationAvailable()) {
    IMU.readAcceleration(gImu.ax, gImu.ay, gImu.az);
  }

  if (IMU.gyroscopeAvailable()) {
    IMU.readGyroscope(gImu.gx, gImu.gy, gImu.gz);

    uint32_t now = millis();
    float dt = (gImu.lastSampleMs == 0) ? 0.01f : (now - gImu.lastSampleMs) / 1000.0f;
    dt = clampFloat(dt, 0.005f, 0.100f);
    gImu.lastSampleMs = now;
    gImu.sampleDtS = dt;

    float yawRateDps = (gImu.gz - gImu.gyroBiasZDps) * gCfg.imuSign;
    float absYawRateDps = fabsf(yawRateDps);
    if (absYawRateDps < IMU_GYRO_SOFT_ZONE_DPS) {
      // Use a smooth low-rate taper instead of a hard dead zone so slow real turns do not accumulate late.
      float scale = absYawRateDps / IMU_GYRO_SOFT_ZONE_DPS;
      yawRateDps *= scale * scale;
    }

    gImu.yawRateDps = yawRateDps;
    gImu.yawDeg = wrapAngleDeg(gImu.yawDeg + yawRateDps * dt);
  }

  updateImuDerivedState();
}

bool captureImuReference() {
  if (!imuUsageEnabled()) return false;

  float sumAx = 0.0f;
  float sumAy = 0.0f;
  float sumAz = 0.0f;
  float sumGz = 0.0f;
  uint16_t goodSamples = 0;
  uint32_t startMs = millis();

  // Allow extra attempts so we can reject moving samples instead of storing a bad reference.
  for (uint16_t i = 0; i < IMU_REFERENCE_SAMPLES * 3 && goodSamples < IMU_REFERENCE_SAMPLES; ++i) {
    float ax, ay, az, gx, gy, gz;
    if (!sampleImuBlocking(ax, ay, az, gx, gy, gz)) {
      continue;
    }

    if (!imuCaptureSampleLooksStill(ax, ay, az, gx, gy, gz)) {
      delay(IMU_REFERENCE_SAMPLE_DELAY_MS);
      continue;
    }

    sumAx += ax;
    sumAy += ay;
    sumAz += az;
    sumGz += gz;
    goodSamples++;
    delay(IMU_REFERENCE_SAMPLE_DELAY_MS);
  }

  if (goodSamples < (IMU_REFERENCE_SAMPLES / 2)) {
    gImu.reference.valid = false;
    gImu.referenceValid = false;
    //Serial.println("IMU reference rejected. Keep robot still during capture.");
    return false;
  }

  float sampleScale = 1.0f / goodSamples;
  gImu.reference.avgAx = sumAx * sampleScale;
  gImu.reference.avgAy = sumAy * sampleScale;
  gImu.reference.avgAz = sumAz * sampleScale;
  gImu.gyroBiasZDps = sumGz * sampleScale;
  // Re-zero yaw at capture time so the controller works on fresh relative rotation only.
  gImu.yawDeg = 0.0f;
  gImu.reference.yawDeg = 0.0f;
  yawAxisForAngle(gImu.reference.yawDeg, gImu.reference.xAxisX, gImu.reference.xAxisY);
  gImu.reference.yAxisX = -gImu.reference.xAxisY;
  gImu.reference.yAxisY = gImu.reference.xAxisX;
  gImu.reference.planarTolG = sqrtf(2.0f * (IMU_ACCEL_ZERO_G_OFFSET_G * IMU_ACCEL_ZERO_G_OFFSET_G +
                                            sq(IMU_ACCEL_RMS_NOISE_G / sqrtf((float)goodSamples))));

  float captureDurationS = (millis() - startMs) / 1000.0f;
  float gyroTolDeg = imuReferenceAngleToleranceDeg(captureDurationS);
  float planarTolDeg = imuPlanarAngleToleranceDeg(goodSamples, gImu.reference.avgAz);
  gImu.reference.angleTolDeg = sqrtf(gyroTolDeg * gyroTolDeg + planarTolDeg * planarTolDeg);
  gImu.reference.capturedMs = millis();
  gImu.reference.valid = true;
  gImu.referenceValid = true;

  resetImuPid();
  holdImuCompensation(IMU_REANCHOR_HOLD_S);
  updateImuDerivedState();

  //Serial.print("IMU reference saved. biasZ[dps]=");
  //Serial.print(gImu.gyroBiasZDps, 3);
  //Serial.print(" deadbandBase[deg]=");
  //Serial.println(gImu.reference.angleTolDeg, 3);
  return true;
}

void refreshSensors() {
  readIRSensors();
  serviceUartSensorStream();
  updateImu();
}

RelativeIrState relativeIrForHeading(uint8_t mask, Heading heading) {
  // World IR order: [NW, NE, SE, SW]
  bool worldIr[4] = {
    (mask & 0x04) != 0,
    (mask & 0x08) != 0,
    (mask & 0x02) != 0,
    (mask & 0x01) != 0
  };

  // Relative order when heading North:
  // [front-left, front-right, rear-right, rear-left] = [NW, NE, SE, SW]
  int headingIndex = headingToIndex(heading);
  RelativeIrState relative;
  relative.frontLeft = worldIr[wrap4(0 + headingIndex)];
  relative.frontRight = worldIr[wrap4(1 + headingIndex)];
  relative.rearRight = worldIr[wrap4(2 + headingIndex)];
  relative.rearLeft = worldIr[wrap4(3 + headingIndex)];
  return relative;
}

static bool frontPairBlocked(const RelativeIrState& ir) {
  return ir.frontLeft && ir.frontRight;
}

static bool frontPairOpen(const RelativeIrState& ir) {
  return !ir.frontLeft && !ir.frontRight;
}

static bool rearPairOpen(const RelativeIrState& ir) {
  return !ir.rearLeft && !ir.rearRight;
}

static bool tJunctionStraightReady(bool tJunctionRaised, bool deadEndRaised) {
  return tJunctionRaised && deadEndRaised;
}

PidSource choosePidSource(const PerceptionFrame& frame) {
  // The displayed source uses the same averaged ultrasonic geometry as the
  // runtime event and wall-following logic. The live controller still adds
  // extra hysteresis in stabilizedPidSource().
  if (!frame.ultrasonicValid) return PidSource::None;

  bool leftWall = frame.left <= gCfg.corridorWallThresholdCm;
  bool rightWall = frame.right <= gCfg.corridorWallThresholdCm;

  if (leftWall && rightWall) return PidSource::TwoWall;
  if (leftWall) return PidSource::LeftWall;
  if (rightWall) return PidSource::RightWall;
  return PidSource::None;
}

bool corridorSignatureForFrame(const PerceptionFrame& frame) {
  return frame.ultrasonicValid &&
         frame.left <= gCfg.corridorWallThresholdCm &&
         frame.right <= gCfg.corridorWallThresholdCm;
}

bool startSignatureForFrame(const PerceptionFrame& frame) {
  return frame.ultrasonicValid &&
         frame.ir.frontLeft &&
         frame.ir.frontRight &&
         frame.left <= gCfg.corridorWallThresholdCm &&
         frame.right <= gCfg.corridorWallThresholdCm;
}

EventType classifyCandidateEvent(const PerceptionFrame& frame) {
  return classifyCandidateEvent(frame, false, false);
}

EventType classifyCandidateEvent(const PerceptionFrame& frame, bool finishArmed) {
  return classifyCandidateEvent(frame, finishArmed, false);
}

EventType classifyCandidateEvent(const PerceptionFrame& frame, bool finishArmed, bool tJunctionStraightArmed) {
  if (!frame.ultrasonicValid) {
    return EventType::SensorWait;
  }

  float frontCm = frame.front;
  float leftCm = frame.left;
  float rightCm = frame.right;
  bool leftWall = leftCm <= gCfg.corridorWallThresholdCm;
  bool rightWall = rightCm <= gCfg.corridorWallThresholdCm;
  bool frontClose = frontCm <= gCfg.turnDetectDistanceCm;

  if (finishArmed &&
      frontPairOpen(frame.ir) &&
      rearPairOpen(frame.ir) &&
      frontCm >= gCfg.finishDistanceCm &&
      !leftWall &&
      !rightWall) {
    return EventType::Finish;
  }

  if (frontCm < gCfg.deadEndDistanceCm &&
      frame.ir.frontLeft &&
      frame.ir.frontRight) {
    return EventType::DeadEnd;
  }

  if (frame.ir.frontLeft &&
      frame.ir.frontRight &&
      leftWall &&
      rightWall) {
    return EventType::Start;
  }

  if (!leftWall && rightWall && frontClose) {
    return EventType::LeftTurn;
  }

  if (!rightWall && leftWall && frontClose) {
    return EventType::RightTurn;
  }

  if (!leftWall && !rightWall && frontClose) {
    return EventType::TJunction;
  }

  if (tJunctionStraightArmed &&
      (!leftWall || !rightWall) &&
      frontCm > gCfg.turnDetectDistanceCm) {
    return EventType::TJunctionStraight;
  }

  return EventType::Corridor;
}

static bool legacyDeadEndStopTriggered(const PerceptionFrame& frame) {
  // Legacy dead-end handling is still driven by the original front IR +
  // front-distance signature. During that case we only align and reverse;
  // the correction-stage override logic is intentionally disabled.
  return frame.ultrasonicValid &&
         frame.front < gCfg.deadEndDistanceCm &&
         frame.ir.frontLeft &&
         frame.ir.frontRight;
}

static bool correctionStageUltrasonicDeadEndDetected(const PerceptionFrame& frame) {
  // This stricter all-ultrasonic dead-end rule is only used while the robot
  // is already stopped and correcting its position after FrontStop.
  return frame.ultrasonicValid &&
         frame.front < gCfg.corridorWallThresholdCm &&
         frame.left < gCfg.corridorWallThresholdCm &&
         frame.right < gCfg.corridorWallThresholdCm;
}

static bool postCorrectionDeadEndTriggered(const PerceptionFrame& frame, EventType currentEvent) {
  // Once the robot is already stopped for some other event, dead-end must no
  // longer be allowed to hijack the stop through the old front-IR signature.
  // After correction completes we only accept a dead-end override if the
  // forward, left, and right ultrasonic channels are all blocked.
  if (currentEvent == EventType::DeadEnd || currentEvent == EventType::Start) {
    return false;
  }

  return correctionStageUltrasonicDeadEndDetected(frame);
}

static EventType correctionStageCandidate(const PerceptionFrame& frame, bool allowDeadEndConfirm) {
  // During the active correction phase we only keep confirming left/right/
  // T-junction/finish. Dead-end is intentionally deferred until correction is
  // complete so a close stop for some other event cannot be hijacked by the
  // old front-IR based dead-end rule.
  (void)allowDeadEndConfirm;

  switch (frame.candidate) {
    case EventType::Finish:
    case EventType::LeftTurn:
    case EventType::RightTurn:
    case EventType::TJunction:
      return frame.candidate;

    default:
      return EventType::Idle;
  }
}

static EventType postCorrectionTurnCandidate(const PerceptionFrame& frame) {
  switch (frame.candidate) {
    case EventType::LeftTurn:
    case EventType::RightTurn:
    case EventType::TJunction:
      return frame.candidate;

    default:
      return EventType::Idle;
  }
}


static EventType sequentialEventAfterCorrection(const PerceptionFrame& frame) {
  if (!frame.ultrasonicValid) return EventType::SensorWait;

  bool frontBlocked = frame.front < gCfg.corridorWallThresholdCm;
  bool leftOpen = frame.left > gCfg.corridorWallThresholdCm;
  bool rightOpen = frame.right > gCfg.corridorWallThresholdCm;
  bool leftBlocked = !leftOpen;
  bool rightBlocked = !rightOpen;

  if (frontBlocked && leftBlocked && rightBlocked) {
    return EventType::DeadEnd;
  }
  if (frontBlocked && leftOpen && rightOpen) {
    return EventType::TJunction;
  }
  if (frontBlocked && leftOpen && rightBlocked) {
    return EventType::LeftTurn;
  }
  if (frontBlocked && rightOpen && leftBlocked) {
    return EventType::RightTurn;
  }

  return EventType::Corridor;
}

PerceptionFrame buildPerceptionFrame(Heading heading) {
  return buildPerceptionFrame(heading, false, false);
}

PerceptionFrame buildPerceptionFrame(Heading heading, bool finishArmed) {
  return buildPerceptionFrame(heading, finishArmed, false);
}

PerceptionFrame buildPerceptionFrame(Heading heading, bool finishArmed, bool tJunctionStraightArmed) {
  PerceptionFrame frame;
  frame.ultrasonicValid = ultrasonicFresh();
  frame.ultrasonicSampleId = gUltrasonicSampleId;
  frame.stableIrMask = gStableIrMask;
  frame.ir = relativeIrForHeading(gStableIrMask, heading);

  frame.north = (gBufCount > 0) ? gAvgN : gDistN;
  frame.east = (gBufCount > 0) ? gAvgE : gDistE;
  frame.south = (gBufCount > 0) ? gAvgS : gDistS;
  frame.west = (gBufCount > 0) ? gAvgW : gDistW;

  frame.front = distanceForHeading(heading);
  frame.left = distanceForHeading(turnLeftOf(heading));
  frame.right = distanceForHeading(turnRightOf(heading));
  frame.back = distanceForHeading(oppositeOf(heading));
  // Keep the event path fully aligned with the older v37 behavior: every
  // consumer sees the same averaged ultrasonic geometry instead of mixing
  // raw detection with filtered handling.
  frame.northRaw = frame.north;
  frame.eastRaw = frame.east;
  frame.southRaw = frame.south;
  frame.westRaw = frame.west;
  frame.frontRaw = frame.front;
  frame.leftRaw = frame.left;
  frame.rightRaw = frame.right;
  frame.backRaw = frame.back;

  frame.candidate = classifyCandidateEvent(frame, finishArmed, tJunctionStraightArmed);
  frame.corridorSignature = corridorSignatureForFrame(frame);
  frame.pidSource = choosePidSource(frame);
  return frame;
}

void resetEventConfirmation() {
  gExecutive.eventConfirm.active = false;
  gExecutive.eventConfirm.candidate = EventType::Idle;
  gExecutive.eventConfirm.matches = 0;
  gExecutive.eventConfirm.nextCheckMs = 0;
  gExecutive.eventConfirm.lastSampleId = 0;
}

void resetCorridorConfirmation() {
  gExecutive.corridorConfirm.active = false;
  gExecutive.corridorConfirm.matches = 0;
  gExecutive.corridorConfirm.nextCheckMs = 0;
  gExecutive.corridorConfirm.lastSampleId = 0;
}

bool updateEventConfirmation(const PerceptionFrame& frame, EventType& confirmedEvent) {
  confirmedEvent = EventType::Idle;

  EventType candidate = frame.candidate;
  if (candidate == EventType::Corridor ||
      candidate == EventType::Idle ||
      candidate == EventType::Start ||
      candidate == EventType::SensorWait) {
    resetEventConfirmation();
    return false;
  }

  uint32_t now = millis();
  EventConfirmState& state = gExecutive.eventConfirm;
  if (!state.active || state.candidate != candidate) {
    state.active = true;
    state.candidate = candidate;
    state.matches = 1;
    state.nextCheckMs = now + secondsToMs(gCfg.sensingIntervalS);
    return false;
  }

  if (now < state.nextCheckMs) {
    return false;
  }

  state.matches++;
  state.nextCheckMs = now + secondsToMs(gCfg.sensingIntervalS);

  if (state.matches >= gCfg.eventConfirmCount) {
    confirmedEvent = candidate;
    resetEventConfirmation();
    return true;
  }

  return false;
}

bool updateCorridorConfirmation(const PerceptionFrame& frame) {
  if (!frame.corridorSignature) {
    resetCorridorConfirmation();
    return false;
  }

  uint32_t now = millis();
  CorridorConfirmState& state = gExecutive.corridorConfirm;

  if (!state.active) {
    state.active = true;
    state.matches = 1;
    state.nextCheckMs = now + secondsToMs(gCfg.sensingIntervalS);
    return false;
  }

  if (now < state.nextCheckMs) {
    return false;
  }

  state.matches++;
  state.nextCheckMs = now + secondsToMs(gCfg.sensingIntervalS);

  if (state.matches >= gCfg.eventConfirmCount) {
    resetCorridorConfirmation();
    return true;
  }

  return false;
}

// Planner
RouteMode currentRouteMode() {
  return (RouteMode)activeSettings.routeMode;
}

RouteMode effectiveRouteMode() {
  RouteMode executionMode = RouteMode::Selection;
  RouteMode recordMode = RouteMode::Selection;
  const char* errorText = nullptr;
  if (planNextAttempt(executionMode, recordMode, errorText)) {
    return executionMode;
  }
  return RouteMode::Selection;
}

Heading chooseHeadingForEvent(const PerceptionFrame& frame, EventType eventType, Heading currentHeading) {
  switch (eventType) {
    case EventType::LeftTurn:
      return turnLeftOf(currentHeading);
    case EventType::RightTurn:
      return turnRightOf(currentHeading);
    case EventType::DeadEnd:
      return oppositeOf(currentHeading);
    case EventType::TJunctionStraight:
      return currentHeading;
    case EventType::TJunction: {
      RouteMode mode = effectiveRouteMode();
      if (mode == RouteMode::Right) {
        return turnRightOf(currentHeading);
      }
      if (mode == RouteMode::Left) {
        return turnLeftOf(currentHeading);
      }
      if (frame.left > frame.right) {
        return turnLeftOf(currentHeading);
      }
      return turnRightOf(currentHeading);
    }
    default:
      return currentHeading;
  }
}

// Motion control
float wallErrorInterpretLimit(PidSource source) {
  return (source == PidSource::None) ? PID_INTERPRET_LIMIT_CM : 1.0f;
}

float shapedMagnitude(float magnitude, float interpretLimit) {
  float absMagnitude = fabsf(magnitude);
  float safeLimit = max(interpretLimit, 0.001f);
  if (absMagnitude < safeLimit) {
    float ratio = absMagnitude / safeLimit;
    return safeLimit * powf(ratio, gCfg.curveB);
  }
  return absMagnitude;
}

float shapeSignedError(float error, float interpretLimit) {
  if (error == 0.0f) return 0.0f;
  float sign = (error >= 0.0f) ? 1.0f : -1.0f;
  return sign * shapedMagnitude(error, interpretLimit);
}

float shapeSignedError(float error) {
  return shapeSignedError(error, PID_INTERPRET_LIMIT_CM);
}

float computeWallError(const PerceptionFrame& frame, PidSource source) {
  switch (source) {
    case PidSource::TwoWall:
      return computeTwoWallScaledError(frame.left, frame.right);
    case PidSource::LeftWall:
      return computeOneWallScaledError(frame.left, true);
    case PidSource::RightWall:
      return computeOneWallScaledError(frame.right, false);
    case PidSource::None:
    default:
      return 0.0f;
  }
}

float computePidWithRuntime(PidRuntime& runtime, float error, PidSource source,
                            float pGain, float iGain, float dGain) {
  uint32_t now = millis();
  float dt = (runtime.previousMs == 0) ? 0.01f : (now - runtime.previousMs) / 1000.0f;
  dt = clampFloat(dt, 0.01f, 0.20f);
  if (dt < 1e-4f) dt = 1e-4f;

  float shapedError = shapeSignedError(error, wallErrorInterpretLimit(source));
  float derivativeRaw = (shapedError - runtime.previousError) / dt;
  float dAlpha = gCfg.pidDFilterAlpha;
  runtime.derivativeFiltered += dAlpha * (derivativeRaw - runtime.derivativeFiltered);

  runtime.integral += shapedError * dt;
  runtime.integral = clampFloat(runtime.integral, -PID_INTEGRAL_LIMIT, PID_INTEGRAL_LIMIT);

  float output = pGain * shapedError +
                 iGain * runtime.integral +
                 dGain * runtime.derivativeFiltered;

  runtime.previousError = shapedError;
  runtime.previousMs = now;

  if (output < 0.0f) {
    output *= gCfg.pidLeftScale;
  } else if (output > 0.0f) {
    output *= gCfg.pidRightScale;
  }

  return clampFloat(output, -1.0f, 1.0f);
}

float computePid(float error, PidSource source) {
  return computePidWithRuntime(gPid, error, source, gCfg.p, gCfg.i, gCfg.d);
}

float computeWallCorrection(const PerceptionFrame& frame, PidSource source) {
  if (!wallPidUsageEnabled() || source == PidSource::None) {
    resetAllWallPidRuntimes();
    return 0.0f;
  }

  float wallError = computeWallError(frame, source);
  if (source == PidSource::TwoWall) {
    wallError = applyErrorDeadband(wallError, gCfg.pidDeadband2W);
    return computePid(wallError, source);
  }

  wallError = applyErrorDeadband(wallError, gCfg.pidDeadband1WCm / PID_1WALL_FULL_ERROR_CM);
  if (gCfg.pid1WallSymmetric) {
    return computePidWithRuntime(gPid1WallSym, wallError, source,
                                 gCfg.pid1WallP, gCfg.pid1WallI, gCfg.pid1WallD);
  }

  if (source == PidSource::LeftWall) {
    return computePidWithRuntime(gPid1WallLeft, wallError, source,
                                 gCfg.pid1WallP, gCfg.pid1WallI, gCfg.pid1WallD);
  }

  return computePidWithRuntime(gPid1WallRight, wallError, source,
                               gCfg.pid1WallRightP, gCfg.pid1WallRightI, gCfg.pid1WallRightD);
}

float applyImuCompensation(ImuPidRuntime& runtime) {
  updateImuDerivedState();

  if (!imuUsageEnabled() || !gImu.referenceValid) {
    runtime.previousError = 0.0f;
    runtime.integral = 0.0f;
    runtime.previousMs = millis();
    gImu.lastCompensationCmd = 0.0f;
    return 0.0f;
  }

  float errorDeg = gImu.yawErrorDeg;
  float deadbandDeg = gImu.combinedDeadbandDeg;

  uint32_t now = millis();
  float dt = (runtime.previousMs == 0) ? 0.01f : (now - runtime.previousMs) / 1000.0f;
  dt = clampFloat(dt, 0.01f, 0.20f);
  runtime.previousMs = now;

  if (now < gImu.compensationHoldUntilMs) {
    // Intentional turns get a short quiet window so the IMU controller does not kick during settling.
    runtime.previousError = 0.0f;
    runtime.integral *= 0.80f;
    gImu.lastCompensationCmd = 0.0f;
    return 0.0f;
  }

  if (fabsf(errorDeg) <= deadbandDeg) {
    runtime.previousError = 0.0f;
    runtime.integral *= 0.85f;
    gImu.lastCompensationCmd = 0.0f;
    return 0.0f;
  }

  float effectiveErrorDeg = (errorDeg > 0.0f)
                              ? (errorDeg - deadbandDeg)
                              : (errorDeg + deadbandDeg);
  float normalizedError = effectiveErrorDeg / IMU_ERROR_FULL_SCALE_DEG;
  float derivative = (normalizedError - runtime.previousError) / dt;

  runtime.integral += normalizedError * dt;
  runtime.integral = clampFloat(runtime.integral, -IMU_PID_INTEGRAL_LIMIT, IMU_PID_INTEGRAL_LIMIT);

  float output = gCfg.imuP * normalizedError +
                 gCfg.imuI * runtime.integral +
                 gCfg.imuD * derivative;

  runtime.previousError = normalizedError;
  float maxDelta = IMU_OUTPUT_SLEW_PER_S * dt;
  output = clampFloat(output,
                      gImu.lastCompensationCmd - maxDelta,
                      gImu.lastCompensationCmd + maxDelta);
  output = clampFloat(output, -1.0f, 1.0f);
  gImu.lastCompensationCmd = output;
  return output;
}

float currentImuRotationCompensation(ImuPidRuntime& runtime) {
  // Keep the IMU-off path explicit everywhere so PID tuning cannot accidentally
  // inherit stale rotational correction from a previous enabled state.
  if (!imuUsageEnabled()) {
    runtime.previousError = 0.0f;
    runtime.integral = 0.0f;
    runtime.previousMs = millis();
    gImu.lastCompensationCmd = 0.0f;
    return 0.0f;
  }

  return applyImuCompensation(runtime);
}

float currentImuLateralCompensation(float forwardSpeed) {
  if (!imuUsageEnabled() || fabsf(forwardSpeed) <= 0.0001f) {
    resetImuLateralPid();
    return 0.0f;
  }

  uint32_t now = millis();
  float dt = (gImuLatPid.previousMs == 0) ? 0.01f : (now - gImuLatPid.previousMs) / 1000.0f;
  dt = clampFloat(dt, 0.01f, 0.20f);
  gImuLatPid.previousMs = now;

  // Rotate the IMU planar axes into robot-body forward/lateral axes, then
  // damp only the signed lateral component while NoWalls is active.
  float aForwardBody = IMU_BODY_AXIS_C45 * gImu.ax + IMU_BODY_AXIS_C45 * gImu.ay;
  float aLateralBody = -IMU_BODY_AXIS_C45 * gImu.ax + IMU_BODY_AXIS_C45 * gImu.ay;
  (void)aForwardBody;

  gImuLatPid.filteredLateralBodyG +=
    gCfg.imuLatFilterAlpha * (aLateralBody - gImuLatPid.filteredLateralBodyG);

  float error = -gImuLatPid.filteredLateralBodyG;
  float derivative = (error - gImuLatPid.previousError) / dt;

  gImuLatPid.integral += error * dt;
  gImuLatPid.integral = clampFloat(gImuLatPid.integral,
                                   -IMU_PID_INTEGRAL_LIMIT,
                                   IMU_PID_INTEGRAL_LIMIT);

  float output = gCfg.imuLatP * error +
                 gCfg.imuLatI * gImuLatPid.integral +
                 gCfg.imuLatD * derivative;

  gImuLatPid.previousError = error;
  return clampFloat(output, -1.0f, 1.0f);
}

static void setOverallSpeedActual(float speed) {
  gOverallSpeedActual = clampFloat(speed, 0.0f, gCfg.overallSpeedScale);
  gOverallSpeedUpdateMs = millis();
}

static void syncOverallSpeedActualToTarget() {
  setOverallSpeedActual(gCfg.overallSpeedScale);
}

static bool rampResumeEnabledForEvent(EventType eventType) {
  switch (eventType) {
    case EventType::LeftTurn:  return gCfg.leftTurnRampEnabled;
    case EventType::RightTurn: return gCfg.rightTurnRampEnabled;
    case EventType::TJunction: return gCfg.tJunctionRampEnabled;
    case EventType::DeadEnd:   return gCfg.deadEndRampEnabled;
    default:                   return false;
  }
}

static void prepareOverallSpeedAfterStopEvent(EventType eventType) {
  if (rampResumeEnabledForEvent(eventType)) {
    setOverallSpeedActual(0.0f);
  } else {
    syncOverallSpeedActualToTarget();
  }
}

static void initializeRuntimeOverallSpeed(bool startLimited) {
  if (startLimited) {
    setOverallSpeedActual(min(gCfg.overallStart, gCfg.overallSpeedScale));
  } else {
    syncOverallSpeedActualToTarget();
  }
}

static void updateOverallSpeedActualForState(NavState state) {
  uint32_t now = millis();
  float dt = (gOverallSpeedUpdateMs == 0) ? 0.0f : (now - gOverallSpeedUpdateMs) / 1000.0f;
  gOverallSpeedUpdateMs = now;

  if (state == NavState::StartSeek) {
    gOverallSpeedActual = min(gCfg.overallStart, gCfg.overallSpeedScale);
    return;
  }

  if (state == NavState::FrontNormalize) {
    gOverallSpeedActual = 0.0f;
    return;
  }

  if (gOverallSpeedActual > gCfg.overallSpeedScale) {
    gOverallSpeedActual = gCfg.overallSpeedScale;
    return;
  }

  if (gOverallSpeedActual < gCfg.overallSpeedScale && dt > 0.0f) {
    gOverallSpeedActual = min(gOverallSpeedActual + gCfg.overallRampK * dt,
                              gCfg.overallSpeedScale);
  }
}

static bool holdPostCorrectionRelease(bool& releaseActive, const PerceptionFrame& frame) {
  if (!releaseActive) return false;

  // After a correction-stage event has been confirmed we must let the robot
  // actually depart in the newly selected direction instead of immediately
  // feeding the fresh heading back into the same FrontStop gate.
  if (frame.ultrasonicValid && frame.front >= gCfg.frontStopDistanceCm) {
    releaseActive = false;
    return false;
  }

  return true;
}

static float computeFrontNormalizedError(float measuredFrontCm) {
  float errorCm = measuredFrontCm - gCfg.frontHoldReferenceCm;
  return clampFloat(errorCm / FRONT_HOLD_FULL_ERROR_CM, -1.0f, 1.0f);
}

static float computeFrontPidCorrection(float measuredFrontCm) {
  uint32_t now = millis();
  float dt = (gFrontPid.previousMs == 0) ? 0.01f : (now - gFrontPid.previousMs) / 1000.0f;
  dt = clampFloat(dt, 0.01f, 0.20f);
  gFrontPid.previousMs = now;

  float error = computeFrontNormalizedError(measuredFrontCm);
  float deadband = FRONT_HOLD_ACCEPTANCE_CM / FRONT_HOLD_FULL_ERROR_CM;
  error = applyErrorDeadband(error, deadband);

  float derivativeRaw = (error - gFrontPid.previousError) / dt;
  gFrontPid.derivativeFiltered +=
    gCfg.pidDFilterAlpha * (derivativeRaw - gFrontPid.derivativeFiltered);

  gFrontPid.integral += error * dt;
  gFrontPid.integral = clampFloat(gFrontPid.integral, -PID_INTEGRAL_LIMIT, PID_INTEGRAL_LIMIT);

  float output = gCfg.frontPidP * error +
                 gCfg.frontPidI * gFrontPid.integral +
                 gCfg.frontPidD * gFrontPid.derivativeFiltered;

  gFrontPid.previousError = error;
  return clampFloat(output, -1.0f, 1.0f);
}

static bool yawNormalizationComplete() {
  if (!imuUsageEnabled() || !gImu.referenceValid) {
    return true;
  }

  float allowedYawErrorDeg = max(gCfg.turnYawToleranceDeg, gImu.combinedDeadbandDeg);
  return fabsf(gImu.yawErrorDeg) <= allowedYawErrorDeg;
}

static bool deadEndNormalizationComplete(const PerceptionFrame& frame) {
  if (!frame.ultrasonicValid) return false;

  PidSource controlSource = stabilizedPidSource(frame, gActivePidSource);
  if (wallPidUsageEnabled() && controlSource != PidSource::None) {
    float wallError = computeWallError(frame, controlSource);
    float allowedWallError = (controlSource == PidSource::TwoWall)
                               ? max(gCfg.pidDeadband2W, 0.01f)
                               : max(gCfg.pidDeadband1WCm / PID_1WALL_FULL_ERROR_CM, 0.01f);
    if (fabsf(wallError) > allowedWallError) {
      return false;
    }
  }

  return yawNormalizationComplete();
}

static bool eventUsesFrontHold(EventType eventType) {
  switch (eventType) {
    case EventType::DeadEnd:
    case EventType::Start:
      return false;

    default:
      return true;
  }
}

static bool frontNormalizationComplete(const PerceptionFrame& frame, EventType eventType) {
  if (eventType == EventType::Start) {
    if (!frame.ultrasonicValid) return false;

    bool leftWall = frame.left <= gCfg.corridorWallThresholdCm;
    bool rightWall = frame.right <= gCfg.corridorWallThresholdCm;
    if (!leftWall || !rightWall) return false;

    float wallError = computeWallError(frame, PidSource::TwoWall);
    float allowedWallError = max(gCfg.pidDeadband2W, 0.01f);
    if (fabsf(wallError) > allowedWallError) return false;

    return yawNormalizationComplete();
  }

  if (!eventUsesFrontHold(eventType)) {
    return deadEndNormalizationComplete(frame);
  }

  if (!frame.ultrasonicValid) return false;
  if (fabsf(frame.front - gCfg.frontHoldReferenceCm) > FRONT_HOLD_ACCEPTANCE_CM) return false;
  return yawNormalizationComplete();
}

static void runFrontNormalization(Heading heading, const PerceptionFrame& frame, EventType eventType) {
  updateWallReference(frame);
  PidSource controlSource = (eventType == EventType::Start)
                              ? PidSource::TwoWall
                              : stabilizedPidSource(frame, gActivePidSource);
  if (controlSource != gActivePidSource) {
    gActivePidSource = controlSource;
    resetAllWallPidRuntimes();
  }

  float lateralCorrection = 0.0f;
  if (controlSource != PidSource::None) {
    resetImuLateralPid();
    lateralCorrection = computeWallCorrection(frame, controlSource);
  } else {
    resetImuLateralPid();
  }

  float forwardCorrection = !eventUsesFrontHold(eventType)
                              ? 0.0f
                              : computeFrontPidCorrection(frame.front);
  float rotationComp = currentImuRotationCompensation(gImuPid);
  driveRobotFrameAdvanced(lateralCorrection, 0.0f, forwardCorrection, rotationComp, heading);
}

float servoStopAngleForWheel(WheelId wheel) {
  switch (wheel) {
    case WheelId::FL: return gCfg.servoStopFL;
    case WheelId::FR: return gCfg.servoStopFR;
    case WheelId::RR: return gCfg.servoStopRR;
    case WheelId::RL: return gCfg.servoStopRL;
    default:          return (float)STOP_FL;
  }
}

float servoDeadbandForWheel(WheelId wheel) {
  switch (wheel) {
    case WheelId::FL: return gCfg.servoDeadbandFL;
    case WheelId::FR: return gCfg.servoDeadbandFR;
    case WheelId::RR: return gCfg.servoDeadbandRR;
    case WheelId::RL: return gCfg.servoDeadbandRL;
    default:          return 0.0f;
  }
}

int servoRangeForWheel(WheelId wheel) {
  switch (wheel) {
    case WheelId::FL: return RANGE_FL;
    case WheelId::FR: return RANGE_FR;
    case WheelId::RR: return RANGE_RR;
    case WheelId::RL: return RANGE_RL;
    default:          return RANGE_FL;
  }
}

int servoInvertForWheel(WheelId wheel) {
  switch (wheel) {
    case WheelId::FL: return INV_FL;
    case WheelId::FR: return INV_FR;
    case WheelId::RR: return INV_RR;
    case WheelId::RL: return INV_RL;
    default:          return INV_FL;
  }
}

void writeServoCommand(Servo& servo, float stopAngle, int rangeAngle, int invert, float cmd) {
  cmd = clampUnit(cmd) * (float)invert;

  int usStop = 1000 + (int)lroundf((stopAngle / 180.0f) * 1000.0f);
  int usRange = (int)lroundf((rangeAngle / 180.0f) * 1000.0f);
  int usValue = usStop + (int)lroundf(cmd * usRange);
  usValue = constrain(usValue, 1000, 2000);
  servo.writeMicroseconds(usValue);
}

void writeWheelCommand(WheelId wheel, Servo& servo, float cmd) {
  float stopAngle = servoStopAngleForWheel(wheel);
  int rangeAngle = servoRangeForWheel(wheel);
  int invert = servoInvertForWheel(wheel);

  // Each wheel gets its own near-zero neutral zone so tiny residual commands
  // can be forced to the calibrated stop center instead of creeping.
  if (fabsf(cmd) <= servoDeadbandForWheel(wheel)) {
    writeServoCommand(servo, stopAngle, rangeAngle, invert, 0.0f);
    return;
  }

  writeServoCommand(servo, stopAngle, rangeAngle, invert, cmd);
}

void stopAll() {
  writeWheelCommand(WheelId::FL, servoFL, 0.0f);
  writeWheelCommand(WheelId::FR, servoFR, 0.0f);
  writeWheelCommand(WheelId::RR, servoRR, 0.0f);
  writeWheelCommand(WheelId::RL, servoRL, 0.0f);
}

static void normalizeWheelEnvelope(float& fl, float& fr, float& rr, float& rl) {
  float maxAbs =
    max(max(fabsf(fl), fabsf(fr)),
        max(fabsf(rr), fabsf(rl)));

  if (maxAbs > 1.0f) {
    float scale = 1.0f / maxAbs;
    fl *= scale;
    fr *= scale;
    rr *= scale;
    rl *= scale;
  }
}

static float clampTowardZero(float candidate, float baseCmd) {
  if (baseCmd > 0.0f) {
    return clampFloat(candidate, 0.0f, baseCmd);
  }
  if (baseCmd < 0.0f) {
    return clampFloat(candidate, baseCmd, 0.0f);
  }
  return candidate;
}

/*
  Limited base-motion mixer
  -------------------------
  Base translation comes from the commanded travel direction only and is scaled
  by the global speed factor. Lateral/rotational compensation is then allowed
  to reduce that base motion toward zero, but not reverse it while the robot is
  already translating. Pure rotation is still allowed whenever the base command
  for a wheel is zero, which keeps the isolated IMU PID test working.
*/
static void driveBodyFrameLimited(float baseVx, float baseVy,
                                  float compVx, float compVy,
                                  float w) {
  float basePlus = baseVy + baseVx;
  float baseMinus = baseVy - baseVx;
  w = clampUnit(w);

  float baseTranslationMax =
    max(fabsf(basePlus) * gCfg.leftDriveScale,
        fabsf(baseMinus) * gCfg.rightDriveScale);
  if (baseTranslationMax > 1.0f) {
    float baseScale = 1.0f / baseTranslationMax;
    basePlus *= baseScale;
    baseMinus *= baseScale;
  }

  // overallSpeedScale remains the configured target; overallSpeedActual is the
  // live ramped execution speed used by the drive path.
  basePlus *= gOverallSpeedActual;
  baseMinus *= gOverallSpeedActual;

  float compPlus = compVy + compVx;
  float compMinus = compVy - compVx;

  float pairPlus = clampTowardZero(basePlus + compPlus, basePlus);
  float pairMinus = clampTowardZero(baseMinus + compMinus, baseMinus);

  float flBase = pairPlus * gCfg.leftDriveScale;
  float rrBase = pairPlus * gCfg.leftDriveScale;
  float frBase = pairMinus * gCfg.rightDriveScale;
  float rlBase = pairMinus * gCfg.rightDriveScale;

  float fl = flBase + w * gCfg.leftDriveScale;
  float rr = rrBase - w * gCfg.leftDriveScale;
  float fr = frBase - w * gCfg.rightDriveScale;
  float rl = rlBase + w * gCfg.rightDriveScale;

  if (fabsf(flBase) > 0.0001f) fl = clampTowardZero(fl, flBase);
  if (fabsf(rrBase) > 0.0001f) rr = clampTowardZero(rr, rrBase);
  if (fabsf(frBase) > 0.0001f) fr = clampTowardZero(fr, frBase);
  if (fabsf(rlBase) > 0.0001f) rl = clampTowardZero(rl, rlBase);

  normalizeWheelEnvelope(fl, fr, rr, rl);

  writeWheelCommand(WheelId::FL, servoFL, fl);
  writeWheelCommand(WheelId::FR, servoFR, fr);
  writeWheelCommand(WheelId::RR, servoRR, rr);
  writeWheelCommand(WheelId::RL, servoRL, rl);
}

/*
  45 degree omni X-drive layout
  -----------------------------
  FL and RR share the +45 degree diagonal, FR and RL share the -45 degree diagonal.

    u+ = vy + vx   -> FL, RR translation term
    u- = vy - vx   -> FR, RL translation term

  Rotational compensation is injected as an orthogonal spin pattern:

    spin = [+w, -w, -w, +w]

  Robust saturation policy:
  1. Keep pure translation inside the wheel envelope first.
  2. Add rotational compensation on top.
  3. Renormalize the final four wheel commands together if needed.

  This avoids impossible translation requests and keeps partial yaw authority
  instead of dropping it to zero when the drive is heavily loaded.
*/
static void driveBodyFrame(float vx, float vy, float w) {
  float basePlus = vy + vx;
  float baseMinus = vy - vx;
  w = clampUnit(w);

  float translationMax =
    max(fabsf(basePlus) * gCfg.leftDriveScale,
        fabsf(baseMinus) * gCfg.rightDriveScale);
  if (translationMax > 1.0f) {
    float translationScale = 1.0f / translationMax;
    basePlus *= translationScale;
    baseMinus *= translationScale;
  }

  float fl = (basePlus + w) * gCfg.leftDriveScale;
  float rr = (basePlus - w) * gCfg.leftDriveScale;
  float fr = (baseMinus - w) * gCfg.rightDriveScale;
  float rl = (baseMinus + w) * gCfg.rightDriveScale;

  normalizeWheelEnvelope(fl, fr, rr, rl);

  writeWheelCommand(WheelId::FL, servoFL, fl);
  writeWheelCommand(WheelId::FR, servoFR, fr);
  writeWheelCommand(WheelId::RR, servoRR, rr);
  writeWheelCommand(WheelId::RL, servoRL, rl);
}

void driveRobotFrame(float lateralCmd, float forwardCmd, float rotationCmd, Heading heading) {
  float baseVx = 0.0f;
  float baseVy = 0.0f;
  float compVx = 0.0f;
  float compVy = 0.0f;

  // Positive lateralCmd always means "shift to the robot's right" regardless
  // of maze heading. The heading mapping below rotates that signed request into
  // the body-frame X/Y axes used by the omni drive mixer.

  switch (heading) {
    case Heading::North:
      baseVy = forwardCmd;
      compVx = lateralCmd;
      break;
    case Heading::East:
      baseVx = forwardCmd;
      compVy = -lateralCmd;
      break;
    case Heading::South:
      baseVy = -forwardCmd;
      compVx = -lateralCmd;
      break;
    case Heading::West:
      baseVx = -forwardCmd;
      compVy = lateralCmd;
      break;
  }

  driveBodyFrameLimited(baseVx, baseVy, compVx, compVy, rotationCmd);
}

void driveRobotFrameAdvanced(float lateralCmd, float baseForwardCmd, float forwardCompCmd, float rotationCmd, Heading heading) {
  float baseVx = 0.0f;
  float baseVy = 0.0f;
  float compVx = 0.0f;
  float compVy = 0.0f;

  switch (heading) {
    case Heading::North:
      baseVy = baseForwardCmd;
      compVx = lateralCmd;
      compVy = forwardCompCmd;
      break;
    case Heading::East:
      baseVx = baseForwardCmd;
      compVy = -lateralCmd;
      compVx = forwardCompCmd;
      break;
    case Heading::South:
      baseVy = -baseForwardCmd;
      compVx = -lateralCmd;
      compVy = -forwardCompCmd;
      break;
    case Heading::West:
      baseVx = -baseForwardCmd;
      compVy = lateralCmd;
      compVx = -forwardCompCmd;
      break;
  }

  driveBodyFrameLimited(baseVx, baseVy, compVx, compVy, rotationCmd);
}

/*
  Runtime usage architecture
  --------------------------
  1. refreshSensors() updates IR, UART ultrasonics, and the onboard LSM6DSOX yaw state.
  2. beginExecution() / startEventTestRun() capture the current body frame as the IMU reference.
  3. followSmart() computes:
       lateral correction  <- wall PID, or IMU lateral drift suppression in NoWalls
       rotation correction <- IMU yaw-hold PID with tolerance-aware deadband
  4. driveRobotFrame() maps maze-relative motion into body-frame vx/vy while keeping the yaw
     compensation as a separate rotational term for the 45 degree omni X-drive.
*/
void followSmart(Heading heading, float forwardSpeed) {
  PerceptionFrame frame = buildPerceptionFrame(heading);
  if (!frame.ultrasonicValid) {
    resetDrivePidControl();
    resetFrontPid();
    stopAll();
    return;
  }

  updateWallReference(frame);
  PidSource controlSource = stabilizedPidSource(frame, gActivePidSource);
  if (controlSource != gActivePidSource) {
    gActivePidSource = controlSource;
    resetAllWallPidRuntimes();
  }

  float correction = 0.0f;
  if (controlSource == PidSource::None) {
    correction = currentImuLateralCompensation(forwardSpeed);
  } else {
    resetImuLateralPid();
    correction = computeWallCorrection(frame, controlSource);
  }
  float rotationComp = currentImuRotationCompensation(gImuPid);
  driveRobotFrame(correction, forwardSpeed, rotationComp, heading);
}

void followSmartForced(Heading heading, float forwardSpeed, PidSource forcedSource) {
  PerceptionFrame frame = buildPerceptionFrame(heading);
  if (!frame.ultrasonicValid) {
    resetDrivePidControl();
    resetFrontPid();
    stopAll();
    return;
  }

  if (forcedSource != gActivePidSource) {
    gActivePidSource = forcedSource;
    resetAllWallPidRuntimes();
  }

  float correction = 0.0f;
  if (forcedSource == PidSource::None) {
    correction = currentImuLateralCompensation(forwardSpeed);
  } else {
    resetImuLateralPid();
    correction = computeWallCorrection(frame, forcedSource);
  }
  float rotationComp = currentImuRotationCompensation(gImuPid);
  driveRobotFrame(correction, forwardSpeed, rotationComp, heading);
}

// Executive
static void resetPlannerCycleIfNeeded() {
  if (currentRouteMode() == RouteMode::Sequence && gPlanner.sequenceCycleComplete) {
    gPlanner.sequenceSlot = 0;
    gPlanner.sequenceCycleComplete = false;
    gPlanner.totalDurationMs = 0;
    resetPlannerAttemptHistory();
  }
}

void beginExecution() {
  RouteMode executionMode = RouteMode::Selection;
  RouteMode recordMode = RouteMode::Selection;
  const char* errorText = nullptr;
  resetPlannerCycleIfNeeded();
  if (!planNextAttempt(executionMode, recordMode, errorText)) {
    stopAll();
    gCurrentScreen = Screen::StartConfirm;
    return;
  }
  gPlanner.attemptCounter++;
  gPlanner.currentAttemptExecutionMode = executionMode;
  gPlanner.currentAttemptRecordMode = recordMode;
  gPlanner.currentAttemptHadDeadEnd = false;
  gFinishInterrupt.pending = false;
  gFinishInterrupt.stopMs = 0;
  gExecutive.finishArmed = false;
  gExecutive.tJunctionRaised = false;
  gExecutive.deadEndRaised = false;
  resetWallReference();
  gImuPidTestArmed = false;

  if (imuUsageEnabled()) {
    (void)captureImuReference();
  } else {
    clearImuReference();
  }

  gExecutive.running = true;
  gExecutive.state = NavState::StartSeek;
  gExecutive.heading = headingFromIndex(activeSettings.startHeadingIndex);
  gExecutive.pendingHeading = gExecutive.heading;
  gExecutive.correctionConfirmEnabled = true;
  gExecutive.postCorrectionReleaseActive = false;
  gExecutive.displayEvent = EventType::Start;
  gExecutive.latchedEvent = EventType::Start;
  gExecutive.runStartedMs = millis();
  gExecutive.phaseStartedMs = gExecutive.runStartedMs;
  initializeRuntimeOverallSpeed(true);

  resetEventConfirmation();
  resetCorridorConfirmation();
  resetDrivePidControl();
  resetImuPid();
  resetFrontPid();

  gCurrentScreen = Screen::RunScreen;
}

static void finishExecutionAt(uint32_t stopMs) {
  stopAll();
  syncOverallSpeedActualToTarget();

  uint32_t effectiveStopMs = stopMs;
  if (effectiveStopMs < gExecutive.runStartedMs) {
    effectiveStopMs = millis();
  }

  uint32_t durationMs = effectiveStopMs - gExecutive.runStartedMs;
  gPlanner.lastAttemptDurationMs = durationMs;
  AttemptRecord& record = plannerRecordForMode(gPlanner.currentAttemptRecordMode);
  record.valid = true;
  record.hadDeadEnd = gPlanner.currentAttemptHadDeadEnd;
  record.durationMs = durationMs;
  record.chosenMode = gPlanner.currentAttemptExecutionMode;

  if (currentRouteMode() == RouteMode::Sequence) {
    gPlanner.totalDurationMs += durationMs;
    if (gPlanner.sequenceSlot >= 2) {
      gPlanner.sequenceCycleComplete = true;
      gPlanner.sequenceSlot = 0;
    } else {
      gPlanner.sequenceSlot++;
    }
  }

  gExecutive.running = false;
  gExecutive.state = NavState::Finished;
  gExecutive.displayEvent = EventType::Finish;
  gExecutive.latchedEvent = EventType::Finish;
  gExecutive.finishArmed = false;
  gExecutive.tJunctionRaised = false;
  gExecutive.deadEndRaised = false;
  gFinishInterrupt.pending = false;
  gFinishInterrupt.stopMs = 0;

  gCurrentScreen = Screen::StartConfirm;
}

void finishExecution() {
  finishExecutionAt(millis());
}

static void enterPhase(NavState state, EventType displayEvent) {
  gExecutive.state = state;
  gExecutive.displayEvent = displayEvent;
  gExecutive.phaseStartedMs = millis();
  if (state == NavState::FrontNormalize) {
    setOverallSpeedActual(0.0f);
  } else {
    gOverallSpeedUpdateMs = millis();
  }
  resetFrontPid();
  resetCorridorConfirmation();
  resetEventConfirmation();
}

static bool eventTriggersEnabledForState(NavState state) {
  // Navigation events are only allowed to trigger while we are freely driving
  // the corridor. Once an event has been confirmed and we are handling it
  // (approach / wait / reacquire), triggering stays disabled until corridor
  // operation resumes again.
  return state == NavState::Corridor;
}

static void requestFinishInterrupt() {
  if (gFinishInterrupt.pending || !gExecutive.running) return;
  gExecutive.finishArmed = false;
  gFinishInterrupt.pending = true;
  gFinishInterrupt.stopMs = millis();
}

static bool serviceFinishInterrupt() {
  if (!gFinishInterrupt.pending) return false;
  uint32_t stopMs = gFinishInterrupt.stopMs;
  finishExecutionAt(stopMs);
  return true;
}

static bool tryHandleRuntimeFinish(const PerceptionFrame& frame) {
  // Finish is a special-case terminal event: once the finish geometry is
  // truly confirmed, we should stop the timer, save the attempt result, and
  // return to StartConfirm immediately even if we were in an event-handling
  // phase. Other event types remain gated to corridor-driving only.
  if (frame.candidate != EventType::Finish) {
    if (!eventTriggersEnabledForState(gExecutive.state)) {
      resetEventConfirmation();
    }
    return false;
  }

  EventType confirmed = EventType::Idle;
  if (updateEventConfirmation(frame, confirmed) && confirmed == EventType::Finish) {
    requestFinishInterrupt();
    return true;
  }

  return false;
}

static void startPreviewPhase(NavState state, EventType displayEvent) {
  gPreviewRun.state = state;
  gPreviewRun.displayEvent = displayEvent;
  gPreviewRun.phaseStartedMs = millis();
  if (state == NavState::FrontNormalize) {
    setOverallSpeedActual(0.0f);
  } else {
    gOverallSpeedUpdateMs = millis();
  }
  resetFrontPid();
  gPreviewRun.eventConfirm.active = false;
  gPreviewRun.eventConfirm.candidate = EventType::Idle;
  gPreviewRun.eventConfirm.matches = 0;
  gPreviewRun.eventConfirm.nextCheckMs = 0;
  gPreviewRun.eventConfirm.lastSampleId = 0;
  gPreviewRun.corridorConfirm.active = false;
  gPreviewRun.corridorConfirm.matches = 0;
  gPreviewRun.corridorConfirm.nextCheckMs = 0;
  gPreviewRun.corridorConfirm.lastSampleId = 0;
}

void startPreviewExecution() {
  gPreviewRun.active = true;
  gPreviewRun.heading = headingFromIndex(activeSettings.startHeadingIndex);
  gPreviewHeading = gPreviewRun.heading;
  gPreviewRun.pendingHeading = gPreviewRun.heading;
  gPreviewRun.correctionConfirmEnabled = true;
  gPreviewRun.postCorrectionReleaseActive = false;
  gPreviewRun.finishArmed = false;
  gPreviewRun.tJunctionRaised = false;
  gPreviewRun.deadEndRaised = false;
  gPreviewRun.displayEvent = EventType::Start;
  gPreviewRun.latchedEvent = EventType::Start;
  gPreviewRun.startedMs = millis();
  gPreviewRun.phaseStartedMs = gPreviewRun.startedMs;
  initializeRuntimeOverallSpeed(true);
  startPreviewPhase(NavState::StartSeek, EventType::Start);
}
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
