GeorgeKonovalov/Daedalus-group---Maze-Solver---Team-Skynet/(commit log)

2025-11-24 Create Base Wheel.prt
    [Base Wheel.prt]
2025-11-24 Servo from GrabCAD
    [Parallax-Servo-ASM_asm.prt]
2025-11-24 Create Parallax Servo.PNG
2025-12-01 Add event-based DFS maze solver implementation
    This file implements an event-based depth-first search (DFS) maze solver for a robot using IR sensors. It includes functions for navigating the maze, classifying locations, and managing a stack for backtracking.
2025-12-03 Update Base Wheel.prt
    [Base Wheel.prt]
2026-01-27 Create hex nut style 1 gradeab_iso_ISO - 4032 - M2 - W - N.m3d
2026-01-27 Create socket head cap screw_iso_ISO 4762 M2 x 20 - 16N.m3d
2026-01-27 Create ~$ad Gear.m3~
2026-01-27 Create Lead Gear.m3d.bak
2026-01-27 Create Lead Gear.m3d
2026-02-01 Update ~$ad Gear.m3~
2026-02-01 Update Lead Gear.m3d.bak
2026-02-01 Update Lead Gear.m3d
2026-02-01 Create ~$rallax-Servo-Horn.m3~
2026-02-02 Create Lead Gear.stl
    [Lead Gear.stl]
2026-02-02 Updated PCB
    [Maze solver.kicad_pcb]
2026-02-08 Model Update + NEW PRINTS
    Kamal, please, read the instruction about the prints
    [Gearbox_Housing_Cap.stl, Lead Gear.stl, Lead_Gear_Cap.stl, Middle_1mm.stl]
2026-02-08 STL update (additional screws)
    Screw holes are added for better rigidity of the sensor located on the Gearbox
    [Gearbox_Housing_Cap.stl]
2026-02-12 Uploaded Finalised Schematic Draft
    [Maze Solver Finalisation.kicad_sch]
2026-02-12 Wheel test code
    All servos zero states are tuned
2026-02-14 tuned_wasd update
    5V version
    Most probably should be updated after the switch to the higher voltage
2026-02-17 Add files via upload
    test code for uart connection
2026-02-22 Uploaded verified schematic and PCB
    [Maze Solver Finalisation.kicad_pcb, Maze Solver Finalisation.kicad_sch]
2026-02-22 Create IR Gerber
2026-02-22 Uploaded IR Gerber files
2026-02-22 Uploaded Main Gerber Files
2026-02-25 PCB holders
    PCB holder
    Ultrasonic holder
    Idea for adjusted gearbox
    [Platform_PCB.stl]
2026-02-25 Upadate pCB
2026-03-06 Rover Systematic layout update (for CDR)
    [49min_IR_PCB_holder.3mf, 53min_Middle_1.85mm_.3mf, IR_PCB_holder.stl]
2026-03-15 LCD + Digipot holder
    [1hour57minutes.3mf, Digipot_holder.stl, Middle_1.80mm_cut.stl, Middle_1.85mm.stl, Middle_1mm_cut_45.6.stl]
2026-04-05 TEST Voltage on RP2040
    Wasn't upload on my PC
2026-04-06 Model update
    [25m_PLA.3mf, Switch_toggle_Holder.stl]
2026-04-07 maze algorith test, no motors
2026-04-07 LED Scoop + Renewed AtmegaCode + Menu Update
2026-04-07 test algorithm without motors
2026-04-08 health test for motors
2026-04-08 fixed servo function
2026-04-08 updated gains on pid corridor test
2026-04-08 swapped north south ultrasound values
    [PID_Corridor_Test_RP2040.ino]
2026-04-09 New PID initial values
2026-04-09 WiFi sampled
2026-04-09 inverted motor response
2026-04-09 flipped east west sensors
    [Merged_Test.ino]
2026-04-10 Full-testы
2026-04-11 new test code for averaged ultrasound sensors
2026-04-11 test 10 (renewed logic + PID for single wall)
2026-04-11 New versions
    v.11 and v.12 detects really badly (v.9 is the best currently)
2026-04-13 v.18 + symmetric PID trial
    PID based on magnitude and sign
2026-04-13 New Tunings
    [test_full_v22_settings_layout.csv]
2026-04-13 new layout of settings
    +explaination table for functions
    [test_full_v23_settings_layout.csv]
2026-04-14 update
    beginning of IMU implementation
    new folder
    renewed logic
    [test_full_v22_settings_layout.csv, test_full_v23_settings_layout.csv, test_full_v25_settings_layout.csv, test_full_v26_settings_layout.csv, test_full_v27_settings_layout.csv]
2026-04-14 IMU implemented
    IMU implemented (badly) - better without one
    [test_full_v28_settings_layout.csv]
2026-04-14 Tests update IMU
    IMU fixed attempt
    [test_full_v29_settings_layout.csv, test_full_v31_settings_layout.csv]
2026-04-14 PID checks continuation
    [test_full_v32_settings_layout.csv, test_full_v33_settings_layout.csv, test_full_v34_settings_layout.csv, test_full_v35_settings_layout.csv, test_full_v36_settings_layout.csv]
2026-04-15 reorganisation and menu update and fixed logic
    [test_full_v37_settings_layout.csv]
2026-04-16 motors settings update
    reverse speed is cancelled for control
    + overall speed update
    [test_full_v37_settings_layout.csv]
2026-04-16 Suspension test files - Models
    New test for the suspension CAD files
2026-04-16 timing optimisation
    [test_full_v37_settings_layout.csv, test_full_v38_settings_layout.csv, test_full_v39_settings_layout.csv]
2026-04-16 changes in directions
    messed up sensors 180 degrees
    [test_full_v40_settings_layout.csv, test_full_v41_settings_layout.csv, test_full_v42_settings_layout.csv, test_full_v43_settings_layout.csv, test_full_v44_settings_layout.csv, test_full_v45_settings_layout.csv]
2026-04-17 PID test + menu fixed glitches
    v.48 - normalised PID test
    v.47 - fixed menu glitches
    [test_full_v47_settings_layout.csv, test_full_v48_settings_layout.csv]
2026-04-18 tuned PID + fixed IMU
    [test_full_v49_settings_layout.csv]
2026-04-19 1/2 wall PID, IMU lateral PID, Event recognition changes
    Finish after T-junction
    [test_full_v50_settings_layout.csv, test_full_v51_settings_layout.csv, test_full_v52_settings_layout.csv, test_full_v53_settings_layout.csv, test_full_v54_settings_layout.csv, test_full_v55_settings_layout.csv, test_full_v56_settings_layout.csv, test_full_v57_settings_layout.csv]
2026-04-20 assembled CAD + front compensation code
    [Power Switch.SLDPRT, Power Switch.STEP, Power Switch.STL, Vertical Potentiometer 15mm Axis.step, elec switch.SLDPRT, test_full_v59_settings_layout.csv, Потенциометр Ручка.STEP]
2026-04-22 new code and back to previous
    [DIN-912-M3.STEP, M3-NUTS.STEP, test_full_v61_settings_layout.csv]
2026-04-22 new code works not well
    [_excel_probe.xlsx, test_full_v63_stopconfirm_parameters.xlsx, test_full_v64_execresume_parameters.xlsx, test_full_v65_postcorr_logic_parameters.xlsx, test_full_v66_startcorr_parameters.xlsx, test_full_v67_deadend_ultra_parameters.xlsx]
2026-04-22 final version untuned
    [test_full_v68_startrelease_parameters.xlsx]
